Kenkneeshio/SeniorDesign-Team9/Pictures/Heatsink_2023-Sep-17_01-45-36PM-000_CustomizedView2093960837_png_alpha.png

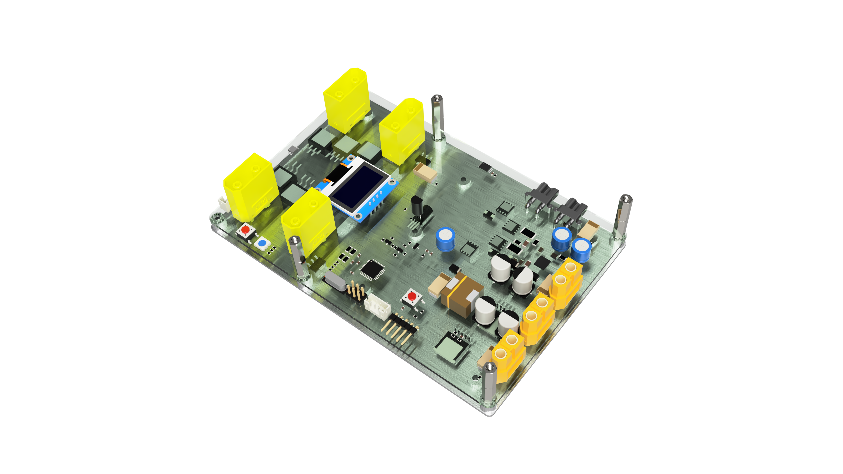
Pictures/Heatsink_2023-Sep-17_01-45-36PM-000_CustomizedView2093960837_png_alpha.png
