Kenkneeshio/SeniorDesign-Team9/README.md

# SeniorDesign-Team9

Currently the GitHub Repo ignores .zip and .raw to save space
