Kenkneeshio/SeniorDesign-Team9/Documentation/Prototype Activity Temperature scannings/FLIR0036.jpg

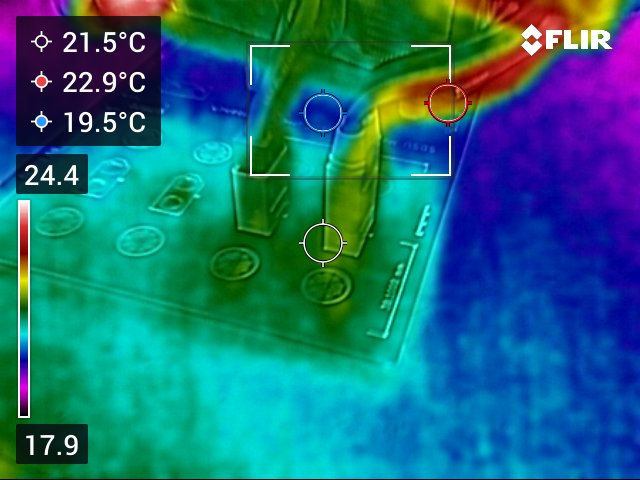
Documentation/Prototype Activity Temperature scannings/FLIR0036.jpg
