Kenkneeshio/SeniorDesign-Team9/Documentation/Prototype Activity Temperature scannings/FLIR0037.jpg

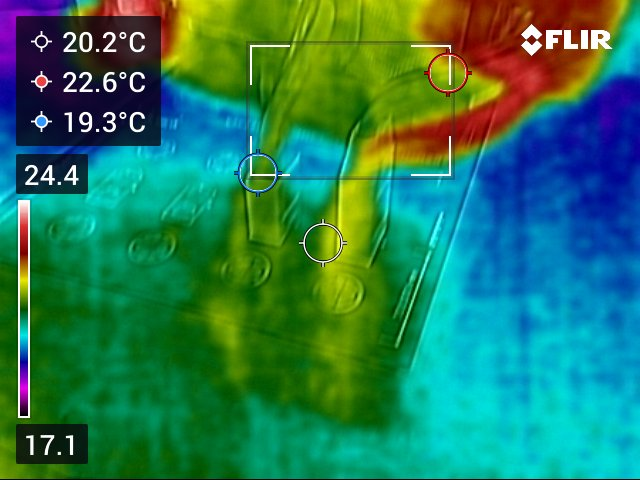
Documentation/Prototype Activity Temperature scannings/FLIR0037.jpg
