Kenkneeshio/SeniorDesign-Team9/Documentation/Prototype Activity Temperature scannings/FLIR0038.jpg

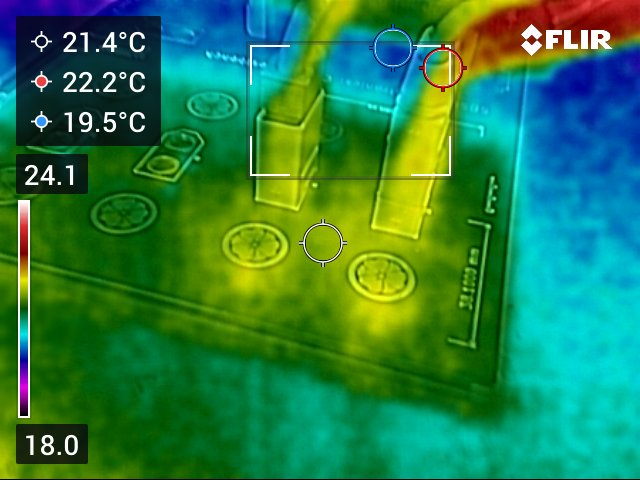
Documentation/Prototype Activity Temperature scannings/FLIR0038.jpg
