Kenkneeshio/SeniorDesign-Team9/Documentation/Prototype Activity Temperature scannings/FLIR0039.jpg

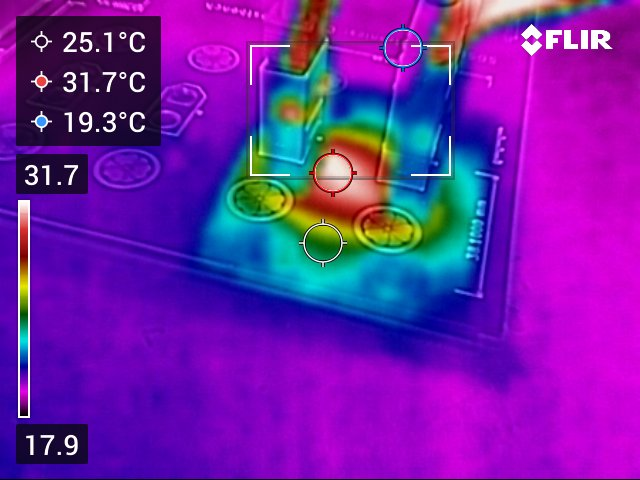
Documentation/Prototype Activity Temperature scannings/FLIR0039.jpg
