Kenkneeshio/SeniorDesign-Team9/Documents/Graphics/0PAL4100XP.png

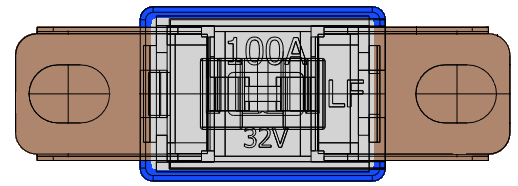
Documents/Graphics/0PAL4100XP.png
