Kenkneeshio/SeniorDesign-Team9/Documents/Graphics/bg.png

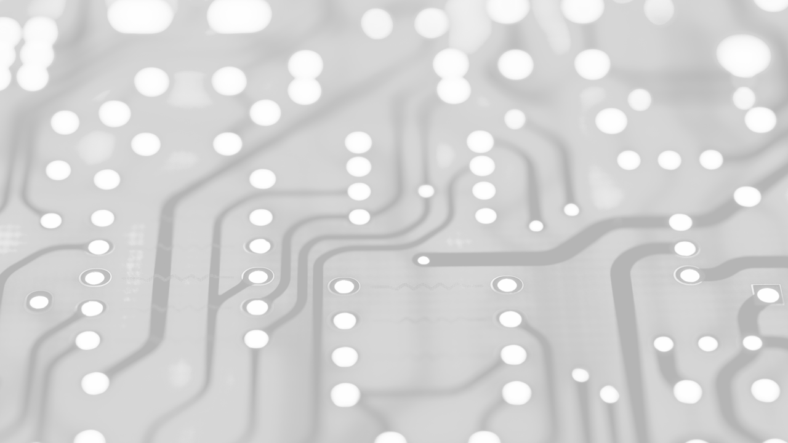
Documents/Graphics/bg.png
