Kenkneeshio/SeniorDesign-Team9/Documents/Graphics/current sharing.png

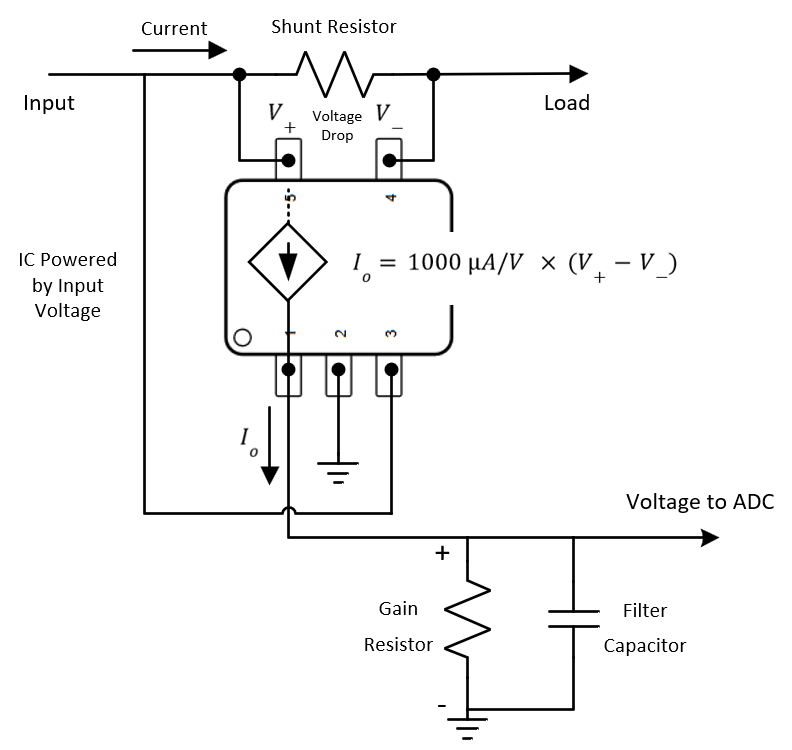
Documents/Graphics/current sharing.png
