Kenkneeshio/SeniorDesign-Team9/Documents/Graphics/load sharing.png

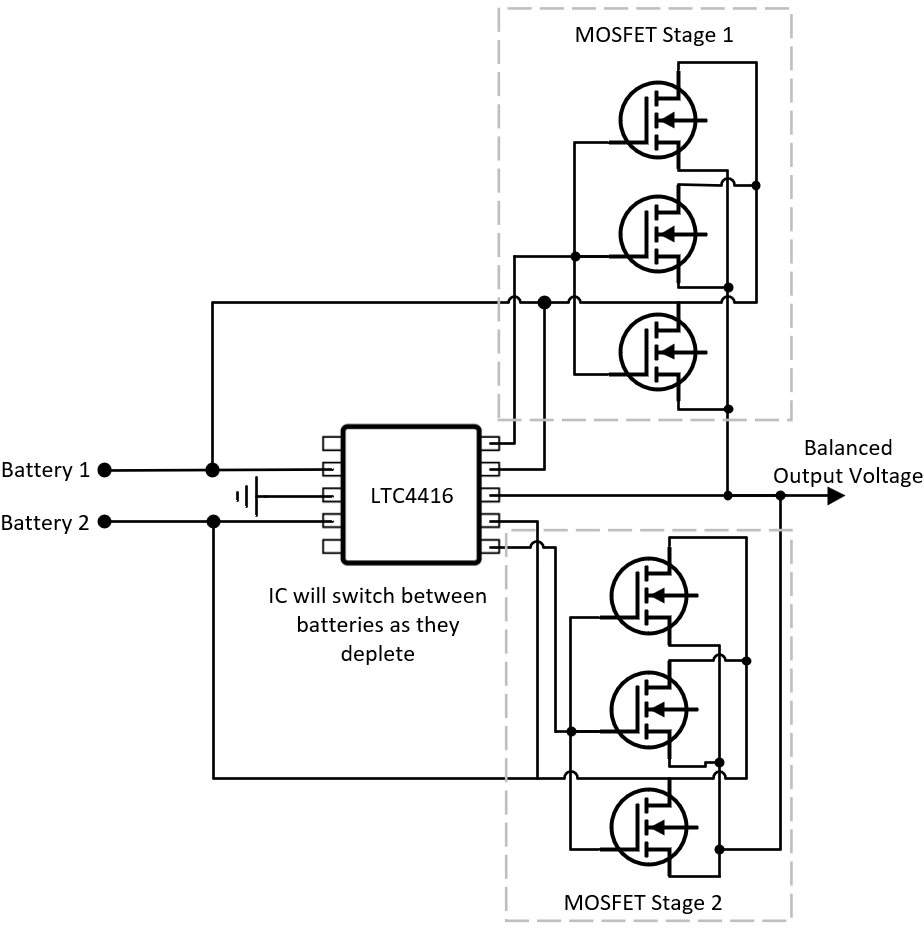
Documents/Graphics/load sharing.png
