Kenkneeshio/SeniorDesign-Team9/Documents/Graphics/microcontroller.png

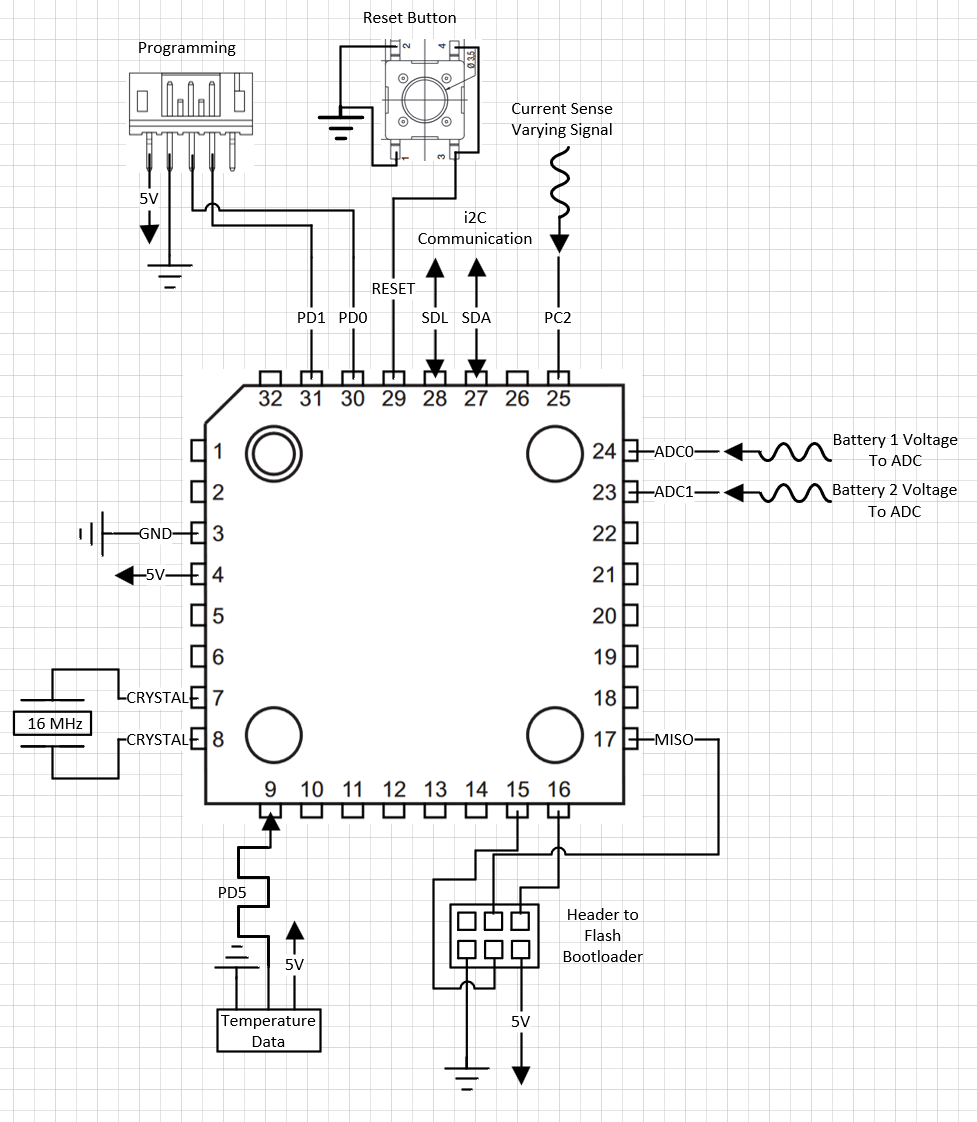
Documents/Graphics/microcontroller.png
