Kenkneeshio/SeniorDesign-Team9/Documents/Graphics/rps-01_board_only.png

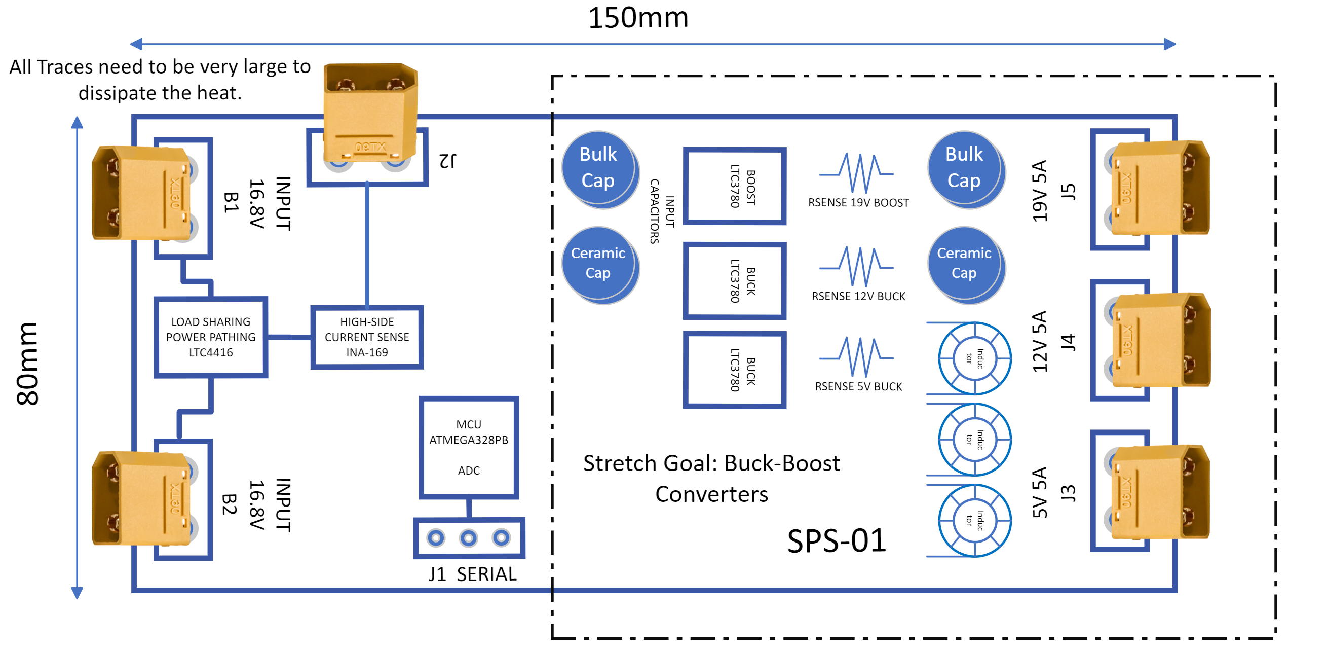
Documents/Graphics/rps-01_board_only.png
