Kenkneeshio/SeniorDesign-Team9/Documents/Graphics/rps-01_design_31023.png

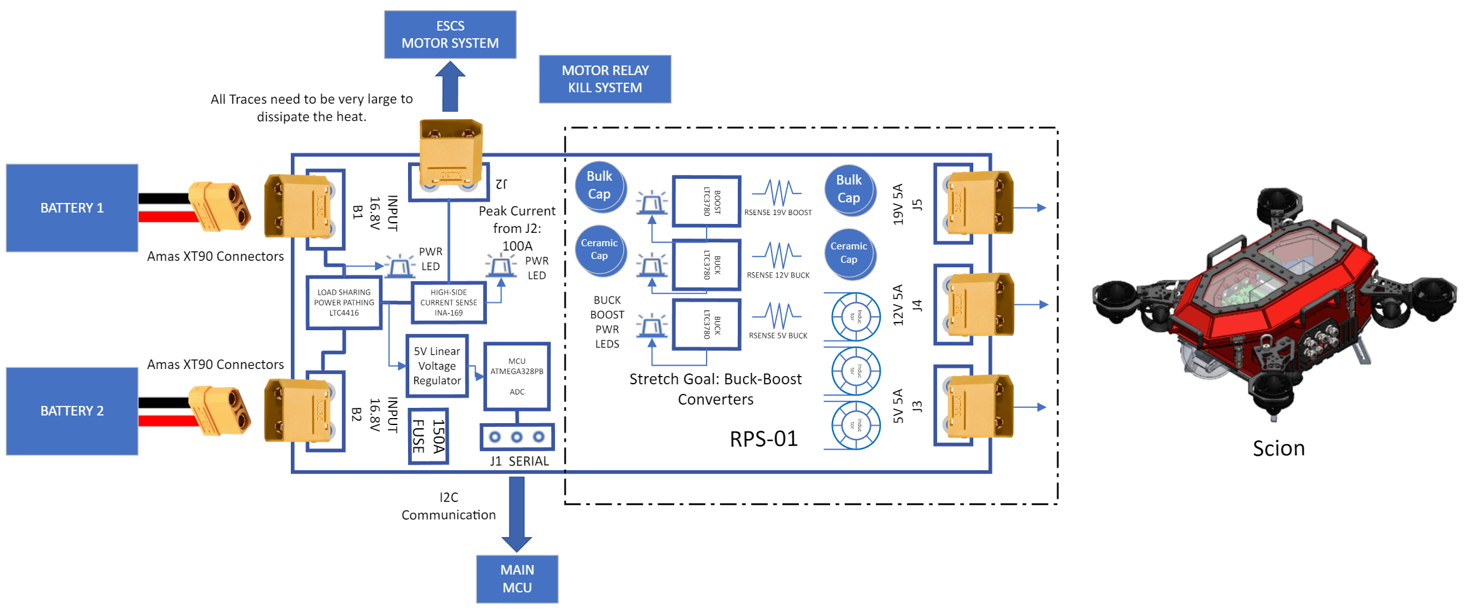
Documents/Graphics/rps-01_design_31023.png
