Kenkneeshio/SeniorDesign-Team9/Documents/Graphics/system design.png

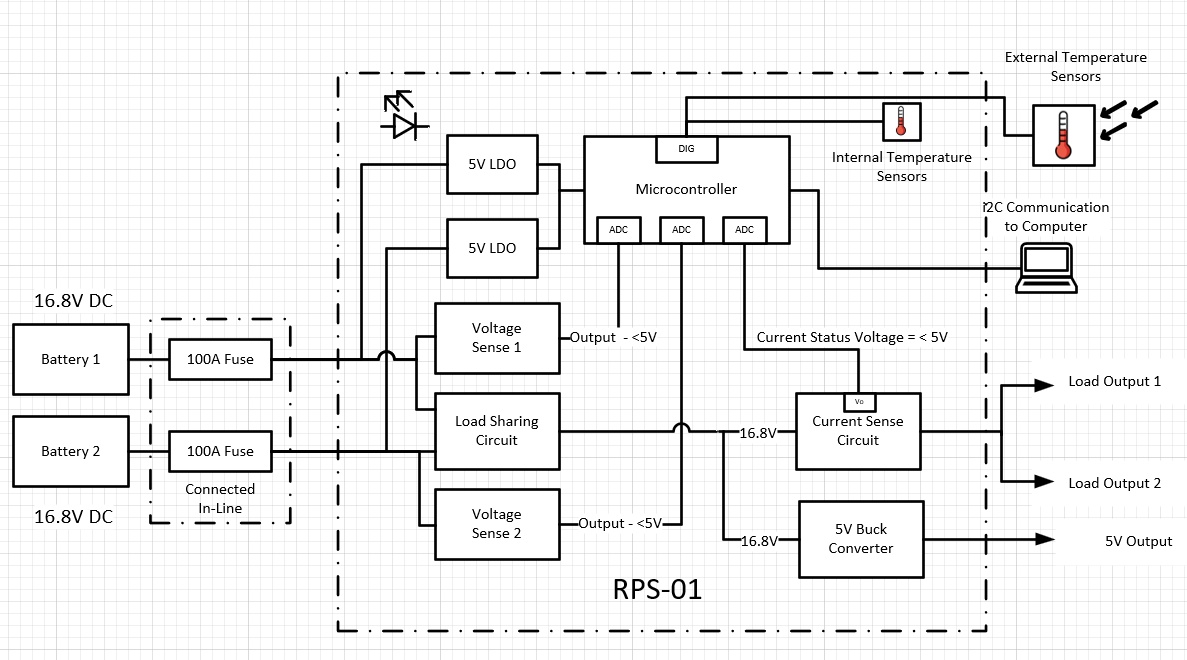
Documents/Graphics/system design.png
