Kenkneeshio/SeniorDesign-Team9/Documents/Graphics/xt90_male_warpfix.png

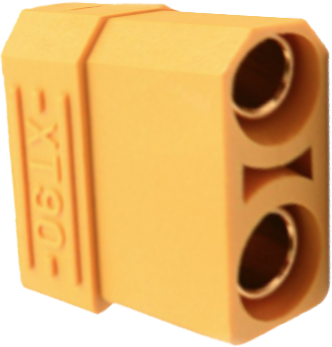
Documents/Graphics/xt90_male_warpfix.png
