Kenkneeshio/SeniorDesign-Team9/KiCad/RPS01-Revision 2/3d/render-bottom-heatsink.png

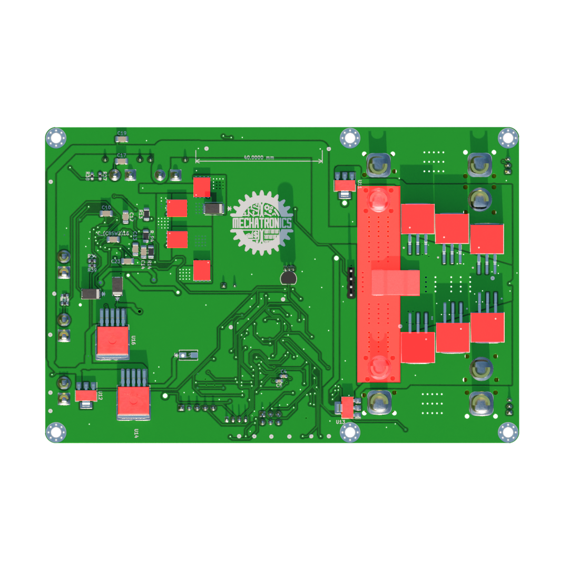
KiCad/RPS01-Revision 2/3d/render-bottom-heatsink.png
