Kenkneeshio/SeniorDesign-Team9/KiCad/Symbols Footprints and Models/0PAL4100XP/re-scale.png

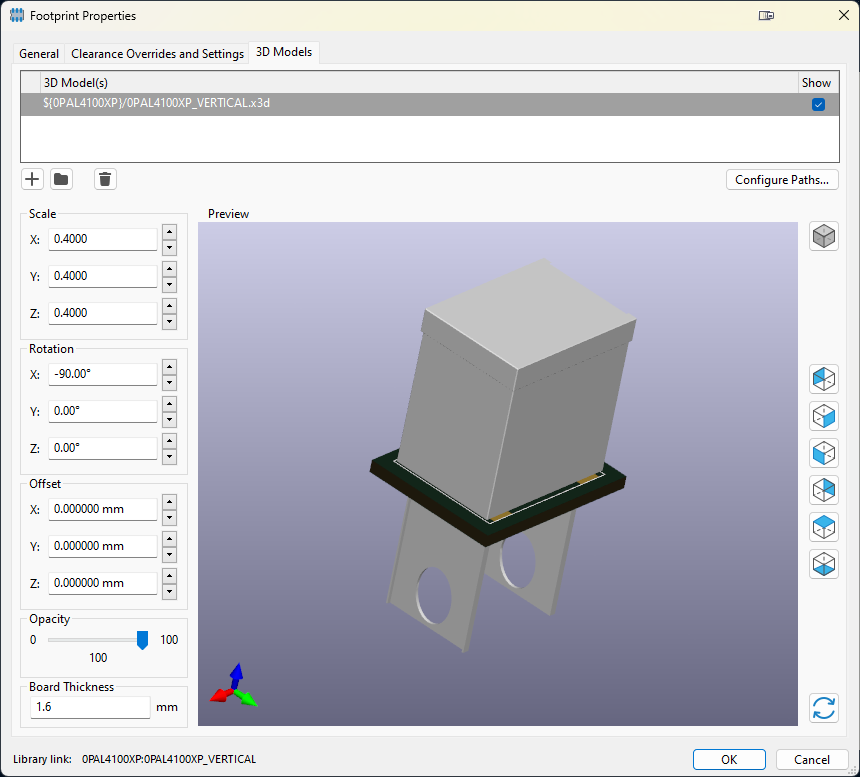
KiCad/Symbols Footprints and Models/0PAL4100XP/re-scale.png
