Kenkneeshio/SeniorDesign-Team9/Nice Mind vcminds/Mechatronics Disiciples.png

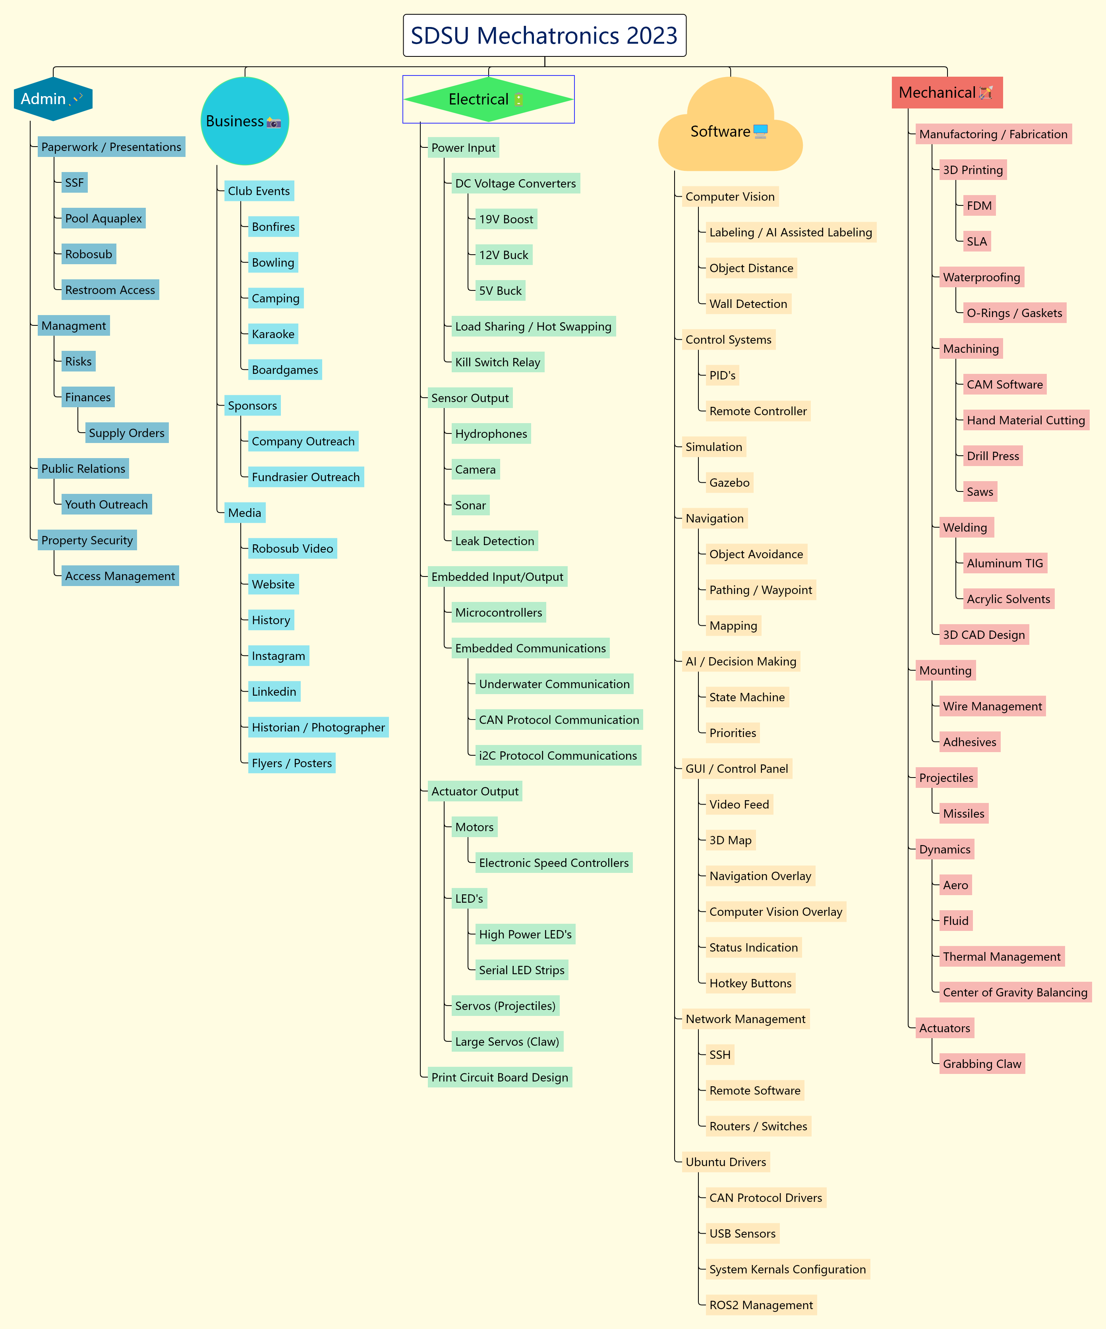
Nice Mind vcminds/Mechatronics Disiciples.png
