Kenkneeshio/SeniorDesign-Team9/Pictures/Heatsink_2023-Oct-08_06-53-45AM-000_CustomizedView12135911496_png.png

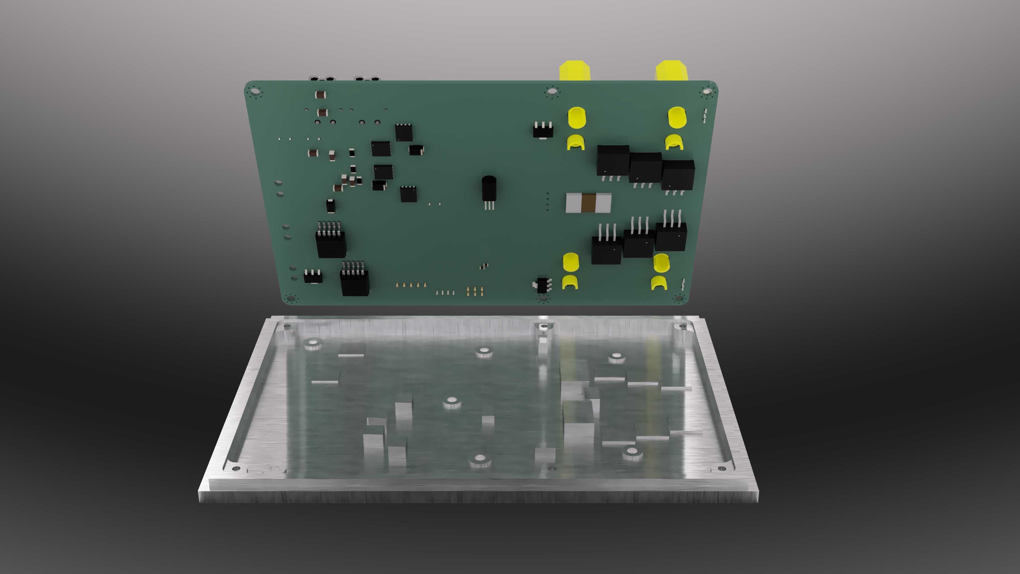
Pictures/Heatsink_2023-Oct-08_06-53-45AM-000_CustomizedView12135911496_png.png
