Kenkneeshio/SeniorDesign-Team9/Pictures/Heatsink_2023-Sep-17_01-18-48PM-000_CustomizedView3156353393_png_alpha.png

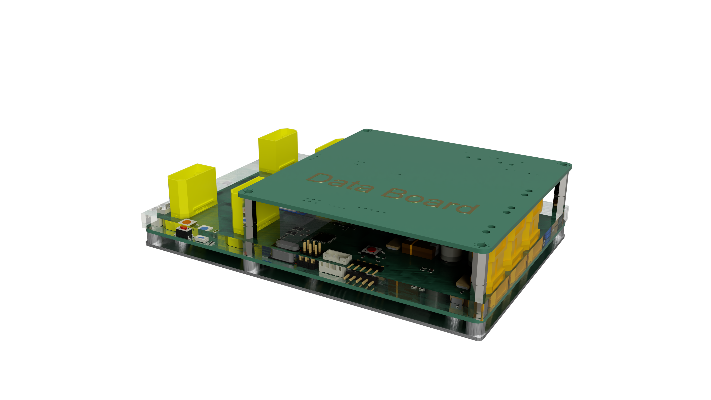
Pictures/Heatsink_2023-Sep-17_01-18-48PM-000_CustomizedView3156353393_png_alpha.png
