Kenkneeshio/SeniorDesign-Team9/Pictures/Heatsink_2023-Sep-17_01-31-28PM-000_CustomizedView29015575525_png.png

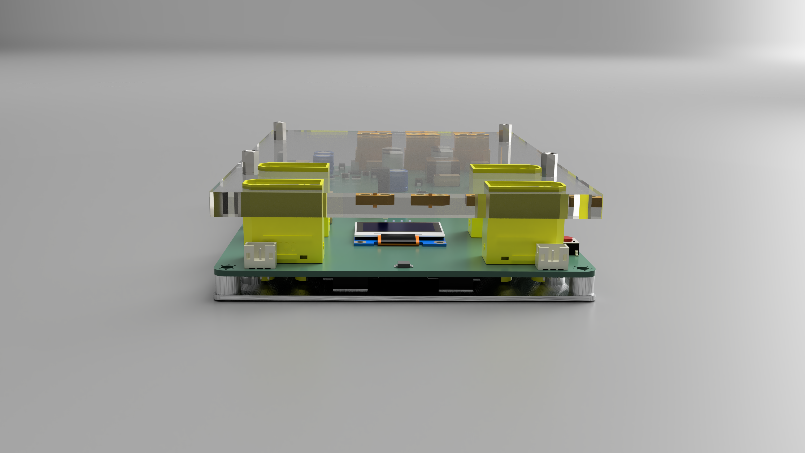
Pictures/Heatsink_2023-Sep-17_01-31-28PM-000_CustomizedView29015575525_png.png
