Kenkneeshio/SeniorDesign-Team9/Pictures/Heatsink_2023-Sep-21_07-10-01AM-000_CustomizedView16427578200_png_alpha.png

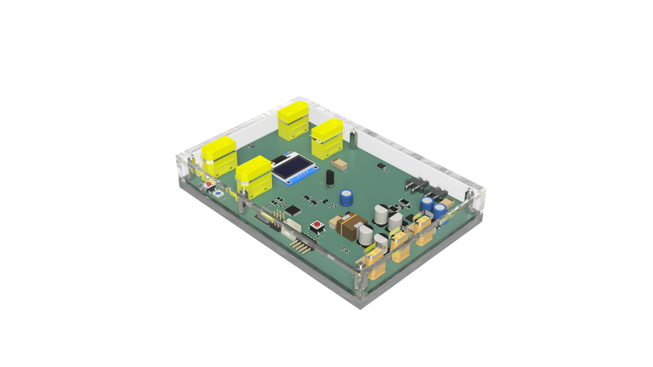
Pictures/Heatsink_2023-Sep-21_07-10-01AM-000_CustomizedView16427578200_png_alpha.png
