Kenkneeshio/SeniorDesign-Team9/Simulations/LTC3780 Reference Simulations and Resources/1155A reference PCB/1155acf.xls

Item | Qty | Reference | Part Description | Manufacturer / Part #
 |  | REQUIRED CIRCUIT COMPONENTS:
1 | 3 | C1,C2,C3 | CAP., X5R 10uF 35V 20% 1206 | TAIYO YUDEN GMK316BJ106ML-T
2 | 3 | C4,C10,C22 | CAP., X5R 0.22uF 16V 20% 0603 | TAIYO YUDEN EMK107BJ224MA-T
3 | 3 | C5,C6,C9 | CAP., X5R 22uF 16V 20% 1210 | TAIYO YUDEN EMK325BJ226MM-T
4 | 1 | C11 | CAP., NPO 68pF 50V 10% 0603 | AVX 06035A680KAT2A
5 | 1 | C12 | CAP., X7R 3.3nF 25V 10% 0603 | AVX 06033C3300KAT2A
6 | 1 | C23 | CAP., X7R 0.01uF 25V 10% 0603 | AVX 06033C103KAT2A
7 | 1 | C13 | CAP., NPO 47pF 50V 10% 0603 | AVX 06035A470KAT2A
8 | 1 | C14 | CAP., X7R 0.1uF 50V 10% 0603 | TAIYO YUDEN UMK107BJ104MA-T
9 | 1 | C15 | CAP., X5R 1uF 10V 20% 0603 | TAIYO YUDEN LMK107BJ105MA-T
10 | 1 | C18 | CAP., X5R 4.7uF 10V 20% 0603 | TAIYO YUDEN LMK107BJ475MA-T
11 | 2 | C21,C19 | CAP., NPO 1000pF 25V 10% 0603 | AVX 06033A102KAT2A
12 | 1 | C24 | CAP., NPO 1nF 50V 10% 0603 | AVX 06035A102KAT2A
13 | 1 | D1 | Zener Diode, 4.7V SOD-523 | On Semi. MM5Z4V7T1G
14 | 1 | D3 | Zener Diode, 36V SOT-23 | DIODES INC. BZX84C36-7-F
15 | 3 | D4,D6,D7 | Schottky Barrier Diode SOD-123 | DIODES INC. B0540W-7
16 | 1 | D5 | Schottky Barrier Diode SOD-123 | DIODES INC. 1N5819HW-7-F
17 | 1 | L1 | INDUCTOR, 10uH | VISHAY , IHLP-4040DZER10R0M11
18 | 2 | Q1,Q2 | DUAL N-CHANMOSFET., 40V SO8 | VISHAY SILICONIX SI4942DY-T1-E3
19 | 2 | R5,R8 | RES., CHIP 10 0.1W 5% 0603 | VISHAY, CRCW060310R0JNEA
20 | 1 | R7 | RES., CHIP 10K 0.1W 5% 0603 | VISHAY, CRCW060310K0JNEA
21 | 1 | R20 | RES., CHIP 12.4K 0.1W 1% 0603 | VISHAY, CRCW060312K4FKEA
22 | 2 | R9,R10 | RES., CHIP 100 0.1W 1% 0603 | VISHAY, CRCW0603100RFKEA
23 | 1 | R11 | RES., CHIP 30K 0.1W 5% 0603 | VISHAY, CRCW060330K0JNEA
24 | 1 | R12 | RES., CHIP 113K 0.1W 1% 0603 | VISHAY, CRCW0603113KFKEA
25 | 1 | R13 | RES., CHIP 8.06K 0.1W 1% 0603 | VISHAY, CRCW06038K06FKEA
26 | 1 | R15 | RES., CHIP 51K 0.1W 5% 0603 | VISHAY, CRCW060351K0JNEA
27 | 1 | R19 | RES., CHIP 0.025 1W 1% 0815 | SSM Thin Film Tech. RL3720WT-R025-G-C
28 | 1 | R23 | RES., CHIP 47.5K 0.1W 1% 0603 | VISHAY, CRCW060347K5FKEA
29 | 1 | R25 | RES., CHIP 1 0.1W 5% 0603 | VISHAY, CRCW06031R00JNEA
30 | 2 | R24,R26 | RES., CHIP 0 0.1W 0603 | VISHAY, CRCW06030000Z0EA
31 | 1 | U1 | LTC3780EUH#PBF,5X5mm QFN | LINEAR TECH., LTC3780EUH#PBF
 |  | ADDITIONAL DEMO BOARD CIRCUIT COMPONENTS:
1 | 0 | C16,C20(OPT) | CAP., 0603
2 | 0 | C7,C8(OPT) | CAP., POSCAP D4 SIZE
3 | 0 | R17,R21,R22 (OPT) | RES., 0603
 |  | HARDWARE-FOR DEMO BOARD ONLY:
1 | 1 | JP1 | Headers, 3 Pins 2mm Ctrs. | SAMTEC TMM-103-02-L-S
2 | 3 | JP2A,JP2B,JP2C | Headers, 2 Pins 2mm Ctrs. | SAMTEC TMM-102-02-L-S
3 | 2 | JP1,JP2B | Shunt | SAMTEC 2SN-BK-G
4 | 8 | TP1-TP6,TP8,TP10 | TESTPOINT | MILL-MAX, 2501-2-00-80-00-00-07-00
