Kenkneeshio/SeniorDesign-Team9/CAD Models/0154Series_LTF/0154Series_LTF.step

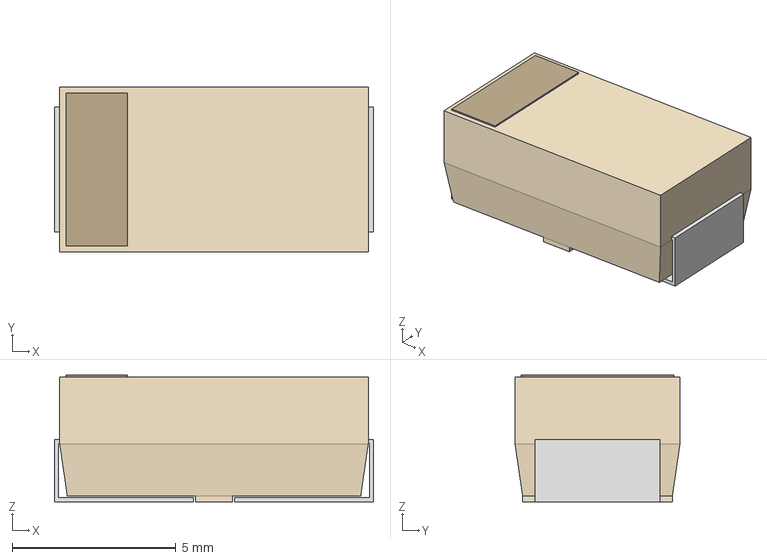
[picture p28: CAD file, 2023-09-11]
CAD Models/0154Series_LTF/0154Series_LTF.step
9.73 x 5.03 x 3.86 mm
