Kenkneeshio/SeniorDesign-Team9/CAD Models/CAP_A750KS_KEM/CAP_A750KS_KEM.step

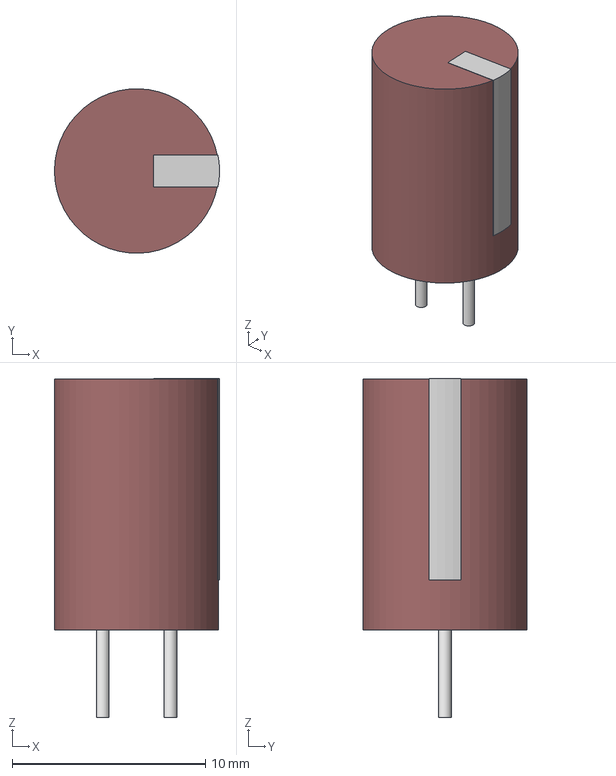
[picture p29: CAD file, 2023-09-13]
CAD Models/CAP_A750KS_KEM/CAP_A750KS_KEM.step
8.54 x 8.50 x 17.5 mm
