Kenkneeshio/SeniorDesign-Team9/CAD Models/IND_CDRH127LDNP-470MC_SUM/IND_CDRH127LDNP-470MC_SUM.step

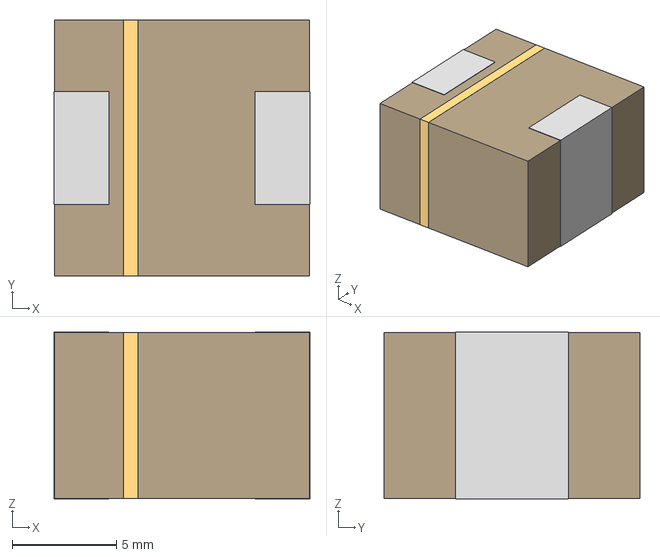
[picture p30: CAD file, 2023-09-12]
CAD Models/IND_CDRH127LDNP-470MC_SUM/IND_CDRH127LDNP-470MC_SUM.step
12.3 x 12.3 x 8.00 mm
