Kenkneeshio/SeniorDesign-Team9/CAD Models/MSOP-10_MS_LIT/MSOP-10_MS_LIT.step

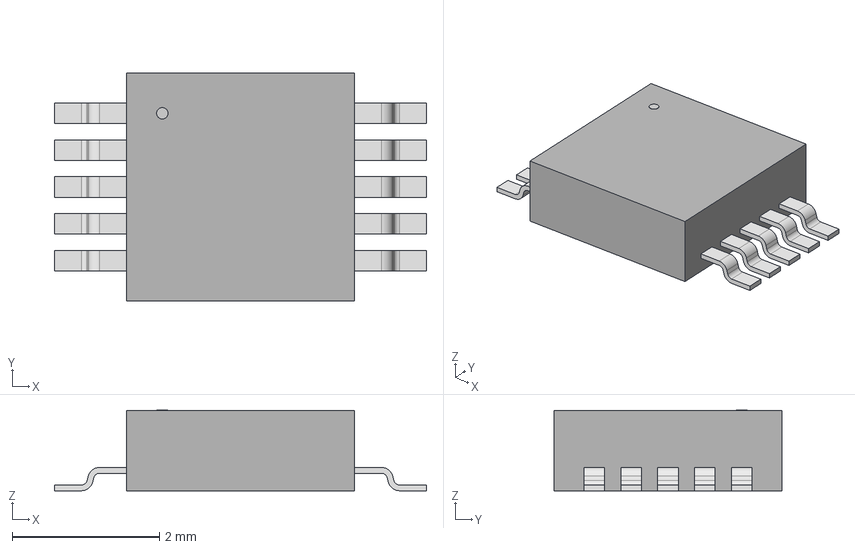
[picture p31: CAD file, 2023-09-11]
CAD Models/MSOP-10_MS_LIT/MSOP-10_MS_LIT.step
5.05 x 3.10 x 1.09 mm
