Kenkneeshio/SeniorDesign-Team9/CAD Models/PG-TDSON-8-U08_INF/PG-TDSON-8-U08_INF.step

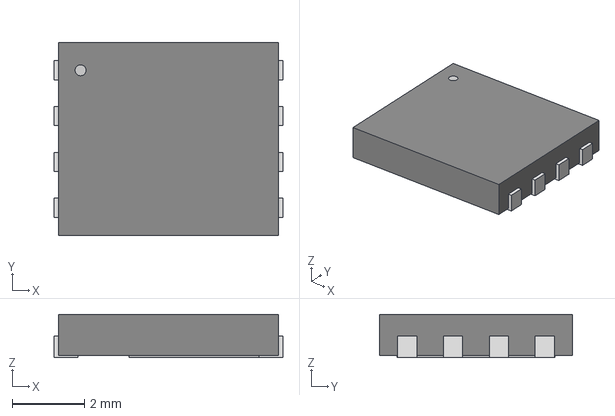
[picture p32: CAD file, 2023-09-12]
CAD Models/PG-TDSON-8-U08_INF/PG-TDSON-8-U08_INF.step
6.35 x 5.36 x 1.20 mm
