Kenkneeshio/SeniorDesign-Team9/CAD Models/PRSS0004AL-A_REN/PRSS0004AL-A_REN.step

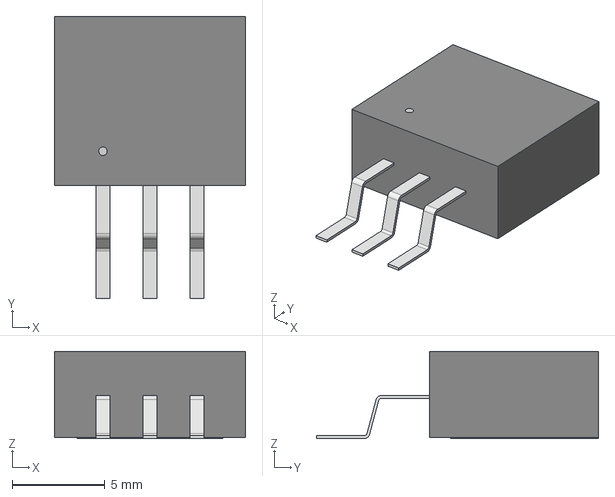
[picture p33: CAD file, 2023-09-11]
CAD Models/PRSS0004AL-A_REN/PRSS0004AL-A_REN.step
10.3 x 15.2 x 4.70 mm
