Kenkneeshio/SeniorDesign-Team9/CAD Models/PW8_TEX/PW8_TEX.step

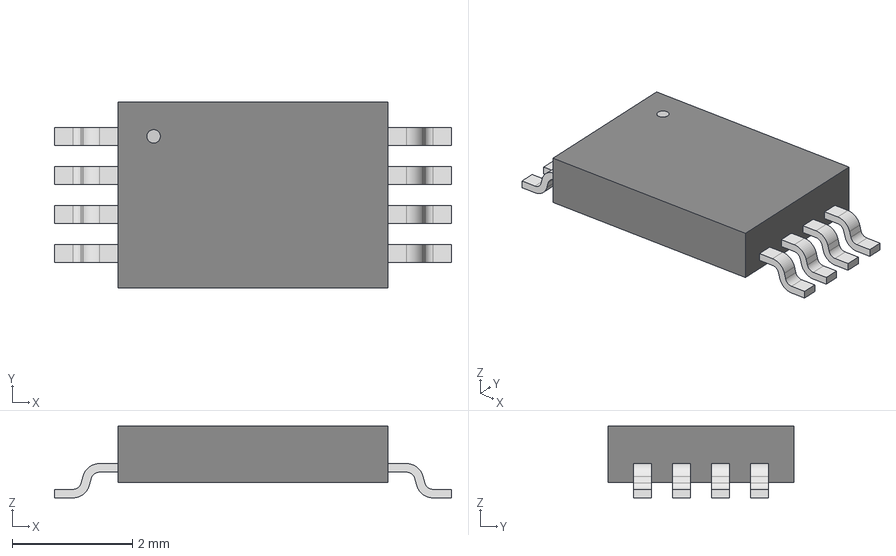
[picture p34: CAD file, 2023-09-11]
CAD Models/PW8_TEX/PW8_TEX.step
6.60 x 3.10 x 1.20 mm
