Kenkneeshio/SeniorDesign-Team9/CAD Models/QFN-32_UH_LIT/QFN-32_UH_LIT.step

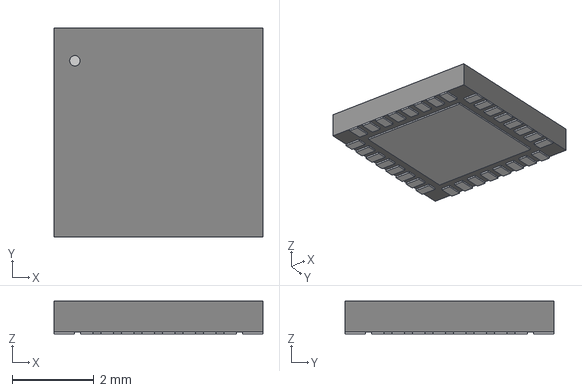
[picture p35: CAD file, 2023-09-13]
CAD Models/QFN-32_UH_LIT/QFN-32_UH_LIT.step
5.10 x 5.10 x 0.803 mm
