Kenkneeshio/SeniorDesign-Team9/CAD Models/RES_5930R_L500x_BRN/RES_5930R_L500x_BRN.step

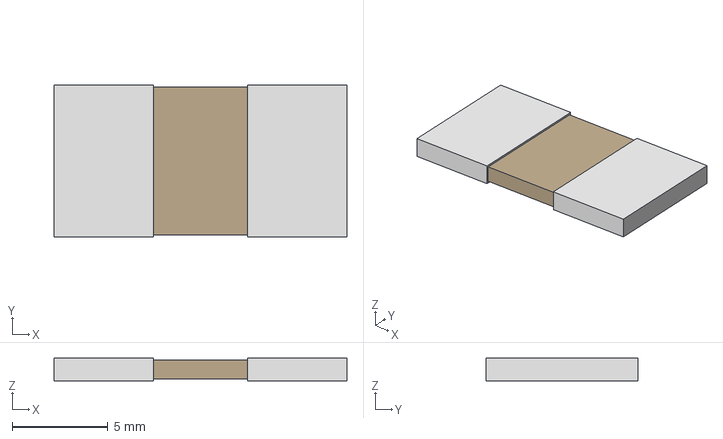
[picture p36: CAD file, 2023-09-11]
CAD Models/RES_5930R_L500x_BRN/RES_5930R_L500x_BRN.step
15.3 x 7.92 x 1.19 mm
