Kenkneeshio/SeniorDesign-Team9/CAD Models/TS2940CW50_RPG.step

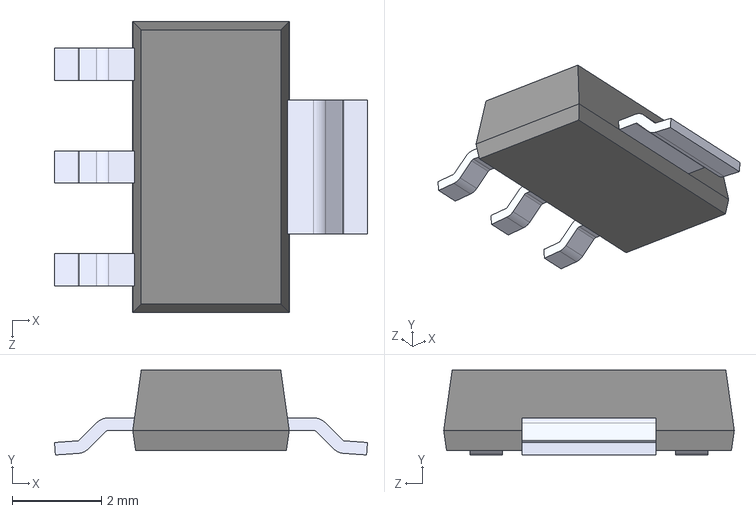
[picture p37: CAD file, 2023-11-14]
CAD Models/TS2940CW50_RPG.step
7.00 x 1.90 x 6.50 mm
