Kenkneeshio/SeniorDesign-Team9/CAD Models/User Library-128x64I2COLEDDisplayAdafruit/User Library-128x64I2COLEDDisplayAdafruit.STEP

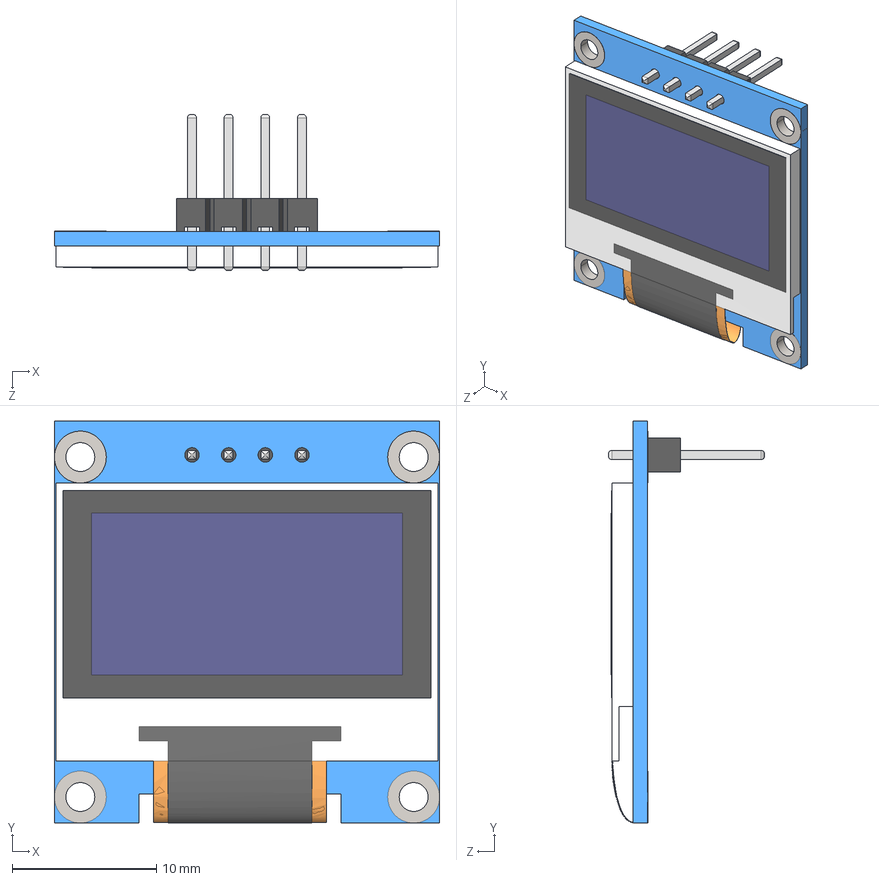
[picture p38: CAD file, 2023-09-08]
CAD Models/User Library-128x64I2COLEDDisplayAdafruit/User Library-128x64I2COLEDDisplayAdafruit.STEP
26.7 x 27.9 x 10.8 mm
