Kenkneeshio/SeniorDesign-Team9/CAD Models/User Library-XT90PB-F/User Library-XT90PB-F.STEP

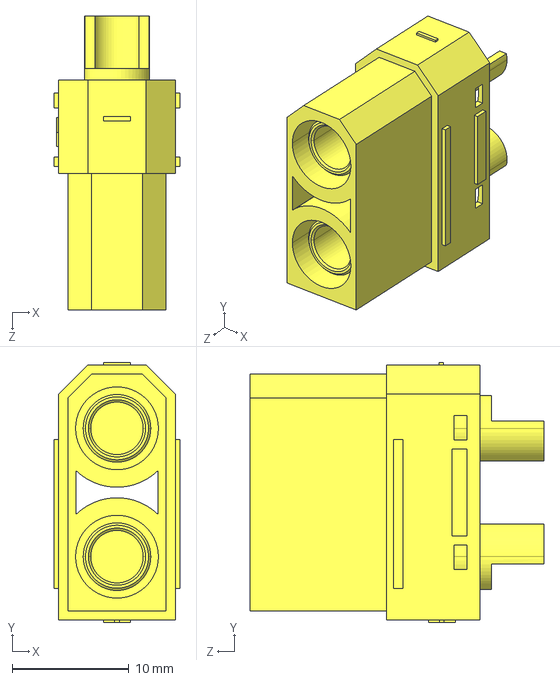
[picture p39: CAD file, 2023-09-08]
CAD Models/User Library-XT90PB-F/User Library-XT90PB-F.STEP
10.8 x 22.3 x 25.2 mm
