Kenkneeshio/SeniorDesign-Team9/CAD Models/User Library-XT90PB-M/User Library-XT90PB-M.STEP

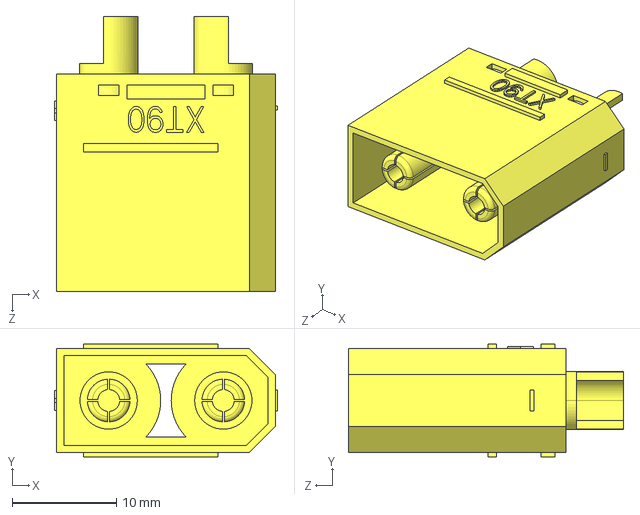
[picture p40: CAD file, 2023-09-08]
CAD Models/User Library-XT90PB-M/User Library-XT90PB-M.STEP
21.4 x 10.8 x 26.4 mm
