Kenkneeshio/SeniorDesign-Team9/CAD Models/xt30-f/User Library-xt30-f.STEP

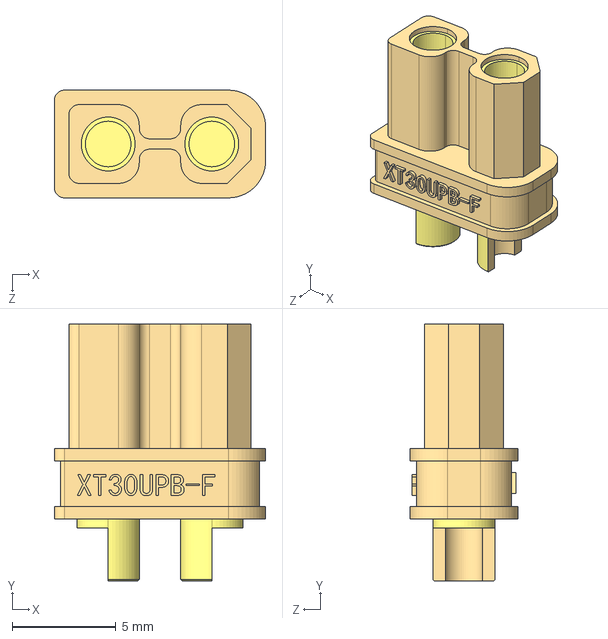
[picture p41: CAD file, 2023-09-17]
CAD Models/xt30-f/User Library-xt30-f.STEP
10.2 x 12.4 x 5.20 mm
