Kenkneeshio/SeniorDesign-Team9/CAD Models/XT30PW-F--3DModel-STEP-510211/XT30PW-F--3DModel-STEP-510211.STEP

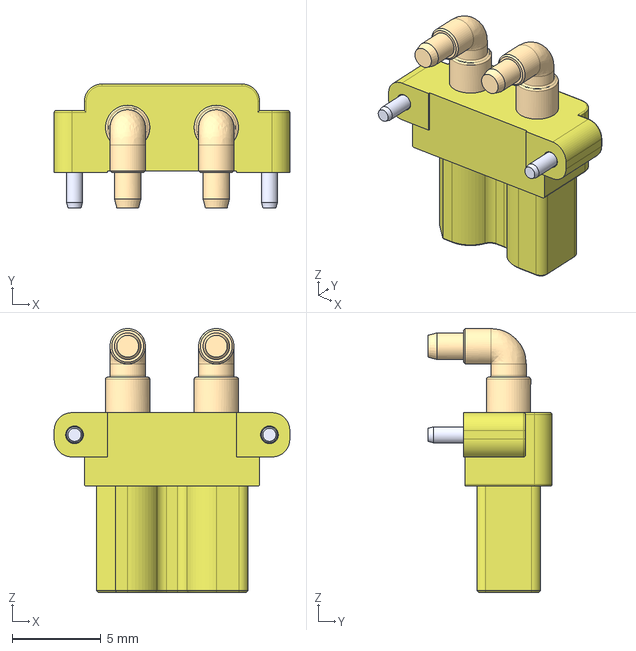
[picture p42: CAD file, 2023-09-13]
CAD Models/XT30PW-F--3DModel-STEP-510211/XT30PW-F--3DModel-STEP-510211.STEP
13.3 x 7.00 x 14.9 mm
