Kenkneeshio/SeniorDesign-Team9/CAD Models/xt30upb-m/User Library-xt30upb-m.STEP

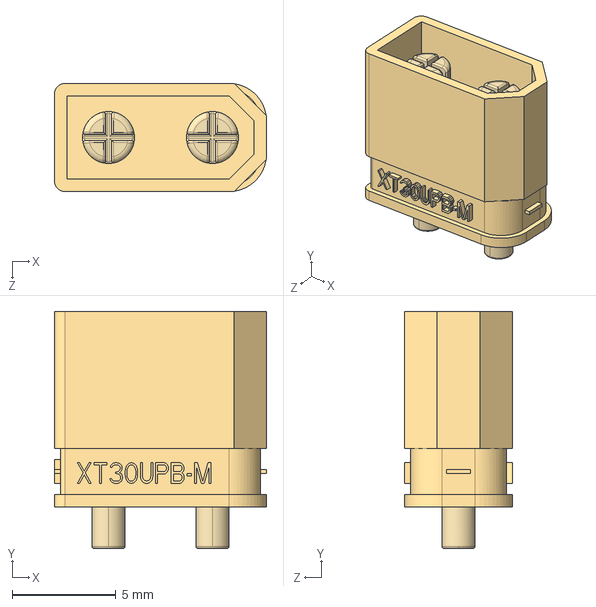
[picture p43: CAD file, 2023-09-17]
CAD Models/xt30upb-m/User Library-xt30upb-m.STEP
10.2 x 11.4 x 5.20 mm
XT30UPB-M
XT30UPB-M-PIN x 2
