Kenkneeshio/SeniorDesign-Team9/KiCad/Symbols Footprints and Models/ADR02AUJZ-REEL7/ADR02AUJZ-REEL7.step

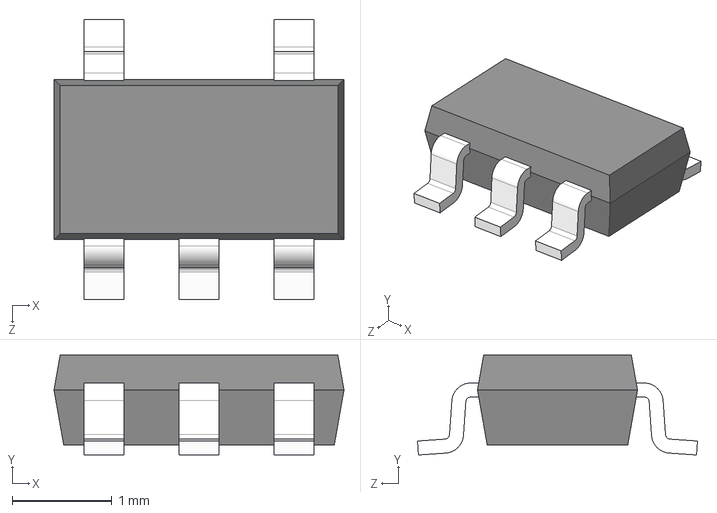
[picture p44: CAD file, 2023-09-15]
KiCad/Symbols Footprints and Models/ADR02AUJZ-REEL7/ADR02AUJZ-REEL7.step
2.90 x 1.00 x 2.80 mm
