Kenkneeshio/SeniorDesign-Team9/KiCad/Symbols Footprints and Models/LM2596SX-ADJ/LM2596SX-ADJ.step

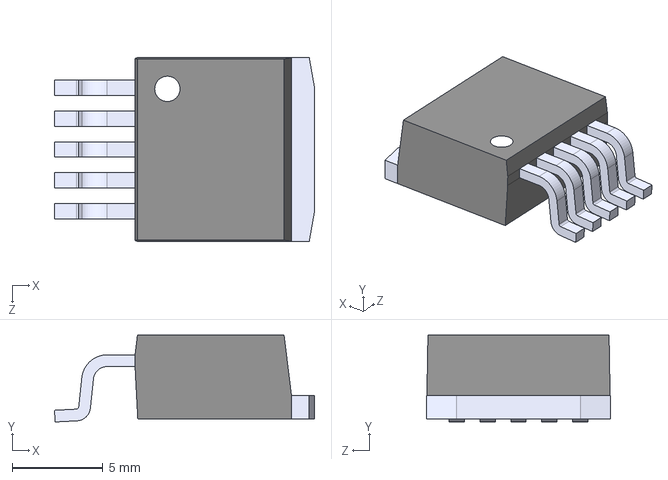
[picture p45: CAD file, 2023-09-07]
KiCad/Symbols Footprints and Models/LM2596SX-ADJ/LM2596SX-ADJ.step
14.4 x 4.80 x 10.2 mm
