Kenkneeshio/SeniorDesign-Team9/KiCad/Symbols Footprints and Models/RC1206FR-13100KL/RC1206FR-13100KL.step

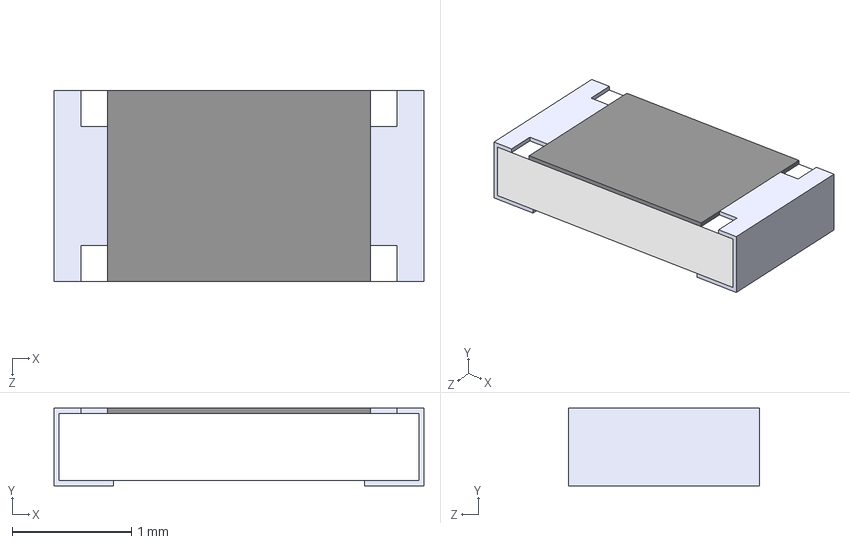
[picture p46: CAD file, 2023-06-26]
KiCad/Symbols Footprints and Models/RC1206FR-13100KL/RC1206FR-13100KL.step
3.10 x 0.65 x 1.60 mm
