Kenkneeshio/SeniorDesign-Team9/KiCad/Symbols Footprints and Models/Res_Bourns_CSS2H-3920R-L300F/eec.models/Bourns_-_CSS2H-3920R-L300F.step

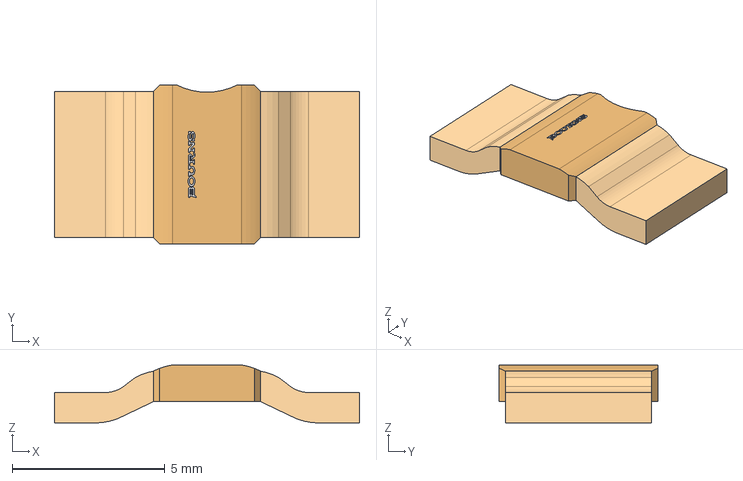
[picture p47: CAD file, 2023-06-23]
KiCad/Symbols Footprints and Models/Res_Bourns_CSS2H-3920R-L300F/eec.models/Bourns_-_CSS2H-3920R-L300F.step
10.0 x 5.20 x 1.90 mm
