Kenkneeshio/SeniorDesign-Team9/CAD Models/Acrylic Top.stl

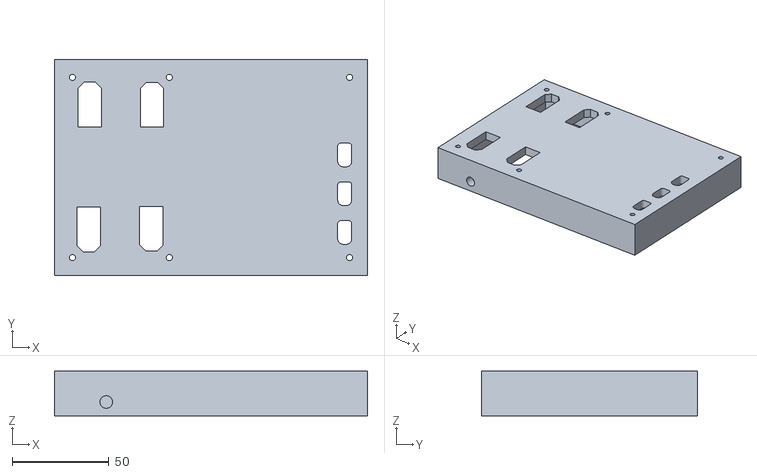
[picture p48: CAD file, 2023-09-22]
CAD Models/Acrylic Top.stl
161.5 x 111.5 x 23.0
