Kenkneeshio/SeniorDesign-Team9/CAD Models/Acyrlic Top One Piece.3mf

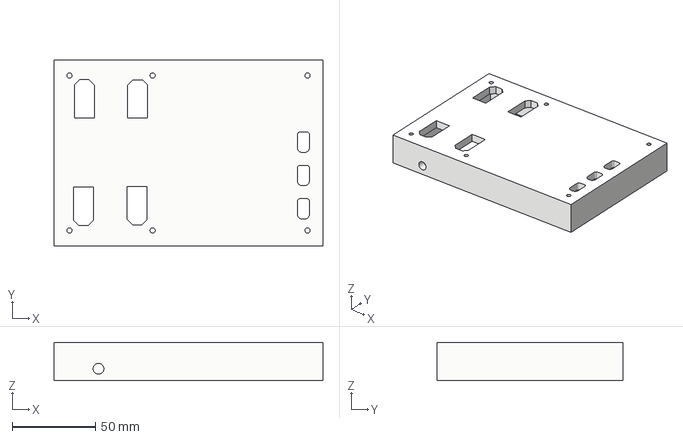
[picture p50: CAD file, 2023-09-22]
CAD Models/Acyrlic Top One Piece.3mf
161.5 x 111.5 x 23.0 mm
