Kenkneeshio/SeniorDesign-Team9/CAD Models/Aluminum Heatsink.3mf

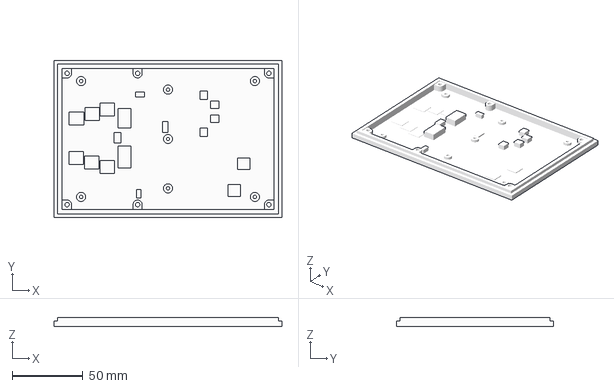
[picture p51: CAD file, 2023-09-22]
CAD Models/Aluminum Heatsink.3mf
161.5 x 111.5 x 6.50 mm
