Kenkneeshio/SeniorDesign-Team9/(list of files, cad)

Other CAD files:
CAD Models/74436410680/74436410680.blend
CAD Models/Aluminum Heatsink.stl
CAD Models/Fuse/fuse.blend
Documents/Graphics/rps01.blend
KiCad/RPS01-Revision 0/rps01/rps01.step
KiCad/Symbols Footprints and Models/0PAL4100XP/0PAL4100XP.blend
