Kenkneeshio/SeniorDesign-Team9/Mechanical Drawings/RPS Mechanical Drawings.pdf

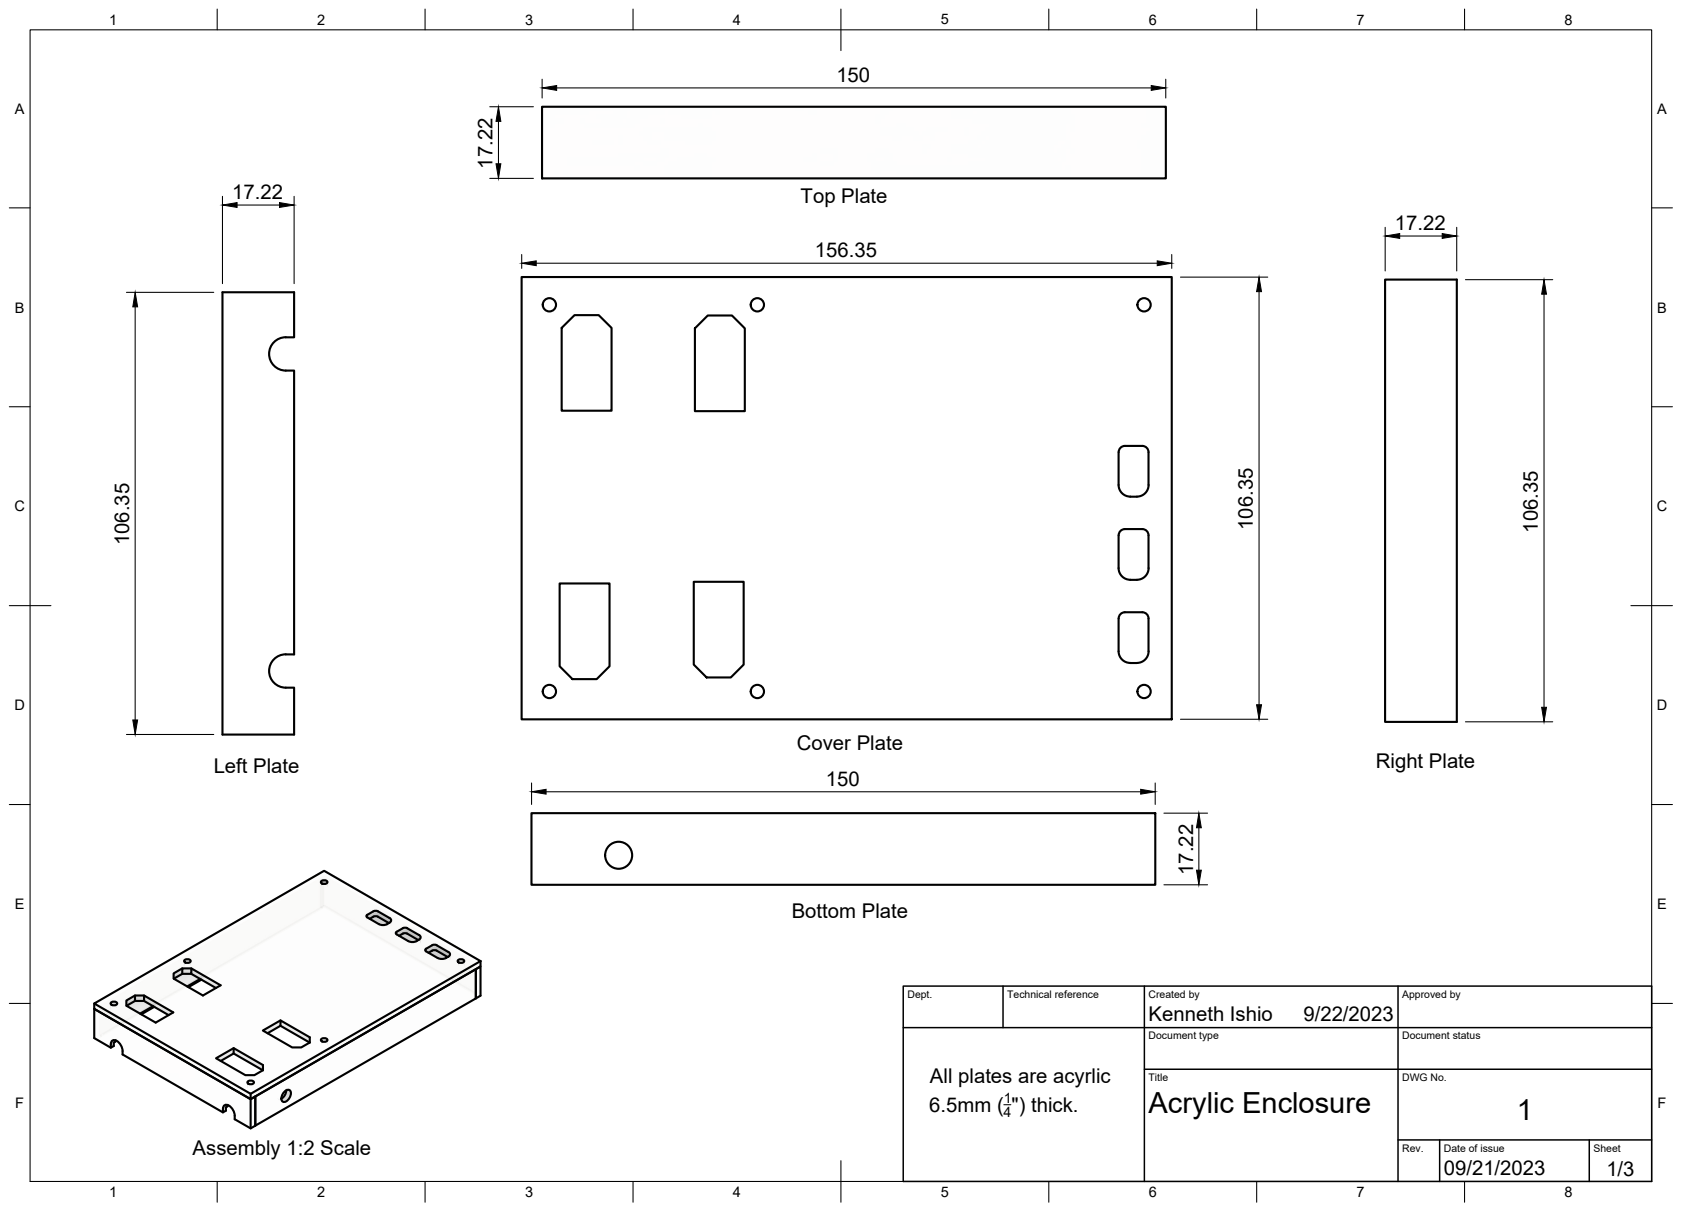
[picture p52: page 1]
Title; DWG No.; Rev.; Date of issue; Sheet; Acrylic Enclosure; Cover Plate; Left Plate; Right Plate; Bottom Plate; Top Plate; Assembly 1:2 Scale 106.35; ") thick.

Dept. | Technical reference | Created by Kenneth Ishio 9/22/2023 | Approved by

Document type | Document status

All plates are acyrlic

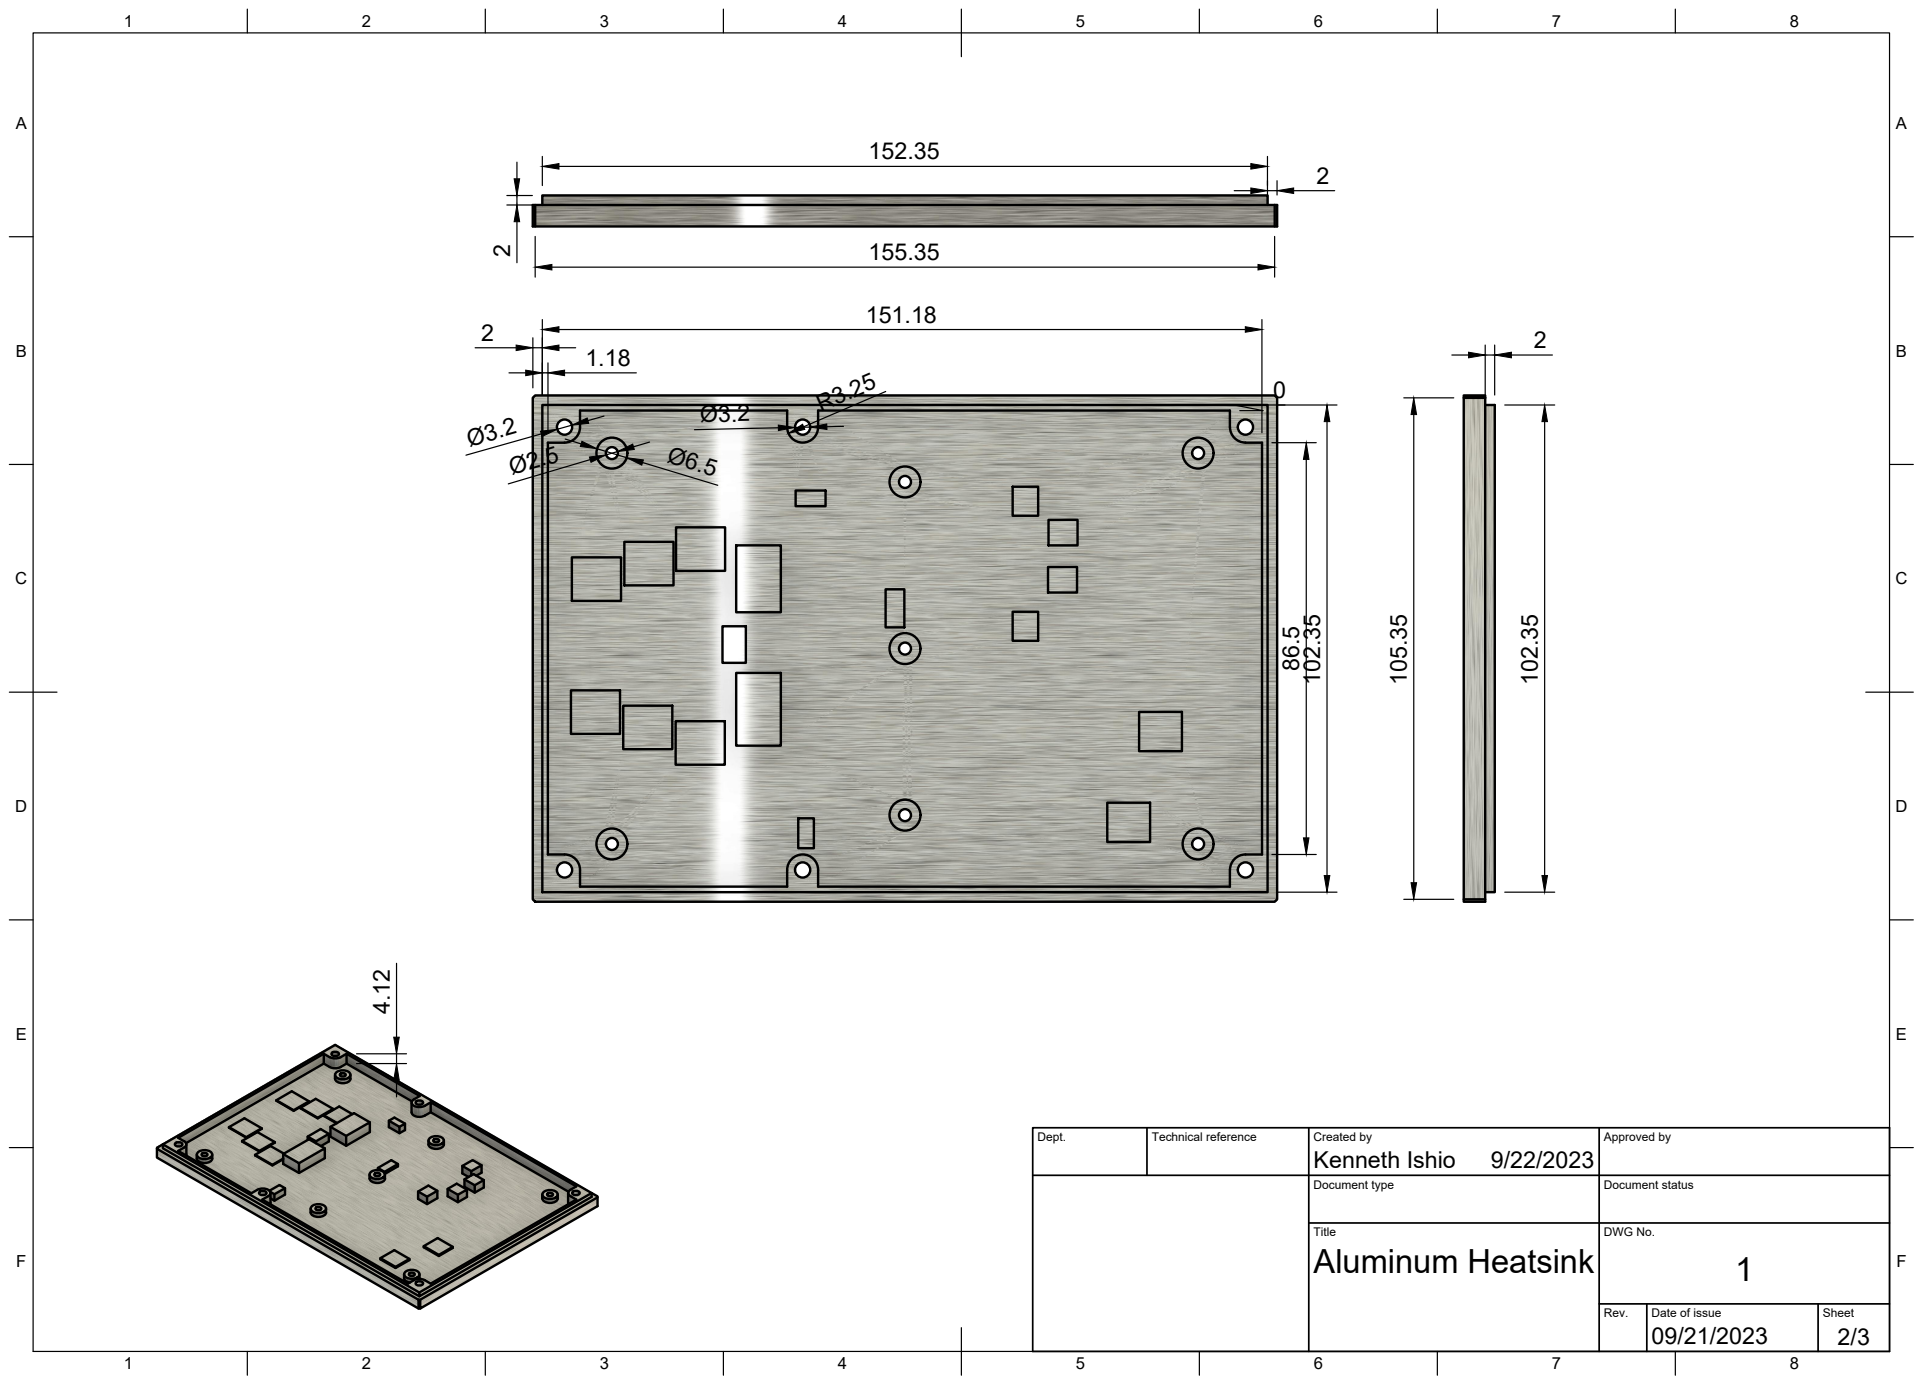
[picture p53: page 2]
Title; DWG No.; Aluminum Heatsink

Dept. | Technical reference | Created by Kenneth Ishio 9/22/2023 | Approved by

Document type | Document status

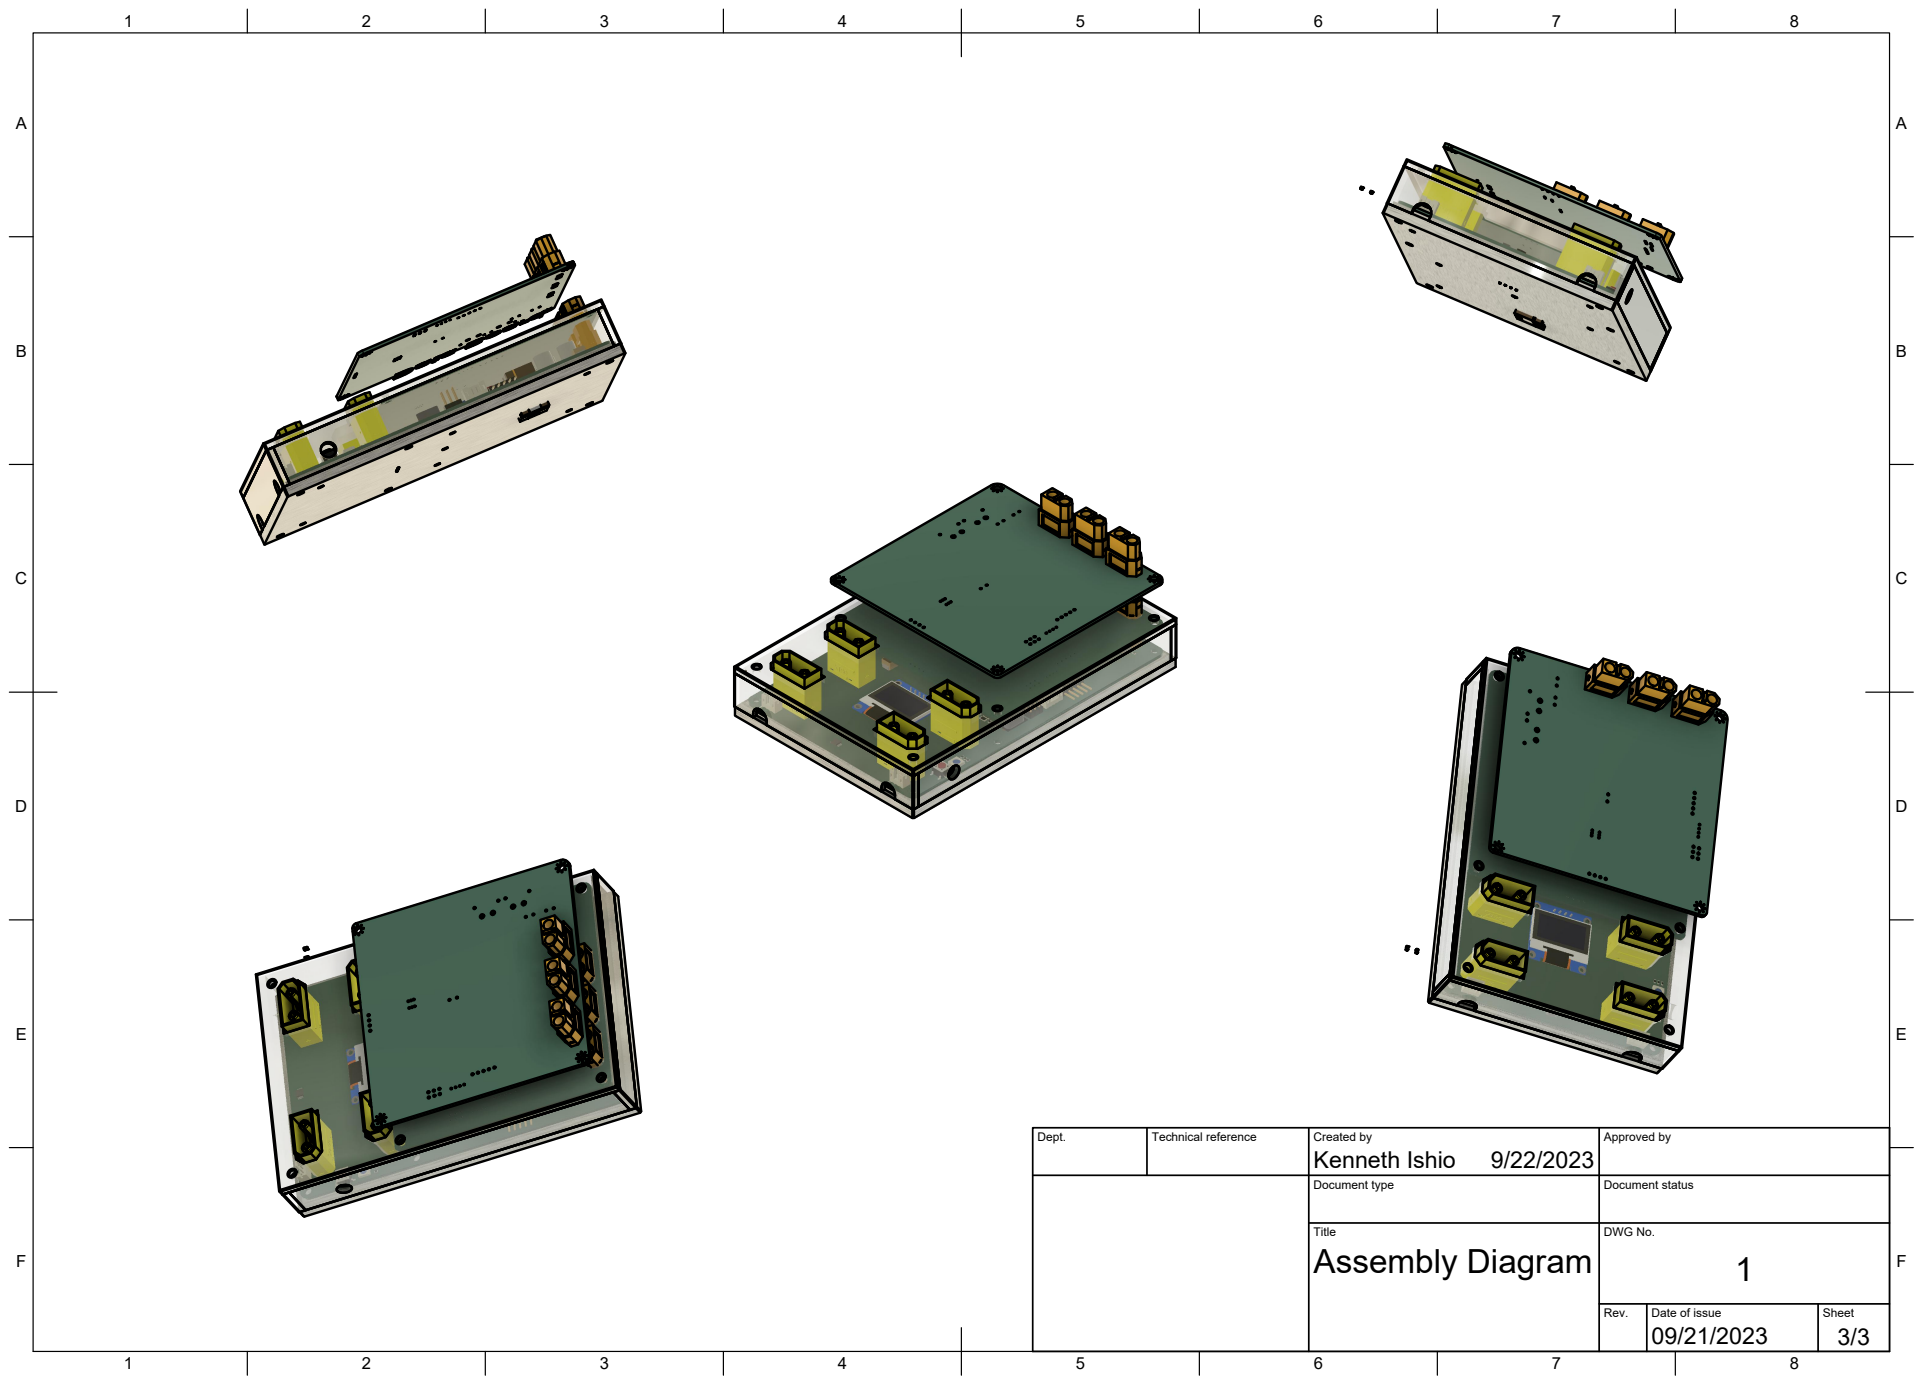
[picture p54: page 3]
Title; DWG No.; Assembly Diagram

Dept. | Technical reference | Created by Kenneth Ishio 9/22/2023 | Approved by

Document type | Document status
