Kenkneeshio/SeniorDesign-Team9/Pictures/Heatsink Drawing v5.pdf

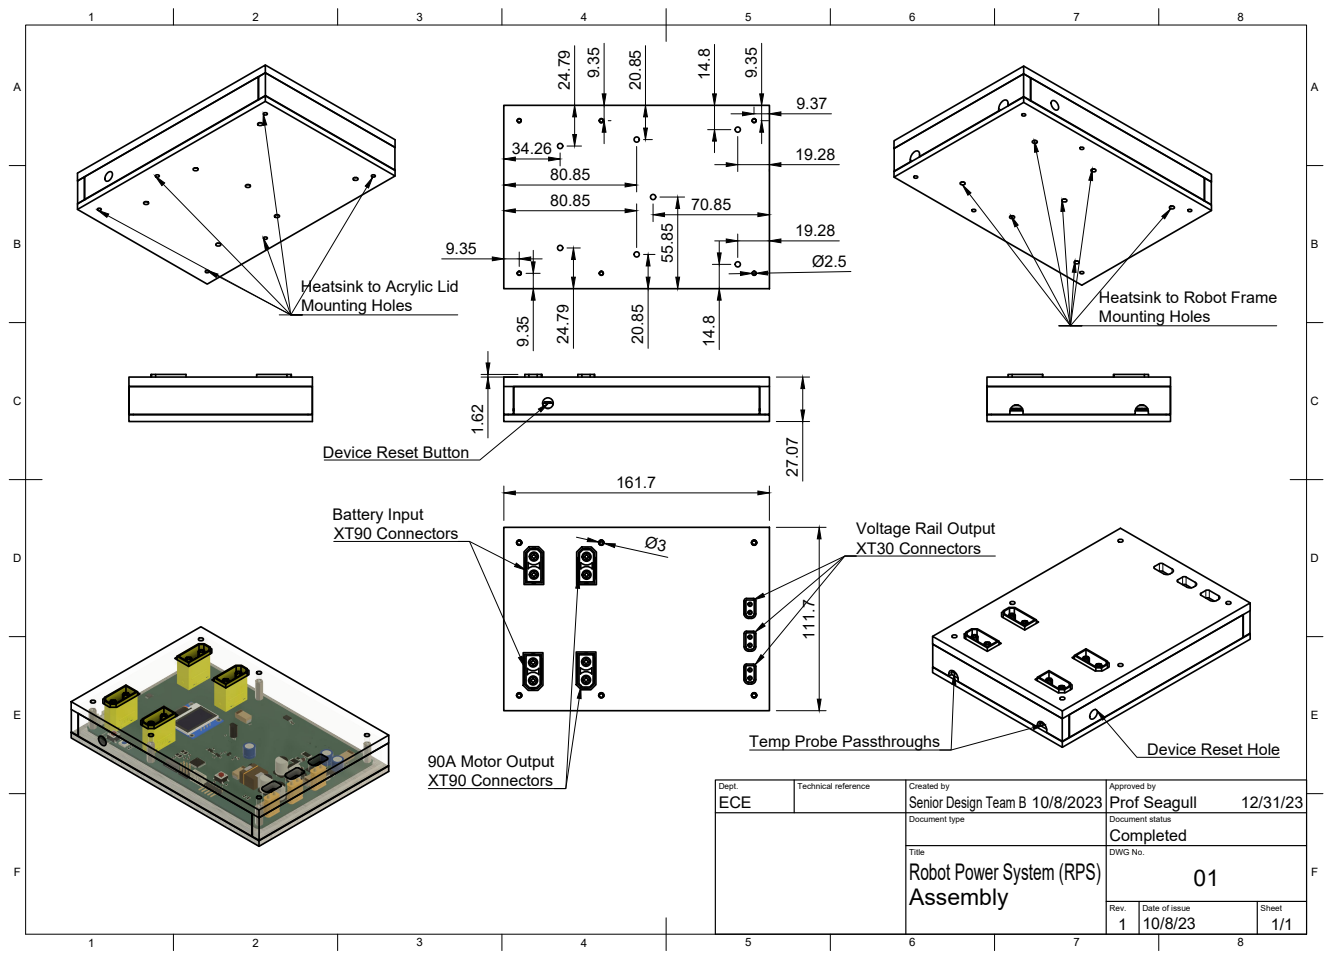
[picture p55: page 1]
Title; DWG No.; Rev.; Date of issue; Sheet; Robot Power System (RPS); Battery Input; XT90 Connectors; Voltage Rail Output; XT30 Connectors; 90A Motor Output XT90 Connectors; Temp Probe Passthroughs; Device Reset Hole

Heatsink to Acrylic Lid
Mounting Holes

Heatsink to Robot Frame

Device Reset Button

Dept. ECE | Technical reference | Created by Senior Design Team B 10/8/2023 | Approved by Prof Seagull 12/31/23

Document type | Document status Completed
