Kenkneeshio/SeniorDesign-Team9/Documentation/prototype activity notes 2.pdf

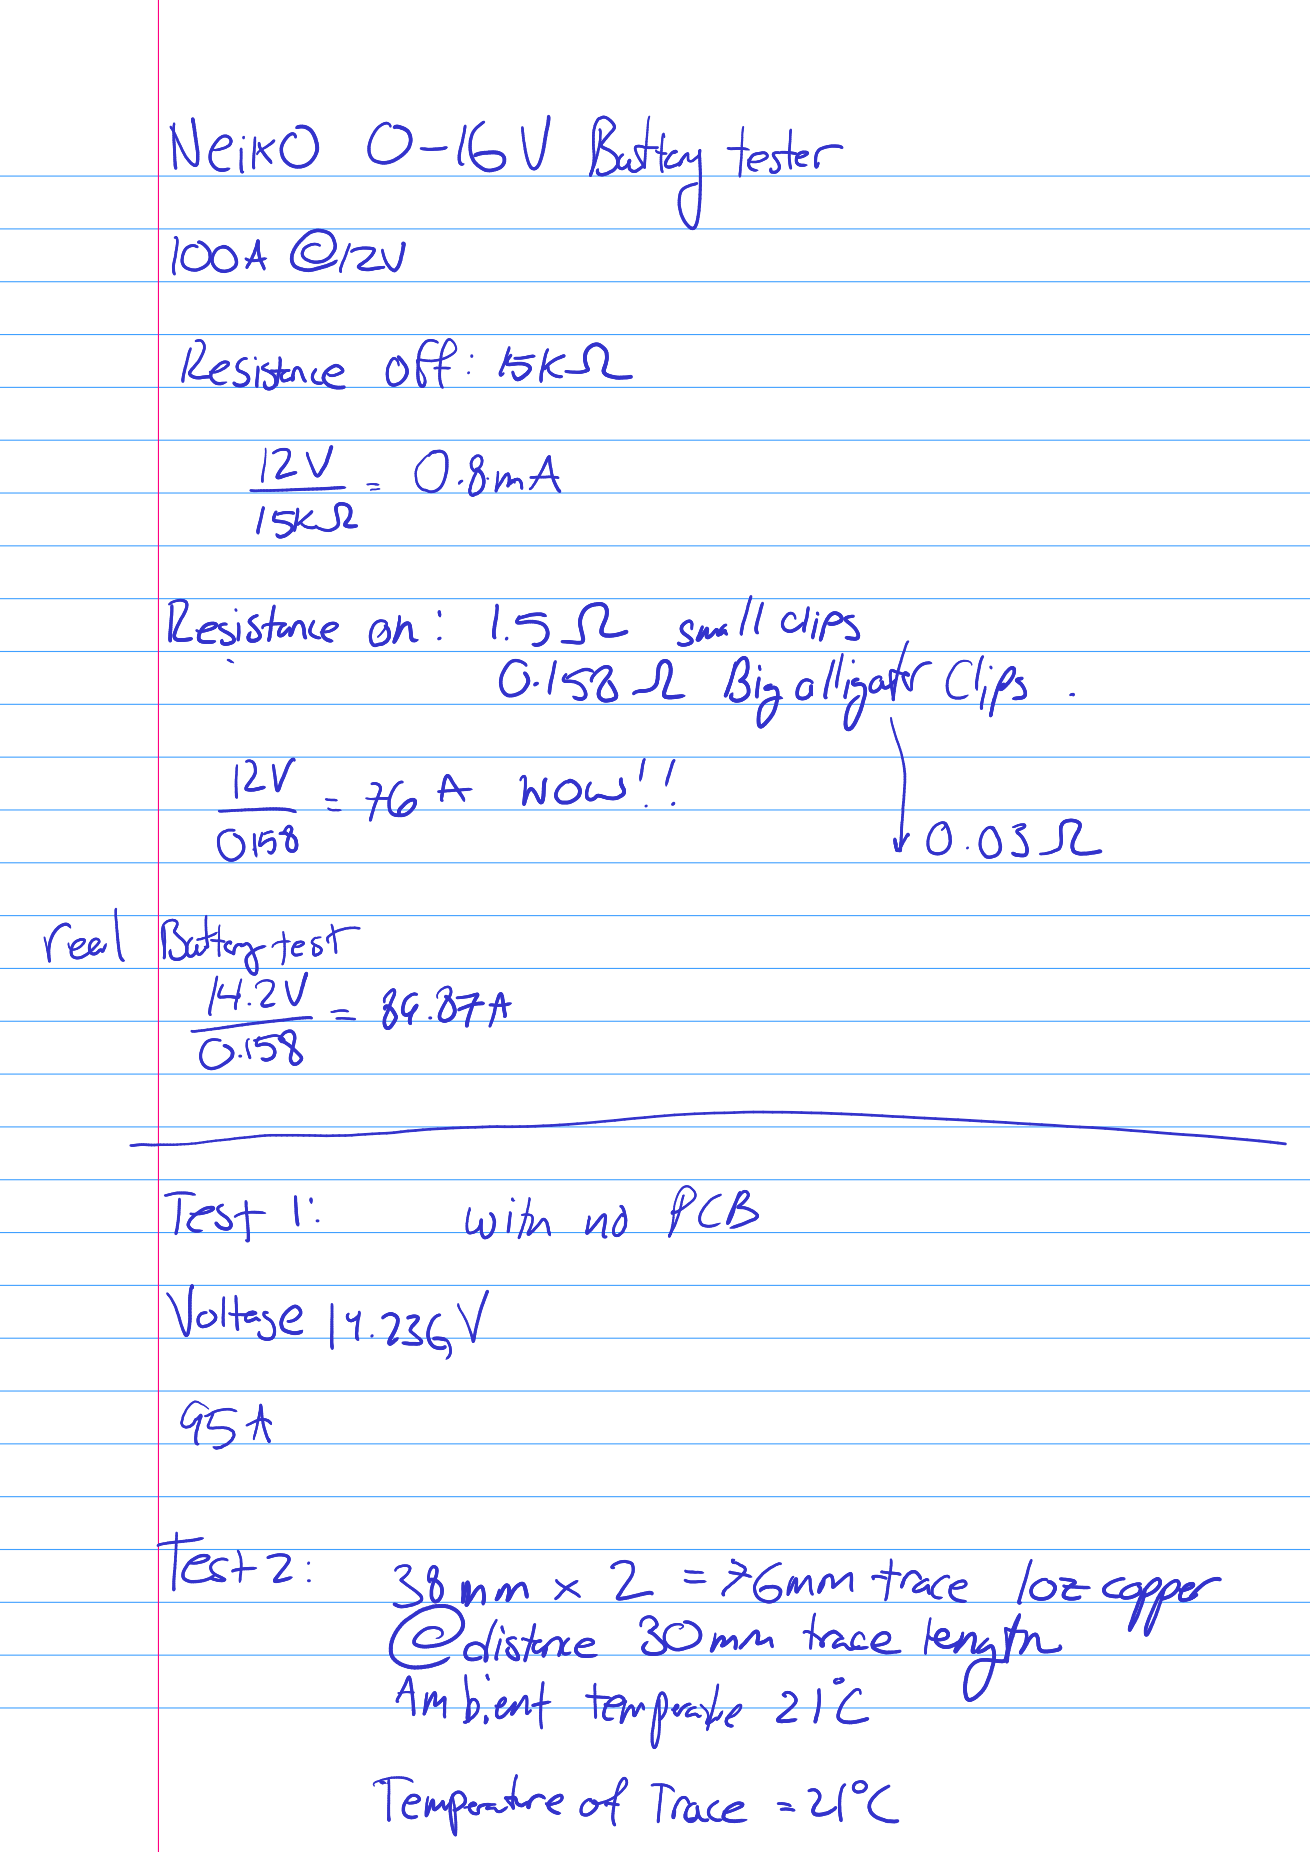
[picture p56: page 1]

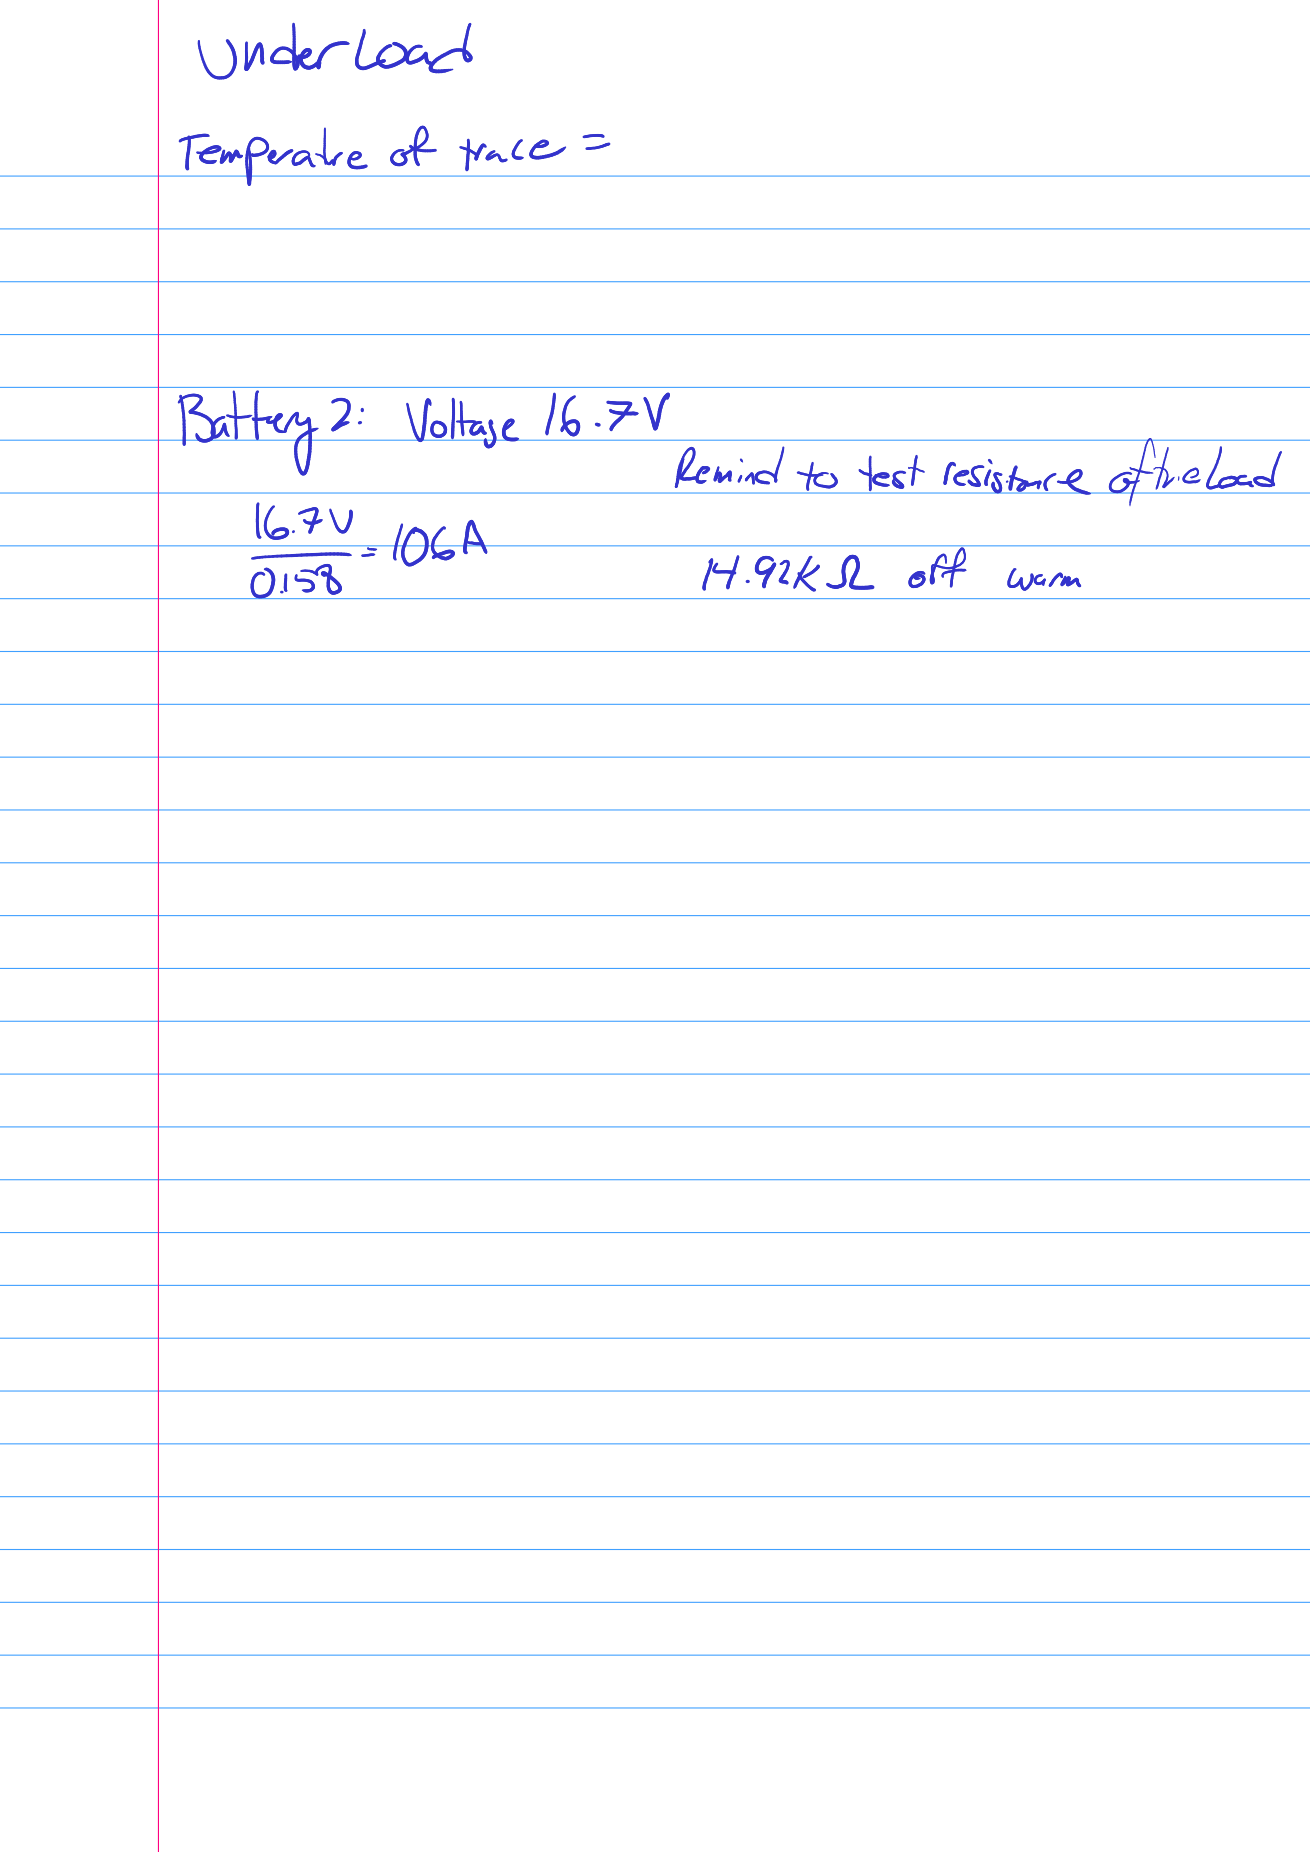
[picture p57: page 2]
