Kenkneeshio/SeniorDesign-Team9/Simulations/INA169 - LTSpice/symbol/INA139 Test Circuit-PSpiceFiles/SCHEMATIC1/DC-TRAN/DC-TRAN.cir

** Profile: "SCHEMATIC1-DC-TRAN"  [ C:\Macromodels\PSpice Library\^INA139\INA139_PSpice\ina139 test circuit-pspicefiles\schematic1\dc-tran.sim ] 

** Creating circuit file "DC-TRAN.cir" 
** WARNING: THIS AUTOMATICALLY GENERATED FILE MAY BE OVERWRITTEN BY SUBSEQUENT SIMULATIONS

*Libraries: 
* Profile Libraries :
* Local Libraries :
.LIB "../../../ina139.lib" 
* From [PSPICE NETLIST] section of C:\Users\a0282827\AppData\Roaming\SPB_Data\cdssetup\OrCAD_PSpice/16.6.0/PSpice.ini file:
.lib "nom.lib" 

*Analysis directives: 
.DC LIN I_I1 0 25 1 
.OPTIONS ADVCONV
.PROBE64 V(alias(*)) I(alias(*)) W(alias(*)) D(alias(*)) NOISE(alias(*)) 
.INC "..\SCHEMATIC1.net" 


.END
