Kenkneeshio/SeniorDesign-Team9/Simulations/Dual LDO with Diodes.asc

D1: schottky
D2: schottky
R1: res
U1: LT1083-5
U2: LT1083-5
V1: voltage
V2: voltage
Named nets: 0
.tran 0 100 0
