Kenkneeshio/SeniorDesign-Team9/Simulations/Overvoltage.asc

D1: zener; BZX84B10VL
R1: res; 1
R2: res; 1Meg
V1: voltage; PWL(0 5 0.0002 5 0.00025 25 0.0003 5)
Named nets: 0, VOUT
.tran 0 0.005 0
