Kenkneeshio/SeniorDesign-Team9/Simulations/LTC4416 - LTSpice Enabled - Disabled/LTC4416_Custom_Ken.asc

Q1: pmos; IRF7210
Q2: pmos; IRF7210
Q3: pmos; IRF7210
Q4: pmos; IRF7210
Q5: pmos; IRF7210
Q6: pmos; IRF7210
R1: res; 4.7k
R2: res; 1Meg
R3: res; 4.7k
R4: res; 1Meg
Rload: res; 1.12; pwr=100
U1: LTC4416
V1: voltage; 12.8
V2: voltage; 14.8
V3: voltage; 5
V4: voltage; 5
Named nets: 0, IN
.tran 3.2 startup
