Kenkneeshio/SeniorDesign-Team9/Simulations/INA169 - LTSpice/BUFFER.asc

I1: load; PWL(0 0 1 1 2 2 3 3 4 4 5 5 6 6 7 7 8 8 9 9 10 10 11 11 12 12 13 13 14 14 15 15)
I2: load; PWL(0 0 1 0 2 1 3 2 4 3 5 4 6 5 7 6 8 7 9 8 10 9)
RL: res; 100k; tol=1
RS: res; .3m
U1: INA139
U3: OP296
V1: voltage; 16.8V
V2: voltage; 5
Named nets: 0, ADC
.tran 0 2 0
