Kenkneeshio/SeniorDesign-Team9/Simulations/INA169 - LTSpice/demo board.asc

I1: load; 15
I2: load; PWL(0 0 1 10 2 20 3 30 4 40 5 50 6 60 7 70 8 80 9 90 10 100 11 110 12 120 13 130 14 140 15 150 16 160 17 170 18 180 19 190 20 200)
RL: res; 10.018k; tol=1
RS: res; 0.00333729873
U1: INA139
V1: voltage; 16.8V
V2: voltage; 5
Named nets: 0
.tran 0 30 0
