Kenkneeshio/SeniorDesign-Team9/Simulations/LTC4416 - LTSpice/LTC4416_Figure_5.asc

Q1: pmos; IRF7210
Q2: pmos; IRF7210
Q3: pmos; IRF7210
Q4: pmos; IRF7210
Q5: pmos; IRF7210
Q6: pmos; IRF7210
Rload: res; .1655; pwr=100
U1: LTC4416
V1: voltage; 16.8
V2: voltage; 0
V3: voltage; 0
V4: voltage; 5
Named nets: 0, IN
.tran 3.2 startup
