Kenkneeshio/SeniorDesign-Team9/Simulations/LTC4416 - LTSpice/VoltageSpikes.asc

Q1: pmos; IRF7210
Q4: pmos; IRF7210
Rload: res; 1.12; pwr=100
U1: LTC4416
V1: voltage; PWL(0 0 1 12 2 0 3 12)
V2: voltage; 10
V3: voltage; 0
V4: voltage; 5
Named nets: 0, IN
.tran 3.2 startup
