Kenkneeshio/SeniorDesign-Team9/Simulations/LTC4416 - LTSpice/LTC4416_Custom_Ken.asc

M1: pmos; Si7137DP
M2: pmos; Si7137DP
M3: pmos; Si7137DP
M4: pmos; Si7137DP
M5: pmos; Si7137DP
M6: pmos; Si7137DP
Rload: res; .1865; pwr=100
U1: LTC4416
V1: voltage; 16.8
V2: voltage; 16.8
Named nets: 0, IN
.tran 3.2 startup
