Kenkneeshio/SeniorDesign-Team9/Simulations/LTC3780 - LTSpice - 19V 10A - Ken/LTC3780.asc

C1: polcap; 270; Rser=16m
Casw1: cap; .22µ
Cbsw2: cap; .22µ
Cinc: cap; 10µ; Rser=4m
ClowESR: cap; 4.7µ
Coutb: polcap; 330µ; Rser=0.05
Coutc: cap; 47µ; Rser=0.01
Coutfilter: cap; 1000µ
Cs: cap; 100p
Css: cap; .001µ
Cstbymd: cap; .001µ
Cth: cap; 10000p
Cthp: cap; 47p
D1: schottky; MBRS340
D2: schottky; MBRS340
D3: zener; 1N750
D4: schottky; MBRS340
D5: schottky; MBRS340
L1: ind; 6.8µ; Rser=0.088 Rpar=2K
Q1: nmos; SUD40N04-10A
Q2: nmos; SUD40N04-10A
Q3: nmos; SUD40N04-10A
Q4: nmos; SUD40N04-10A
R4: res; 100
R5: res; 100
Rb: res; 4.3k
Rinrun: res; 51K
Rload: res; 1.9
Rpgood: res; 100K
Rs: res; .006
Rsen: res; .006
Rt: res; 100k
Rth: res; 124k
U1: LTC3780
Vin: voltage; 16.8
Named nets: 0, Vout, IN, Vsense
.tran 10m startup
Note:
  If the simulation model is not found please update with the "Sync Release" command from the "Tools" menu.
  It remains the customer's responsibility to verify proper and reliable operation in the actual application.
  Component substitution and printed circuit board layout may significantly affect circuit performance or reliability.
  Contact your local sales representative for assistance. This circuit is distributed to customers only for use with LTC parts.
  Copyright © 2006 Linear Technology Inc. All rights reserved.
LTC3780 Design - High Efficiency Buck-Boost DC/DC Converter
Input: 14V to 16.8V    Output: 19V @ 10A
