Kenkneeshio/SeniorDesign-Team9/Simulations/LTC3780 - LTSpice - 12V 5A/LTC3780.asc

C1: polcap; 390µ; Rser=0.05
C2: cap; 27µ; Rser=0.1
C3: cap; 4.7µ
C4: cap; .001µ
C5: cap; .01µ
C6: cap; .22µ
C7: cap; .22µ
C8: cap; .001µ
C9: cap; 22µ; Rser=0.01
C10: cap; 3.3µ; Rser=0.01
C11: cap; 100p
C12: cap; 100p
C13: cap; 300µ
D1: schottky; MBRS340
D2: schottky; MBRS340
D3: zener; 1N750
D4: schottky; 1N5819
D5: schottky; 1N5819
L1: ind; 4.7µ; Rser=0.005 Rpar=2K
Q1: nmos; SUD40N04-10A
Q2: nmos; SUD40N04-10A
Q3: nmos; SUD40N04-10A
Q4: nmos; SUD40N04-10A
R1: res; .018
R2: res; .018
R3: res; 100K
R4: res; 100
R5: res; 100
R6: res; 51K
R7: res; 113K
R8: res; 8.06K
R9: res; 100K
Rload: res; 2.5
U1: LTC3780
V1: voltage; 6
Named nets: 0, OUT, IN
.tran 5m startup
Note:
  If the simulation model is not found please update with the "Sync Release" command from the "Tools" menu.
  It remains the customer's responsibility to verify proper and reliable operation in the actual application.
  Component substitution and printed circuit board layout may significantly affect circuit performance or reliability.
  Contact your local sales representative for assistance. This circuit is distributed to customers only for use with LTC parts.
  Copyright © 2006 Linear Technology Inc. All rights reserved.
LTC3780 Design - High Efficiency Buck-Boost DC/DC Converter
Input: 6 to 30V    Output: 12V @ 5A
