Kenkneeshio/SeniorDesign-Team9/Simulations/LTC3780 Reference Simulations and Resources/LTC3780_LTC4444.asc

C1: cap; 4.7µ
C2: cap; 22µ; Rser=0.003
C3: cap; .1µ
C4: cap; .1µ
C7: cap; .01µ
C8: cap; 0.22µ
C9: cap; 1µ
C10: cap; 100p
C11: cap; 68p
C12: cap; 100p
C13: polcap; 330µ; Rser=0.005
C14: cap; 2.2µ
C15: polcap; 100µ
C16: cap; 100p
C17: cap; .0047µ
D1: schottky; BAT54
D2: schottky; MBRS1100
D3: schottky; MBRS340
D4: diode; MMSD4148
L1: ind; 6.8µ; Rser=0.005
Q1: nmos; Si4486EY
Q2: nmos; Si4408DY
Q3: nmos; Si4408DY
Q4: nmos; Si4486EY
R1: res; 8.06K
R2: res; 113K
R3: res; 15m
R5: res; 10K
R6: res; 100
R7: res; 100
R8: res; 51K
R9: res; 10K
R10: res; 4
R11: res; 220K
U1: LTC3780
U2: LTC4444
V1: voltage; 24
V2: voltage; 8
Named nets: 0, IN, OUT
.tran 750u startup
Note:
  If the simulation model is not found please update with the "Sync Release" command from the "Tools" menu.
  It remains the customer's responsibility to verify proper and reliable operation in the actual application.
  Component substitution and printed circuit board layout may significantly affect circuit performance or reliability
  Contact your local sales representative for assistance. This circuit is distributed to customers only for use with LTC parts
  Copyright © 2008 Linear Technology Inc. All rights reserved.
LTC3780/LTC4444 - High Efficiency Synchronous Buck-Boost DC/DC Converter
Input: 8V-48V    Output: 12V @ 3A
