Kenkneeshio/SeniorDesign-Team9/(list of files, drawings)

Other design files:
Simulations/INA169 - LTSpice/symbol/ina139 test circuit.dsn
Simulations/INA169 - LTSpice/symbol/ina139 test circuit.opj
Simulations/LTC3780 Reference Simulations and Resources/1155A reference PCB/DC1155a.dsn
Simulations/LTC3780 Reference Simulations and Resources/1155A reference PCB/DC1155a.pcb
Simulations/OPA340/OPAx340.OLB
Simulations/OPA340/OPAx340_Test_Circuit.DSN
Simulations/OPA340/OPAx340_Test_Circuit.OPJ
