Kenkneeshio/SeniorDesign-Team9/KiCad/RPS01-Revision 2/rps01.kicad_pcb

## KiCad design KiCad/RPS01-Revision 2/rps01.kicad_pcb (2023-12-12)

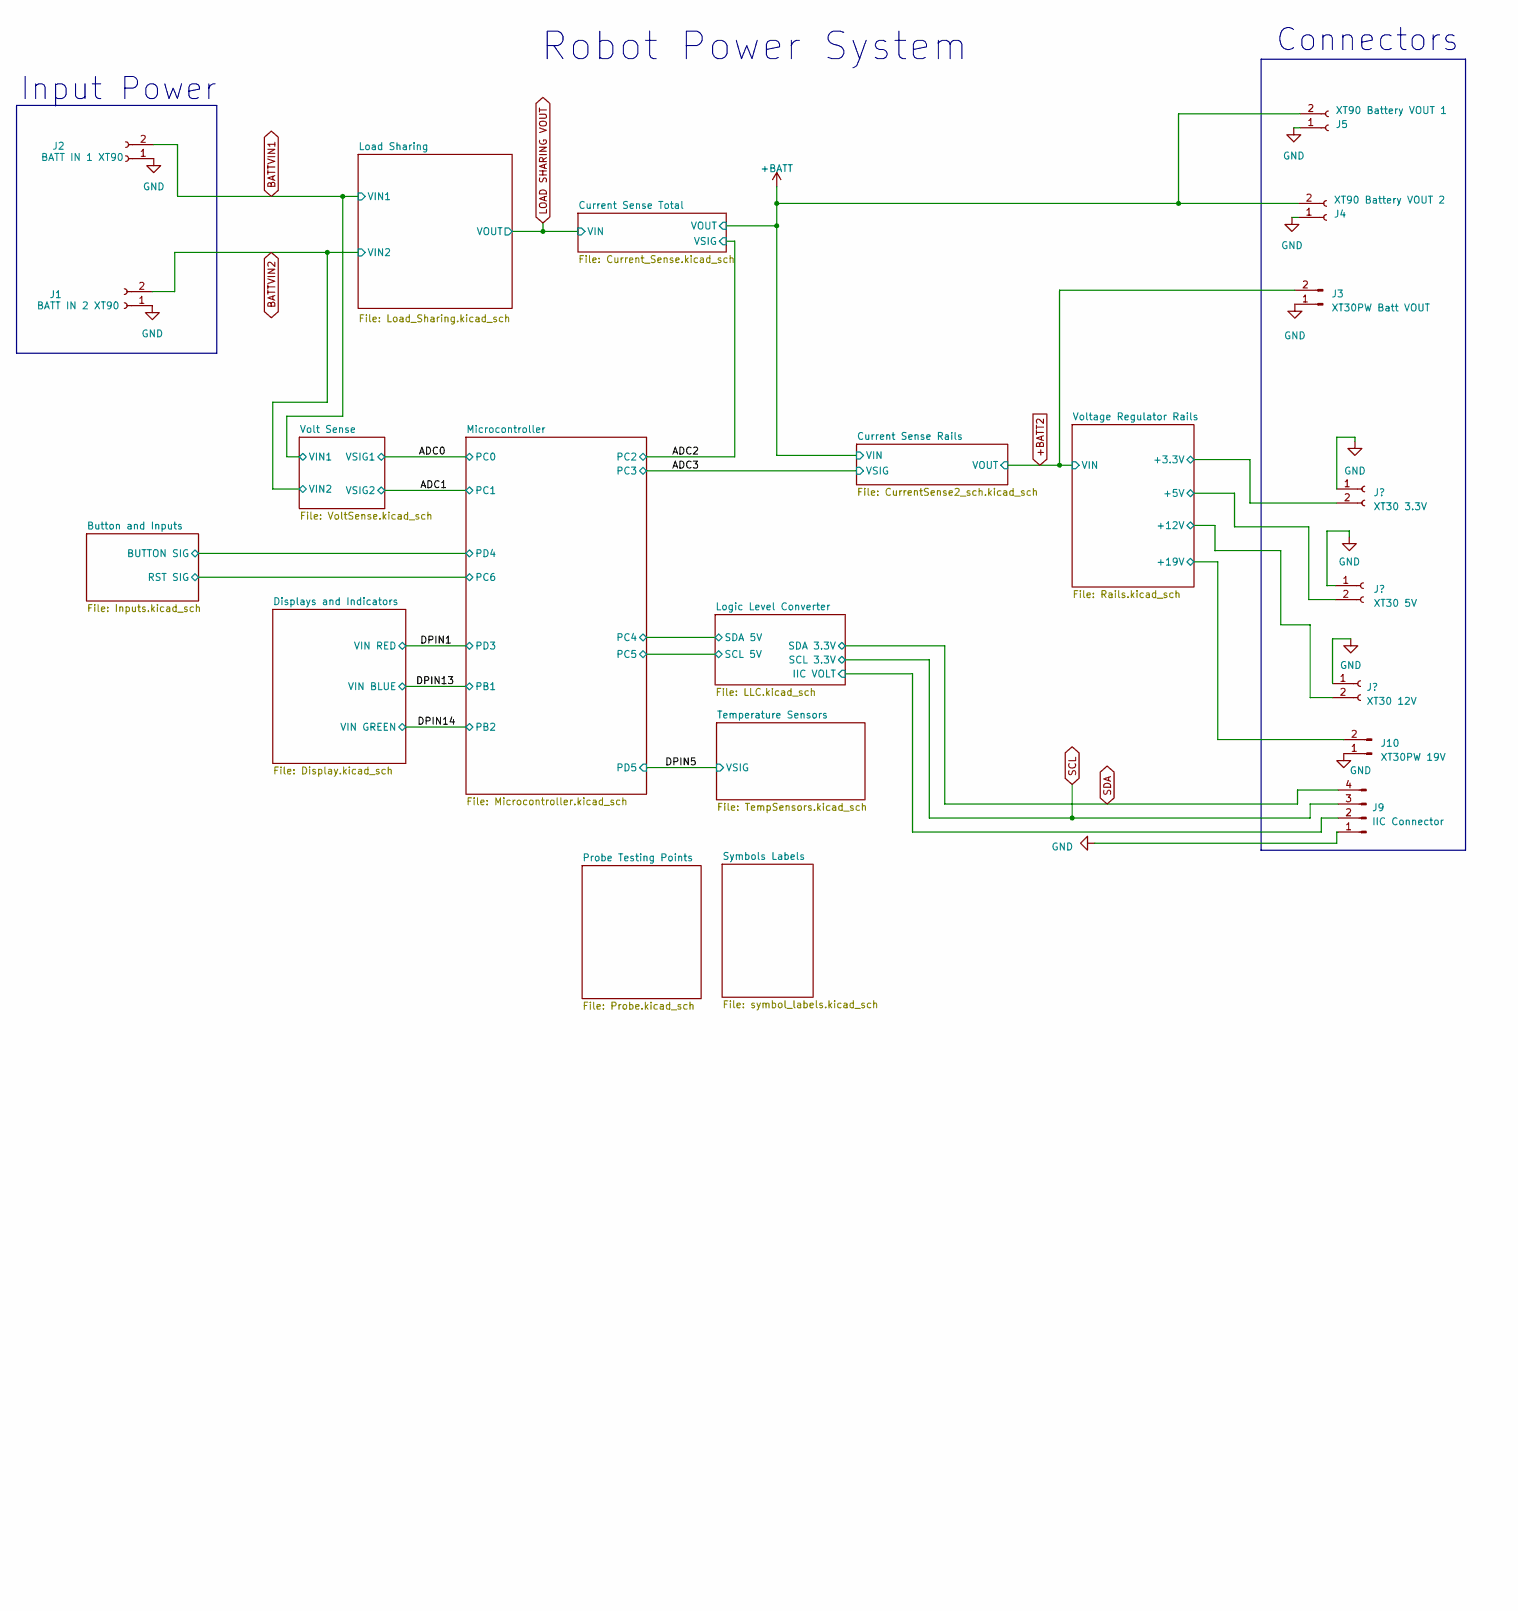
[picture p61: schematic rps01.kicad_sch, Spring Team 9 Senior Design, part in row 1, column 1]

Parts:
J1: BATT IN 2 XT90; AMASS_XT90-M_1x02_P11.00mm_Vertical
J2: BATT IN 1 XT90; AMASS_XT90-M_1x02_P11.00mm_Vertical
J3: XT30PW Batt VOUT; AMASS_XT30PW-F_1x02_P2.50mm_Horizontal
J4: XT90 Battery VOUT 2; AMASS_XT90-F_1x02_P11.00mm_Vertical
J5: XT90 Battery VOUT 1; AMASS_XT90-F_1x02_P11.00mm_Vertical
J6: XT30 12V; AMASS_XT30U-F_1x02_P5.0mm_Vertical
J7: XT30 5V; AMASS_XT30U-F_1x02_P5.0mm_Vertical
J8: XT30 3.3V; AMASS_XT30U-F_1x02_P5.0mm_Vertical
J9: IIC Connector; JST_PH_B4B-PH-K_1x04_P2.00mm_Vertical
J10: XT30PW 19V; AMASS_XT30PW-F_1x02_P2.50mm_Horizontal

Connections:
+3.3V: J8.2; also elsewhere on the board
+5V: J7.2; also elsewhere on the board
+12V: J6.2; also elsewhere on the board
+19V: J10.2; also elsewhere on the board
+BATT: J4.2, J5.2; also elsewhere on the board
+BATT2: J3.2; also elsewhere on the board
/Logic Level Converter/IIC VOLT: J9.2; also elsewhere on the board
SCL: J9.3; also elsewhere on the board
SDA: J9.4; also elsewhere on the board

Notes on the sheet:
Connectors
Robot Power System
Input Power

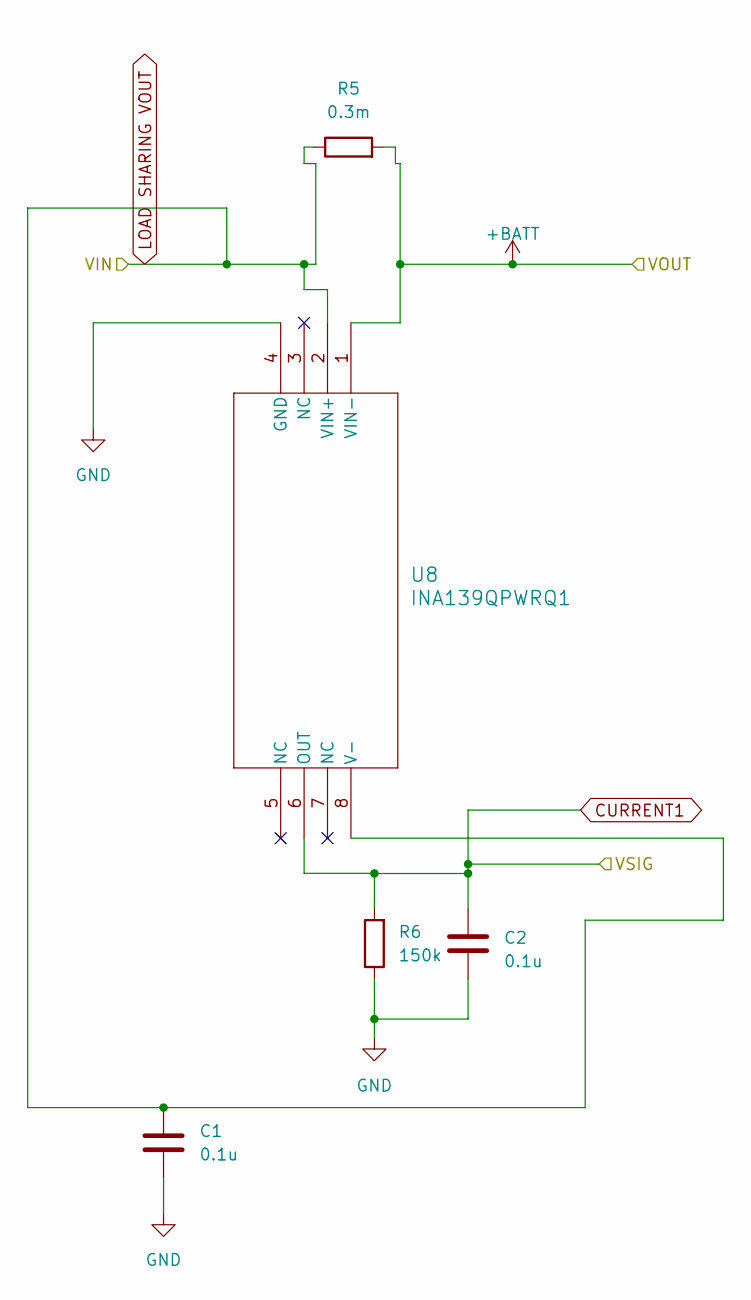
[picture p62: schematic Current_Sense.kicad_sch]

Parts:
C1, C2: 0.1u; C_0603_1608Metric
R5: 0.3m; CSS2H-5930R
R6: 150k; R_0603_1608Metric
U8: INA139QPWRQ1; INA139_PW8

Connections:
+BATT: R5.2, U8.1 (VIN-); also elsewhere on the board
CURRENT1: C2.1, R6.2, U8.6 (OUT); also elsewhere on the board
LOAD SHARING VOUT: C1.1, R5.1, U8.2 (VIN+), U8.8 (V-); also elsewhere on the board

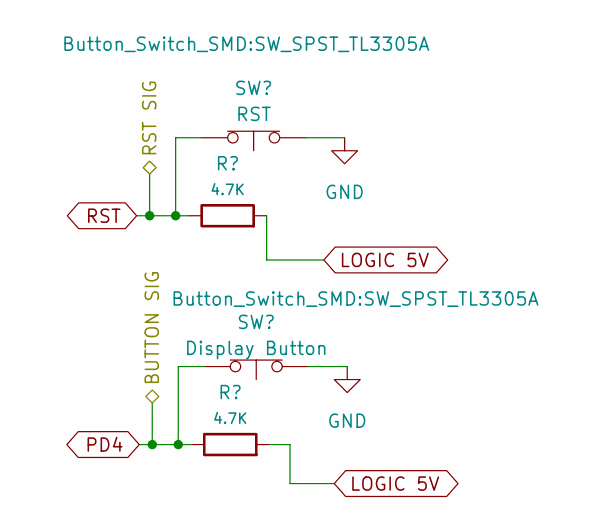
[picture p63: schematic Inputs.kicad_sch]

Parts:
R54, R55: 4.7K; R_0603_1608Metric
SW1: RST; SW_SPST_TL3305A
SW2: Display Button; SW_SPST_TL3305A

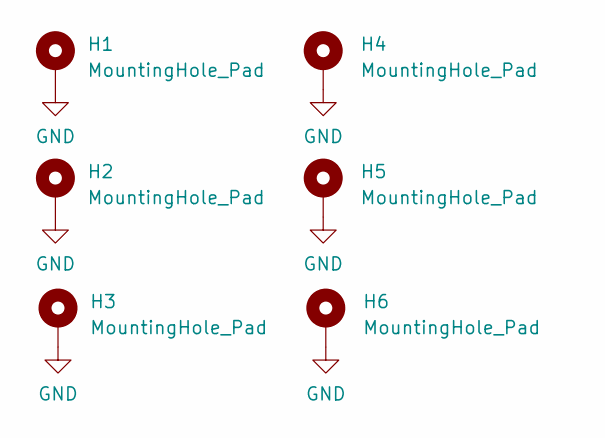
[picture p64: schematic Probe.kicad_sch]

Parts:
H1, H2, H3, H4, H5, H6: MountingHole_Pad; MountingHole_3.2mm_M3_Pad_Via

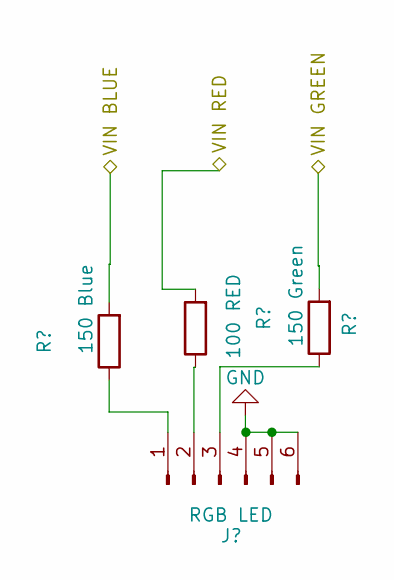
[picture p65: schematic Display.kicad_sch]

Parts:
J18: RGB LED; LED_RGB_5050-6
RBLUE1: 150 Blue; R_0603_1608Metric
RGREEN1: 150 Green; R_0603_1608Metric
RRED1: 100 RED; R_0603_1608Metric

Connections:
/DPIN1: RRED1.2; also elsewhere on the board
/DPIN14: RGREEN1.2; also elsewhere on the board
unnamed: J18.1, RBLUE1.1
unnamed: J18.2, RRED1.1
unnamed: J18.3, RGREEN1.1

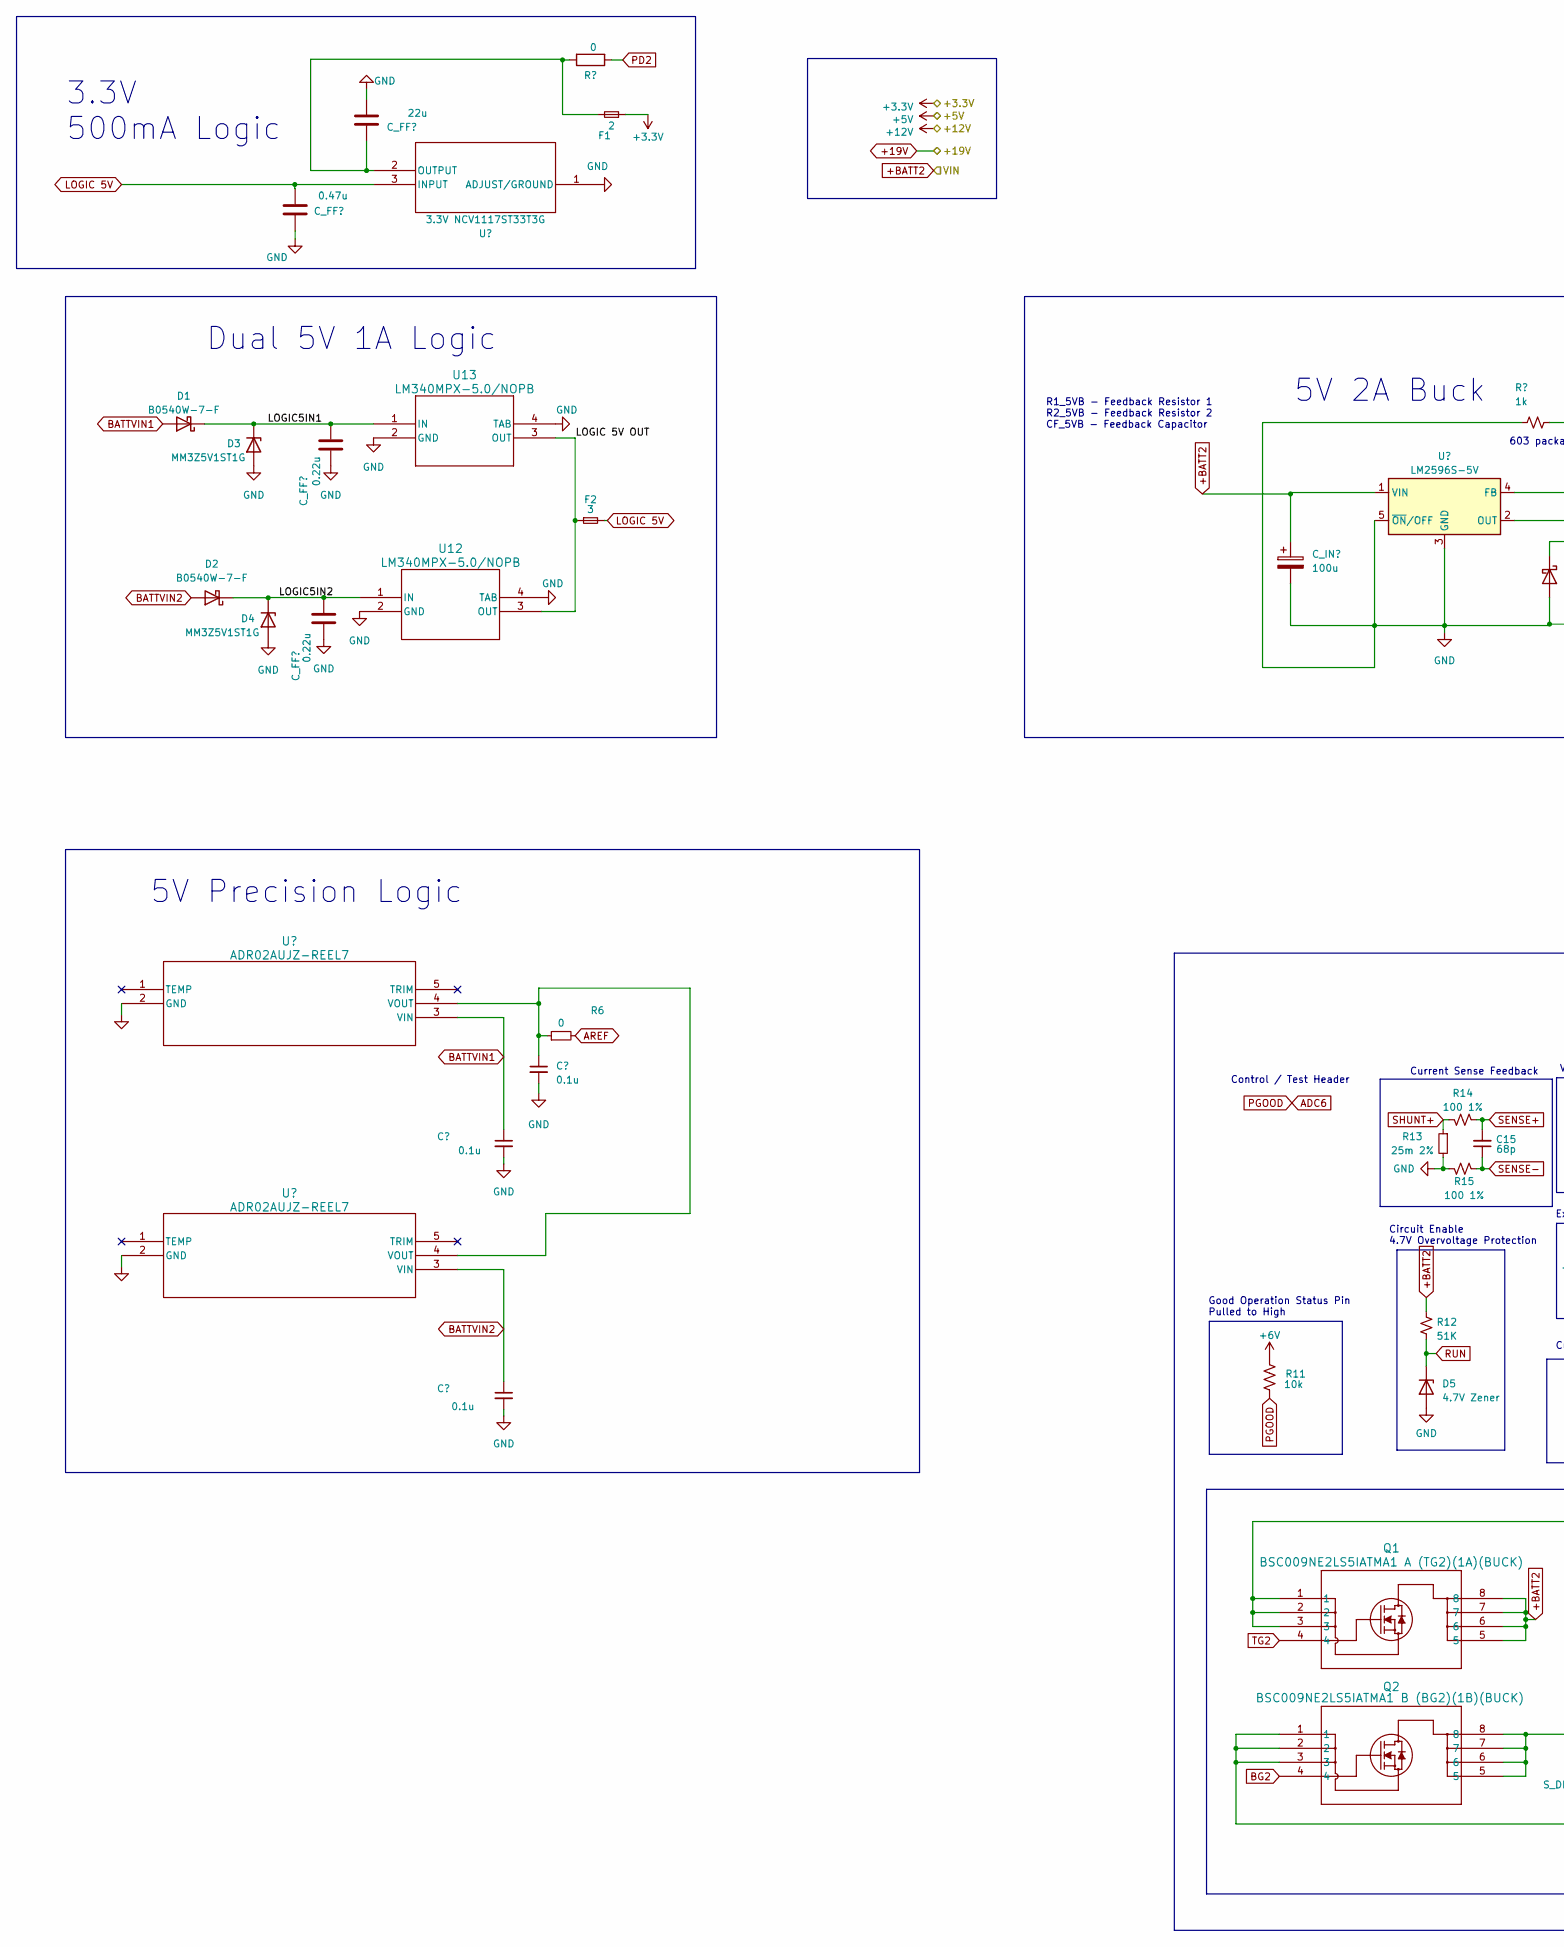
[picture p66: schematic Rails.kicad_sch, part in row 1, column 1]

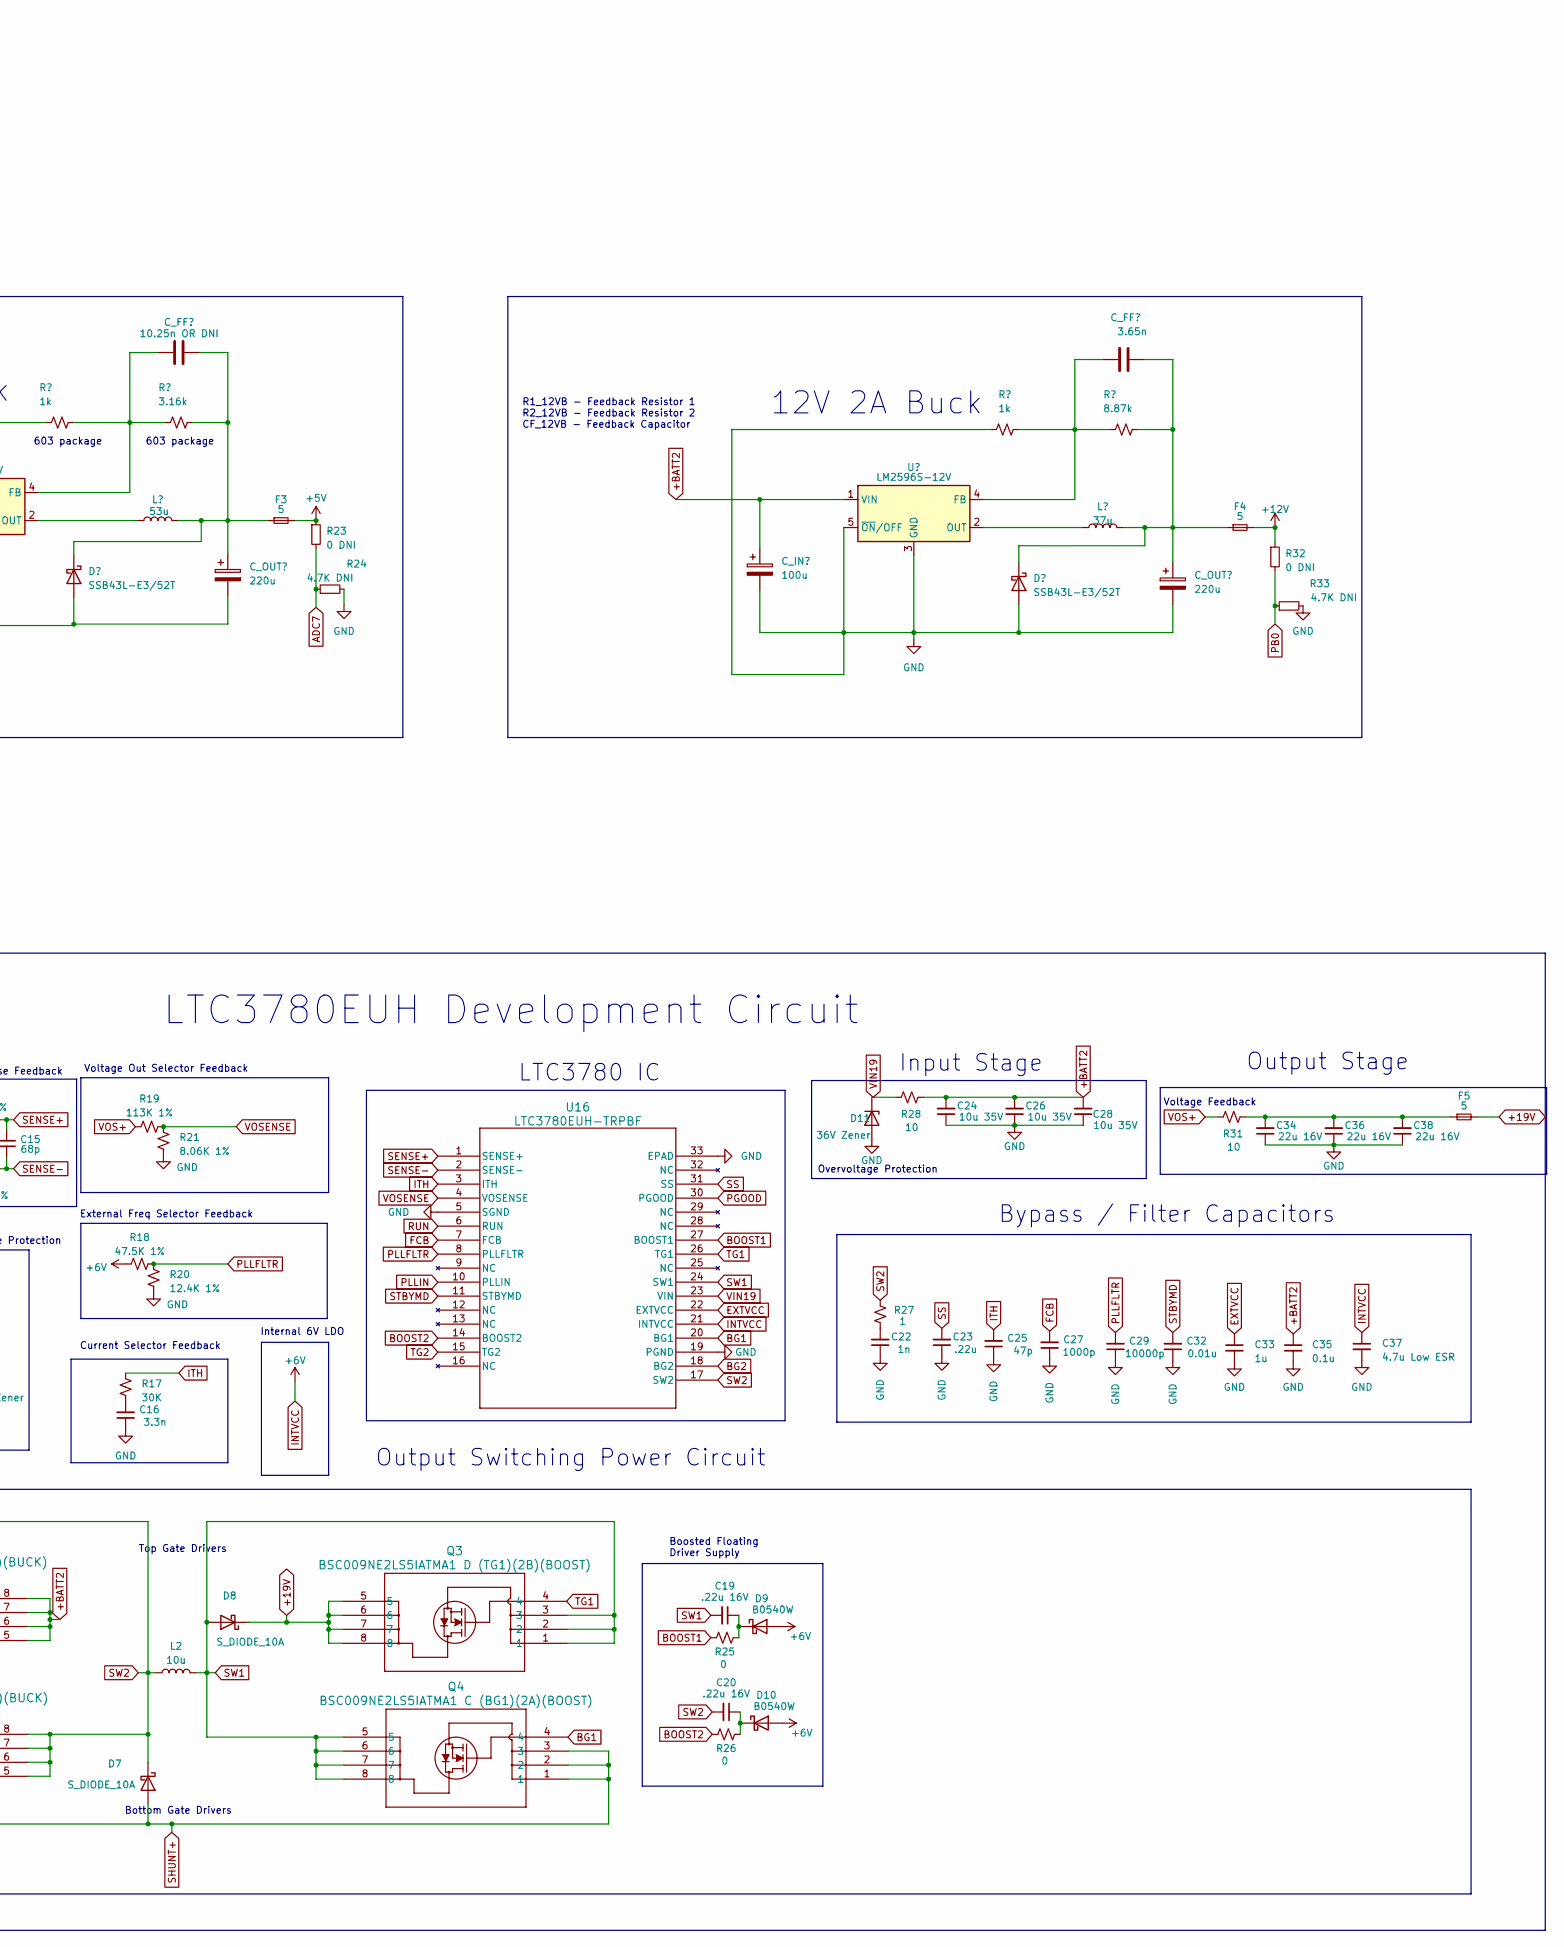
[picture p67: schematic Rails.kicad_sch, part in row 1, column 2]

Parts:
C6, C7: 0.1u; C_0603_1608Metric
C8, C9: 0.22u; C_0603_1608Metric
C10: 22u; C_0603_1608Metric
C14, C21: 100u; CP_Elec_8x10
C15: 68p; C_1206_3216Metric_Pad1.33x1.80mm_HandSolder
C16: 3.3n; C_1206_3216Metric_Pad1.33x1.80mm_HandSolder
C17: 10.25n OR DNI; C_0603_1608Metric
C18, C31: 220u; CP_Elec_8x10
C19, C20: .22u 16V; C_1206_3216Metric_Pad1.33x1.80mm_HandSolder
C22: 1n; C_1206_3216Metric_Pad1.33x1.80mm_HandSolder
C23: .22u; C_1206_3216Metric_Pad1.33x1.80mm_HandSolder
C24, C26, C28: 10u 35V; C_1206_3216Metric_Pad1.33x1.80mm_HandSolder
C25: 47p; C_1206_3216Metric_Pad1.33x1.80mm_HandSolder
C27: 1000p; C_1206_3216Metric_Pad1.33x1.80mm_HandSolder
C29: 10000p; C_1206_3216Metric_Pad1.33x1.80mm_HandSolder
C30: 3.65n; C_0603_1608Metric
C32: 0.01u; C_1206_3216Metric_Pad1.33x1.80mm_HandSolder
C33: 1u; C_1206_3216Metric_Pad1.33x1.80mm_HandSolder
C34, C36, C38: 22u 16V; C_1206_3216Metric_Pad1.33x1.80mm_HandSolder
C35: 0.1u; C_1206_3216Metric_Pad1.33x1.80mm_HandSolder
C37: 4.7u Low ESR; LOWESRCAPMP7.6X4.3_3.1N_KEM
D1, D2: B0540W-7-F; D_SOD-123
D3, D4: MM3Z5V1ST1G; D_SOD-323
D5: 4.7V Zener; D_SOD-123
D6, D12: SSB43L-E3/52T; SSB43L-E352T_DIODE_DO214AA_MBRS
D7, D8: S_DIODE_10A; D_PowerDI-5
D9, D10: B0540W; CR_SMA_320-340AE_DIO
D11: 36V Zener; D_SOD-123
F1: 2; 0154Series_LTF
F2: 3; 0154Series_LTF
F3, F4, F5: 5; 0154Series_LTF
L1: 53u; PE-54039SNL_IND_HCI-68_PUL
L2: 10u; IND_410680_WRE
L3: 37u; PE-53932SNLT_IND_HCI-44_PUL
Q1: BSC009NE2LS5IATMA1 A (TG2)(1A)(BUCK); PG-TDSON-8_INF
Q2: BSC009NE2LS5IATMA1 B (BG2)(1B)(BUCK); PG-TDSON-8_INF
Q3: BSC009NE2LS5IATMA1 D (TG1)(2B)(BOOST); PG-TDSON-8_INF
Q4: BSC009NE2LS5IATMA1 C (BG1)(2A)(BOOST); PG-TDSON-8_INF
R6: 0; R_0603_1608Metric
R11: 10k; R_1206_3216Metric_Pad1.30x1.75mm_HandSolder
R12: 51K; R_1206_3216Metric_Pad1.30x1.75mm_HandSolder
R13: 25m 2%; R_2512_6332Metric_Pad1.40x3.35mm_HandSolder
R14, R15: 100 1%; R_1206_3216Metric_Pad1.30x1.75mm_HandSolder
R16, R29: 1k; R_0603_1608Metric
R17: 30K; R_1206_3216Metric_Pad1.30x1.75mm_HandSolder
R18: 47.5K 1%; R_1206_3216Metric_Pad1.30x1.75mm_HandSolder
R19: 113K 1%; R_1206_3216Metric_Pad1.30x1.75mm_HandSolder
R20: 12.4K 1%; R_1206_3216Metric_Pad1.30x1.75mm_HandSolder
R21: 8.06K 1%; R_1206_3216Metric_Pad1.30x1.75mm_HandSolder
R22: 3.16k; R_0603_1608Metric
R23, R32: 0 DNI; R_0603_1608Metric
R24, R33: 4.7K DNI; R_0603_1608Metric
R25, R26: 0; R_1206_3216Metric_Pad1.30x1.75mm_HandSolder
R27: 1; R_1206_3216Metric_Pad1.30x1.75mm_HandSolder
R28, R31: 10; R_1206_3216Metric_Pad1.30x1.75mm_HandSolder
R30: 8.87k; R_0603_1608Metric
RBLUE1: 0; R_0603_1608Metric
U9: ADR02AUJZ-REEL7; ADR02AUJZ_REEL7_UJ_5_ADI
U12, U13: LM340MPX-5.0/NOPB; SOT-223-3_TabPin2
U14: 3.3V NCV1117ST33T3G; SOT-223-3_TabPin2
U15: LM2596S-5V; TO-263-5_TabPin3
U16: LTC3780EUH-TRPBF; QFN-32_UH_LIT
U17: LM2596S-12V; TO-263-5_TabPin3

Connections:
+3.3V: F1.1; also elsewhere on the board
+5V: F3.2, R23.1; also elsewhere on the board
+12V: F4.2, R32.1; also elsewhere on the board
+19V: D8.1 (K), F5.2, Q3.5, Q3.6, Q3.7, Q3.8; also elsewhere on the board
+BATT2: C14.1, C21.1, C24.2, C26.2, C28.2, C35.1, Q1.5, Q1.6, Q1.7, Q1.8, R12.1, R28.1, U15.1 (VIN), U17.1 (VIN); also elsewhere on the board
/DPIN1: U9.1 (PD3); also elsewhere on the board
/Voltage Regulator Rails/LOGIC5IN1: C9.2, D1.1 (K), D3.1 (K), U13.1 (IN)
/Voltage Regulator Rails/LOGIC5IN2: C8.2, D2.1 (K), D4.1 (K), U12.1 (IN)
/Voltage Regulator Rails/LOGIC 5V OUT: F2.1, U12.3 (OUT), U13.3 (OUT)
ADC6: R11.2, U16.30 (PGOOD); also elsewhere on the board
ADC7: R23.2, R24.1; also elsewhere on the board
BG1: Q4.4, U16.20 (BG1)
BG2: Q2.4, U16.18 (BG2)
BOOST1: R25.1, U16.27 (BOOST1)
BOOST2: R26.1, U16.14 (BOOST2)
CURRENT1: R6.2; also elsewhere on the board
EXTVCC: C33.1, U16.22 (EXTVCC)
FCB: C27.2, U16.7 (FCB)
INTVCC: C37.1, D9.2 (A), D10.2 (A), R11.1, R18.1, U16.21 (INTVCC)
ITH: C25.2, R17.1, U16.3 (ITH)
unnamed: C16.2, R17.2
unnamed: C22.2, R27.1
unnamed: C34.2, C36.2, C38.2, F5.1, R31.1
unnamed: C17.2, C18.1, D6.1 (K), F3.1, L1.2, R22.2
unnamed: C19.1, D9.1 (K), R25.2
unnamed: C20.1, D10.1 (K), R26.2
unnamed: C30.2, C31.1, D12.1 (K), F4.1, L3.2, R30.2
unnamed 47: RBLUE1.1; also elsewhere on the board
unnamed: C17.1, R16.2, R22.1, U15.4 (FB)
unnamed: L1.1, U15.2 (OUT)
unnamed: C30.1, R29.2, R30.1, U17.4 (FB)
unnamed: L3.1, U17.2 (OUT)
PB0: R32.2, R33.1; also elsewhere on the board
PLLFLTR: C29.2, R18.2, R20.1, U16.8 (PLLFLTR)
PLLIN: U16.10 (PLLIN)
RUN: D5.1 (K), R12.2, U16.6 (RUN)
SENSE+: C15.2, R14.1, U16.1 (SENSE+)
SENSE-: C15.1, R15.1, U16.2 (SENSE-)
SHUNT+: D7.2 (A), Q2.1, Q2.2, Q2.3, Q4.1, Q4.2, Q4.3, R13.1, R14.2
SS: C23.2, U16.31 (SS)
STBYMD: C32.2, U16.11 (STBYMD)
SW1: C19.2, D8.2 (A), L2.2, Q3.1, Q3.2, Q3.3, Q4.5, Q4.6, Q4.7, Q4.8, U16.24 (SW1)
SW2: C20.2, D7.1 (K), L2.1, Q1.1, Q1.2, Q1.3, Q2.5, Q2.6, Q2.7, Q2.8, R27.2, U16.17 (SW2)
TG1: Q3.4, U16.26 (TG1)
TG2: Q1.4, U16.15 (TG2)
VIN19: D11.1 (K), R28.2, U16.23 (VIN)
VOS+: R19.1, R31.2
VOSENSE: R19.2, R21.1, U16.4 (VOSENSE)

Notes on the sheet:
Voltage Feedback
Overvoltage Protection
Top Gate Drivers
Voltage Out Selector Feedback
603 package
Good Operation Status Pin Pulled to High
R1_12VB - Feedback Resistor 1 R2_12VB - Feedback Resistor 2 CF_12VB - Feedback Capacitor
5V 2A Buck
5V Precision Logic
Current Selector Feedback
LTC3780EUH Development Circuit
External Freq Selector Feedback
Control / Test Header
LTC3780 IC
Input Stage
Dual 5V 1A Logic
Bottom Gate Drivers
Boosted Floating Driver Supply
Output Switching Power Circuit
Circuit Enable 4.7V Overvoltage Protection
R1_5VB - Feedback Resistor 1 R2_5VB - Feedback Resistor 2 CF_5VB - Feedback Capacitor
Current Sense Feedback
Output Stage
Bypass / Filter Capacitors
3.3V 500mA Logic
12V 2A Buck
Internal 6V LDO

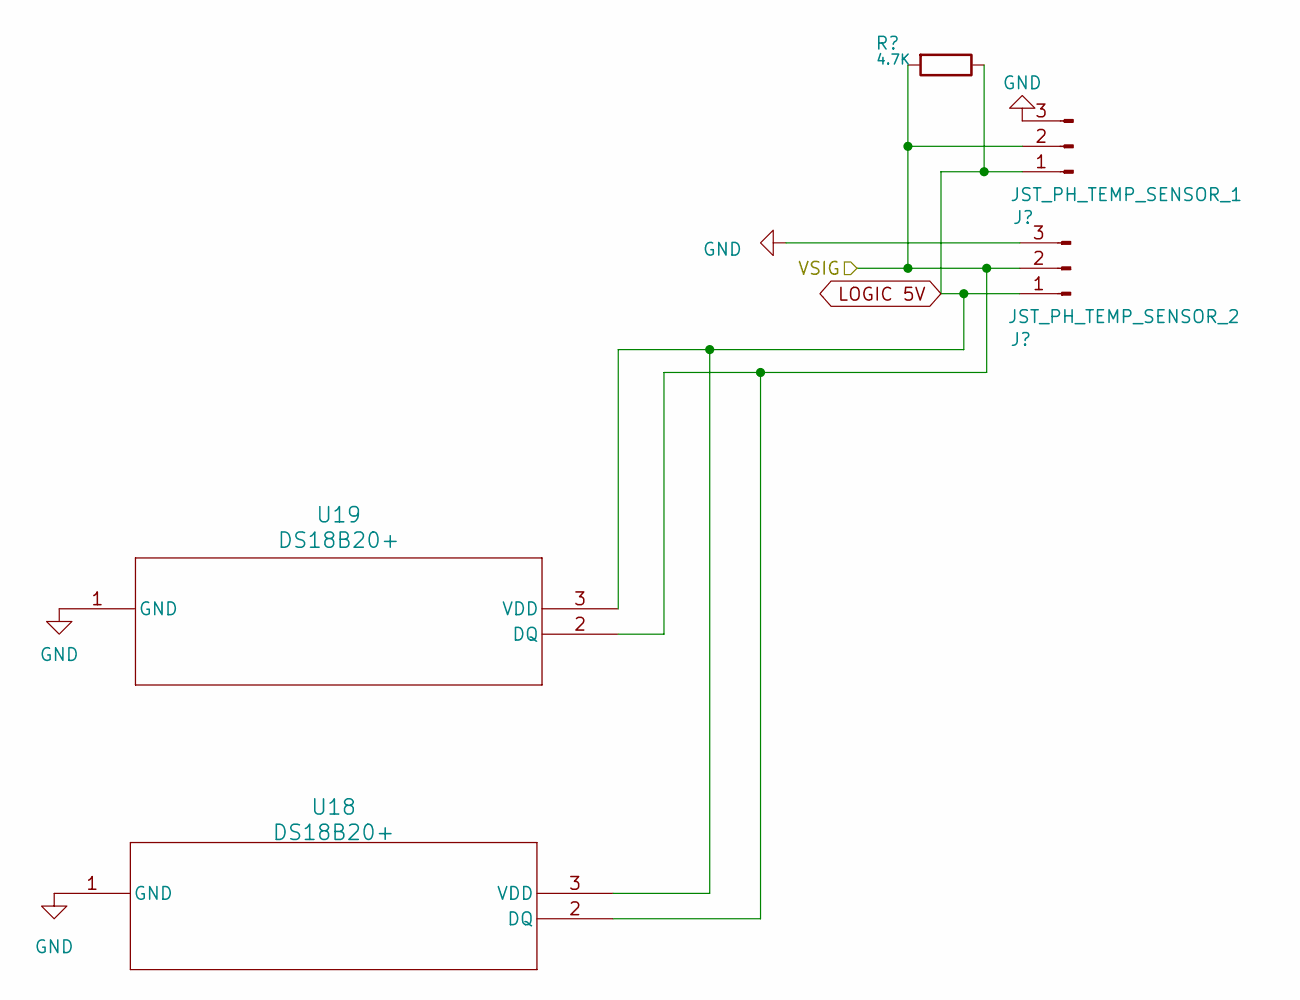
[picture p68: schematic TempSensors.kicad_sch]

Parts:
J16: JST_PH_TEMP_SENSOR_2; JST_PH_B3B-PH-K_1x03_P2.00mm_Vertical
J17: JST_PH_TEMP_SENSOR_1; JST_PH_B3B-PH-K_1x03_P2.00mm_Vertical
R44: 4.7K; R_0603_1608Metric
U18, U19: DS18B20+; TO-92L_Inline

Connections:
/DPIN5: J16.2, J17.2, R44.2, U18.2 (DQ), U19.2 (DQ); also elsewhere on the board

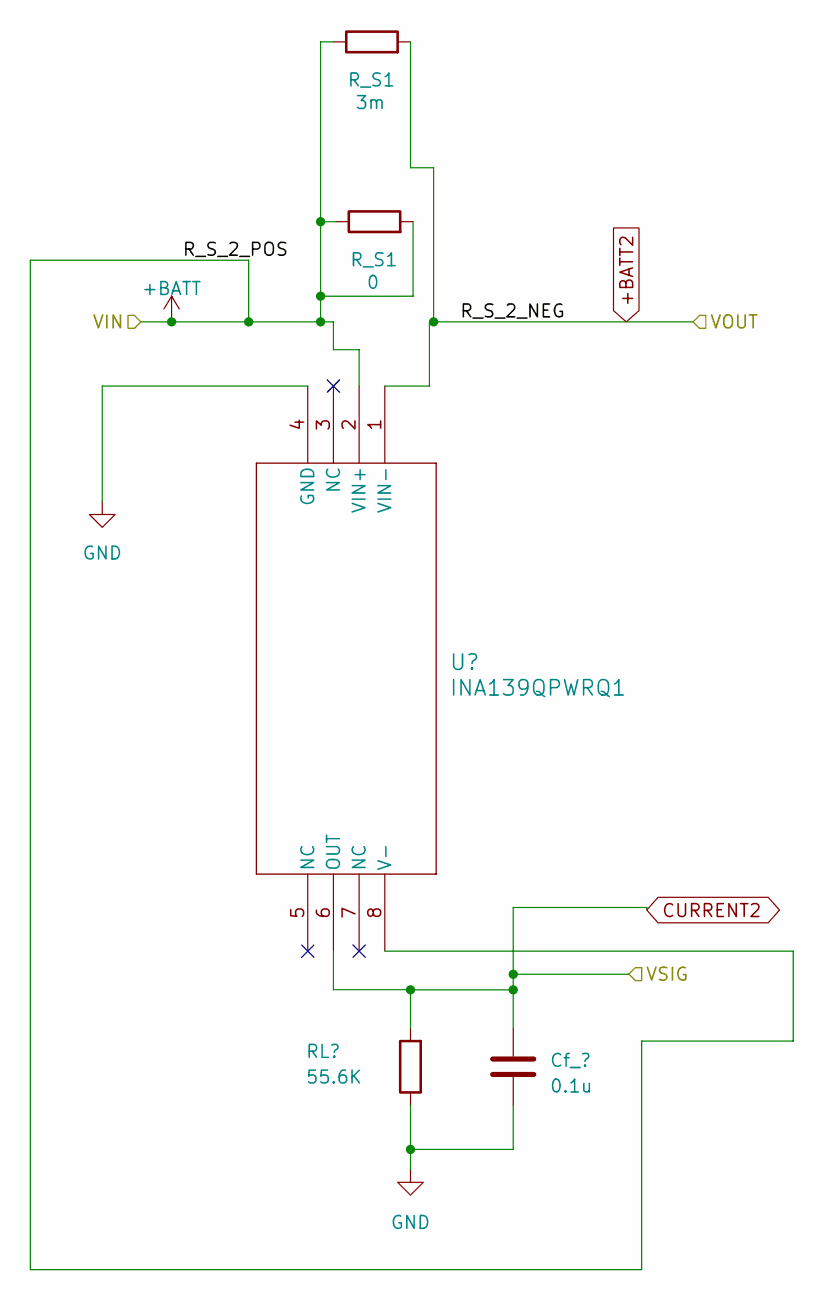
[picture p69: schematic CurrentSense2_sch.kicad_sch]

Parts:
C41: 0.1u; C_0603_1608Metric
R53: 55.6K; R_0603_1608Metric
R_S1: 0; CSS2H-5930R
U22: INA139QPWRQ1; INA139_PW8

Connections:
+BATT: U22.2 (VIN+), U22.8 (V-); also elsewhere on the board
+BATT2: U22.1 (VIN-); also elsewhere on the board
CURRENT2: C41.1, R53.2, U22.6 (OUT); also elsewhere on the board

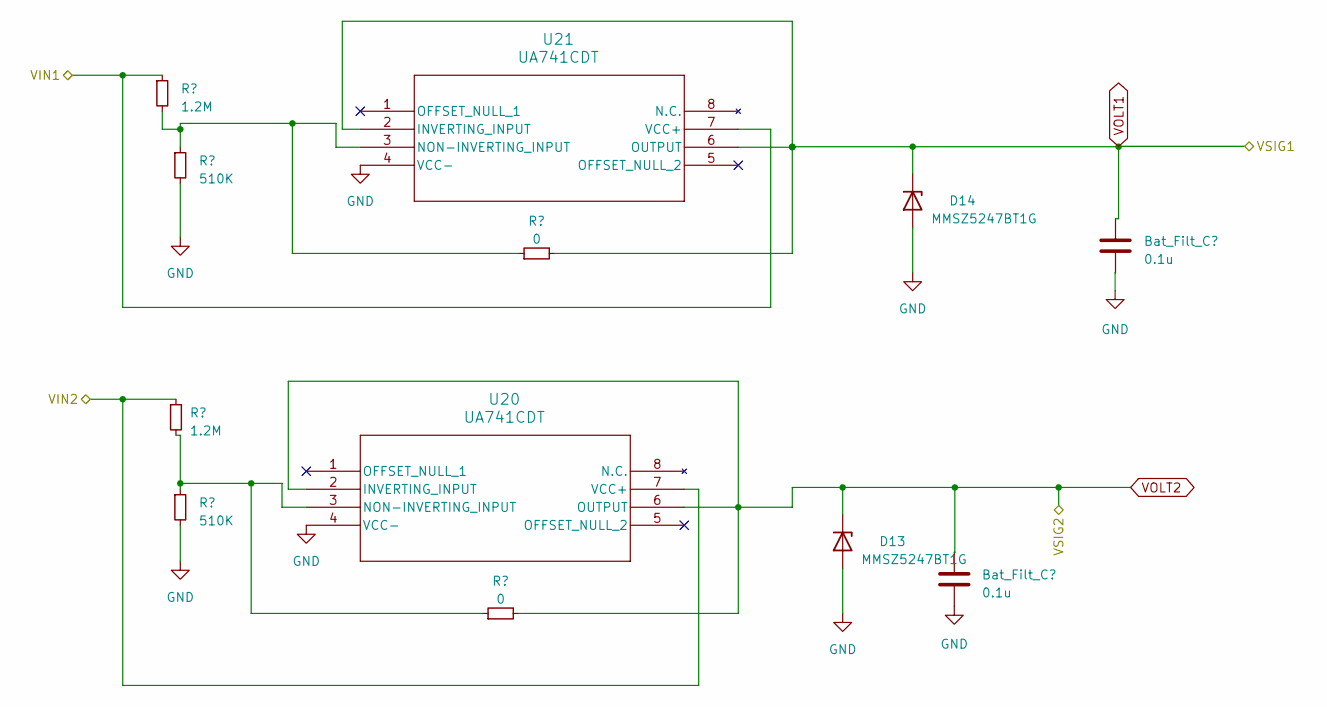
[picture p70: schematic VoltSense.kicad_sch]

Parts:
C39, C40: 0.1u; C_0603_1608Metric
D13, D14: MMSZ5247BT1G; D_SOD-123
R45, R46: 1.2M; R_1206_3216Metric
R47, R48: 510K; R_1206_3216Metric
R49, R50: 0; R_0603_1608Metric_Pad0.98x0.95mm_HandSolder
U20, U21: UA741CDT; UA741CDT_D8_TEX_STM

Connections:
unnamed: R46.2, R48.1, R49.1, U20.3 (NON-INVERTING_INPUT)
unnamed: R45.2, R47.1, R50.1, U21.3 (NON-INVERTING_INPUT)
VOLT1: C40.1, D14.1 (K), R50.2, U21.2 (INVERTING_INPUT), U21.6 (OUTPUT); also elsewhere on the board
VOLT2: C39.1, D13.1 (K), R49.2, U20.2 (INVERTING_INPUT), U20.6 (OUTPUT); also elsewhere on the board

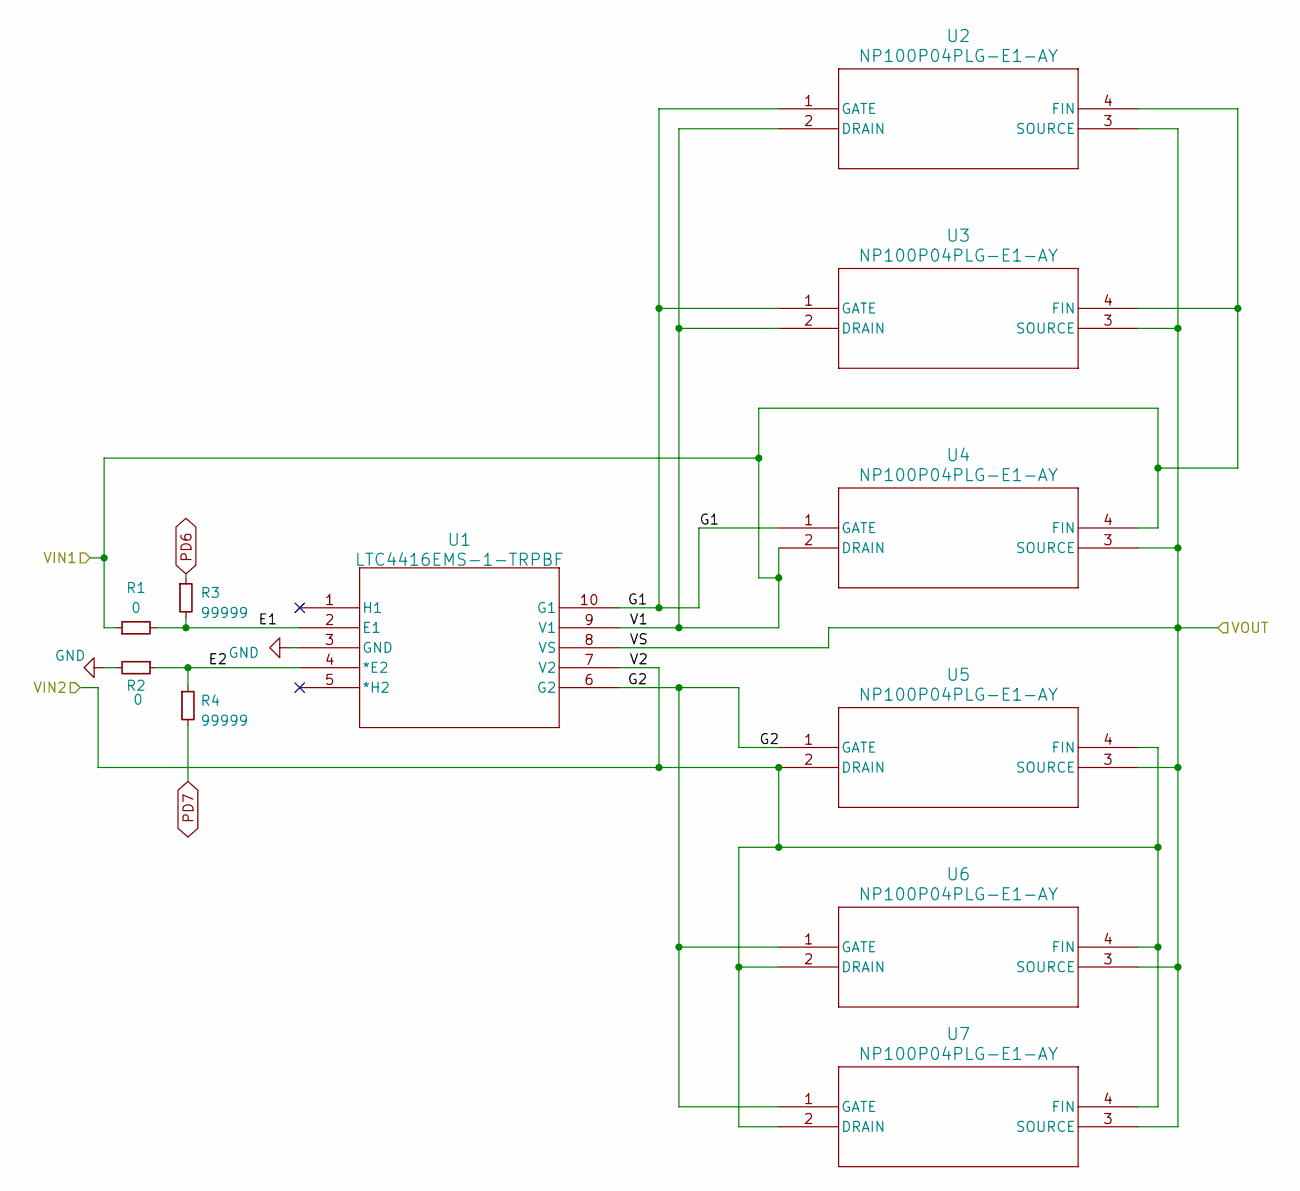
[picture p71: schematic Load_Sharing.kicad_sch]

Parts:
R1, R2: 0; R_0603_1608Metric
R3, R4: 99999; R_0603_1608Metric
U1: LTC4416EMS-1-TRPBF; LTC4416_MSOP-10_MS_LIT
U2, U3, U4, U5, U6, U7: NP100P04PLG-E1-AY; LTC3780_PRSS0004AL-A_REN

Connections:
/Load Sharing/E1: R1.2, R3.2, U1.2 (E1)
/Load Sharing/E2: R2.1, R4.1, U1.4 (*E2)
/Load Sharing/G1: U1.10 (G1), U2.1 (GATE), U3.1 (GATE), U4.1 (GATE)
/Load Sharing/G2: U1.6 (G2), U5.1 (GATE), U6.1 (GATE), U7.1 (GATE)
LOAD SHARING VOUT: U1.8 (VS), U2.3 (SOURCE), U3.3 (SOURCE), U4.3 (SOURCE), U5.3 (SOURCE), U6.3 (SOURCE), U7.3 (SOURCE); also elsewhere on the board
PD6: R3.1; also elsewhere on the board
PD7: R4.2; also elsewhere on the board

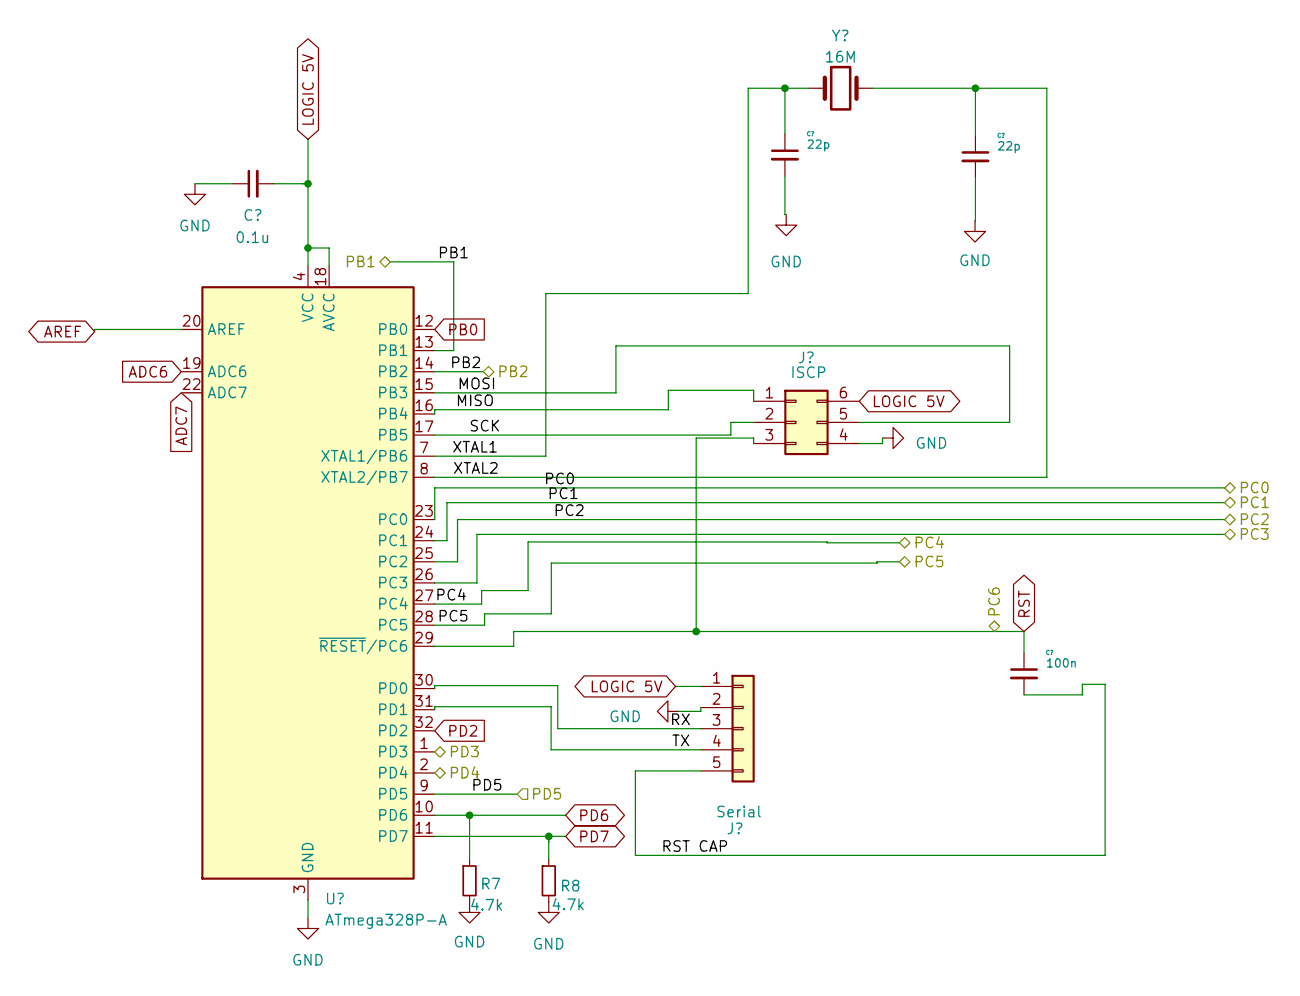
[picture p72: schematic Microcontroller.kicad_sch]

Parts:
C3: 0.1u; C_0603_1608Metric
C4, C5: 22p; C_0603_1608Metric
C6: 100n; C_0603_1608Metric
J11: Serial; PinHeader_1x05_P2.54mm_Horizontal
J12: ISCP; PinHeader_2x03_P2.54mm_Vertical
R7, R8: 4.7k; R_0603_1608Metric
U9: ATmega328P-A; TQFP-32_7x7mm_P0.8mm
Y1: 16M; Crystal_SMD_HC49-SD

Connections:
/DPIN1: U9.1 (PD3); also elsewhere on the board
/DPIN5: U9.9 (PD5); also elsewhere on the board
/DPIN14: U9.14 (PB2); also elsewhere on the board
/Microcontroller/MISO: J12.1, U9.16 (PB4)
/Microcontroller/MOSI: J12.5, U9.15 (PB3)
/Microcontroller/PC4: U9.27 (PC4); also elsewhere on the board
/Microcontroller/PC5: U9.28 (PC5); also elsewhere on the board
/Microcontroller/RX: J11.3, U9.30 (PD0)
/Microcontroller/SCK: J12.2, U9.17 (PB5)
/Microcontroller/TX: J11.4, U9.31 (PD1)
/Microcontroller/XTAL1: C4.1, U9.7 (XTAL1/PB6), Y1.1
/Microcontroller/XTAL2: C5.1, U9.8 (XTAL2/PB7), Y1.2
ADC6: U9.19 (ADC6); also elsewhere on the board
ADC7: U9.22 (ADC7); also elsewhere on the board
AREF: U9.20 (AREF); also elsewhere on the board
CURRENT1: U9.25 (PC2); also elsewhere on the board
CURRENT2: U9.26 (PC3); also elsewhere on the board
PB0: U9.12 (PB0); also elsewhere on the board
PD2: U9.32 (PD2); also elsewhere on the board
PD6: R7.1, U9.10 (PD6); also elsewhere on the board
PD7: R8.1, U9.11 (PD7); also elsewhere on the board
VOLT1: U9.23 (PC0); also elsewhere on the board
VOLT2: U9.24 (PC1); also elsewhere on the board
