Kenkneeshio/SeniorDesign-Team9/KiCad/RPS01-Revision 2/rps01.kicad_pcb

## KiCad design KiCad/RPS01-Revision 2/rps01.kicad_pcb (continued)

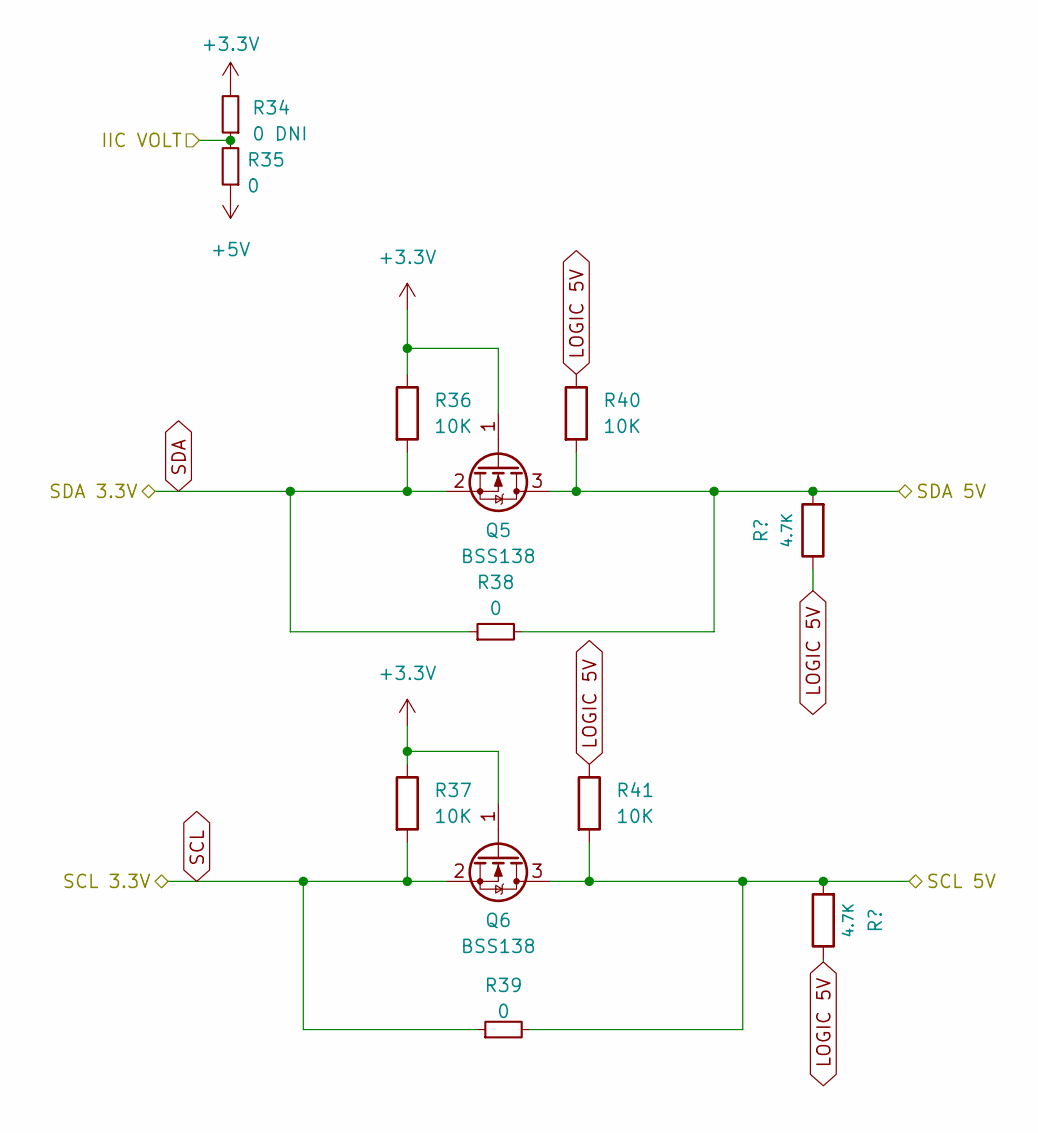
[picture p73: schematic LLC.kicad_sch]

Parts:
Q5, Q6: BSS138; SOT-23
R34: 0 DNI; R_0603_1608Metric
R35, R38, R39: 0; R_0603_1608Metric
R36, R37, R40, R41: 10K; R_0603_1608Metric
R42, R43: 4.7K; R_0603_1608Metric

Connections:
+3.3V: Q5.1 (G), Q6.1 (G), R34.2, R36.1, R37.1; also elsewhere on the board
+5V: R35.1; also elsewhere on the board
/Logic Level Converter/IIC VOLT: R34.1, R35.2; also elsewhere on the board
/Microcontroller/PC4: Q5.3 (D), R38.2, R40.2, R42.2; also elsewhere on the board
/Microcontroller/PC5: Q6.3 (D), R39.2, R41.2, R43.2; also elsewhere on the board
SCL: Q6.2 (S), R37.2, R39.1; also elsewhere on the board
SDA: Q5.2 (S), R36.2, R38.1; also elsewhere on the board

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
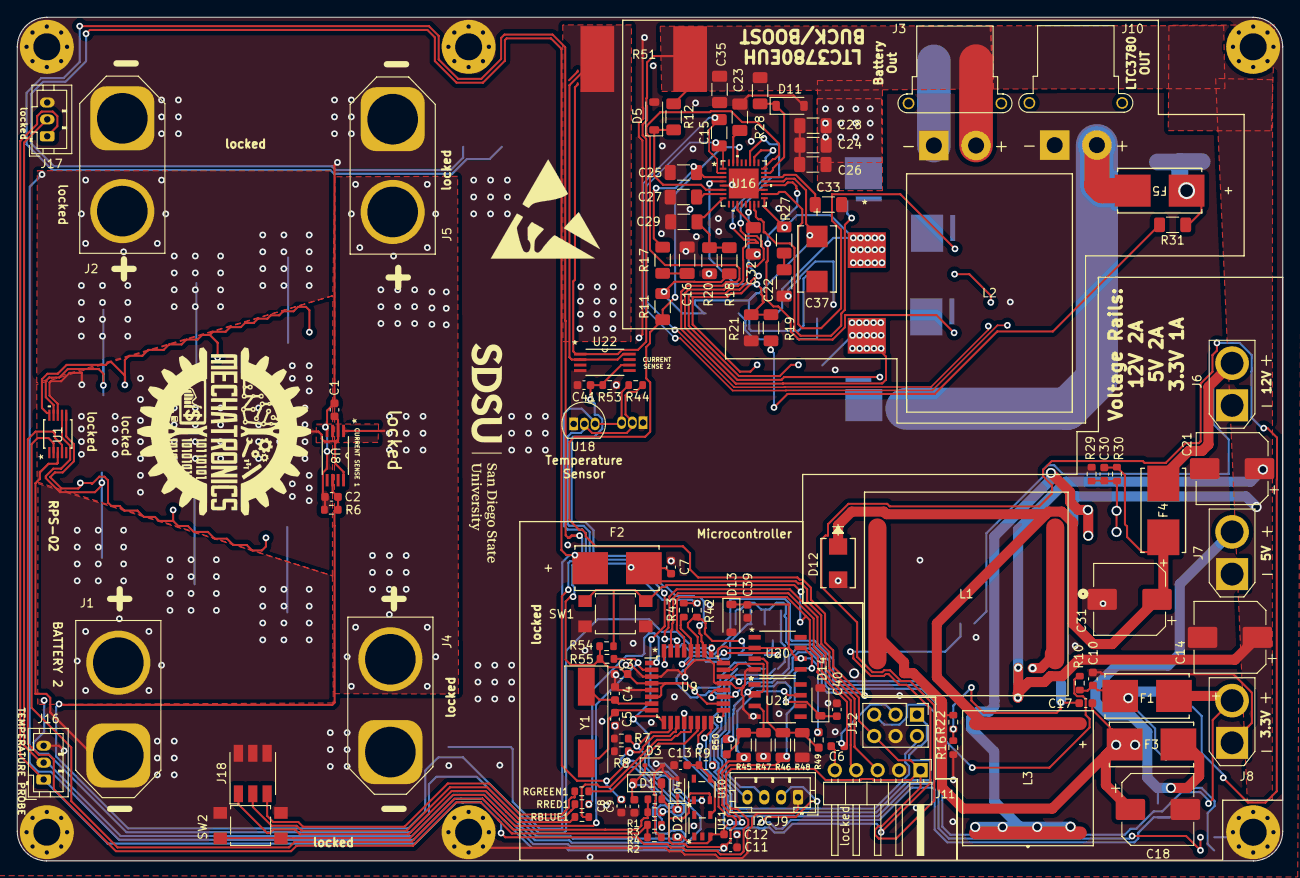
[picture p74: board KiCad/RPS01-Revision 2/rps01.kicad_pcb from above]

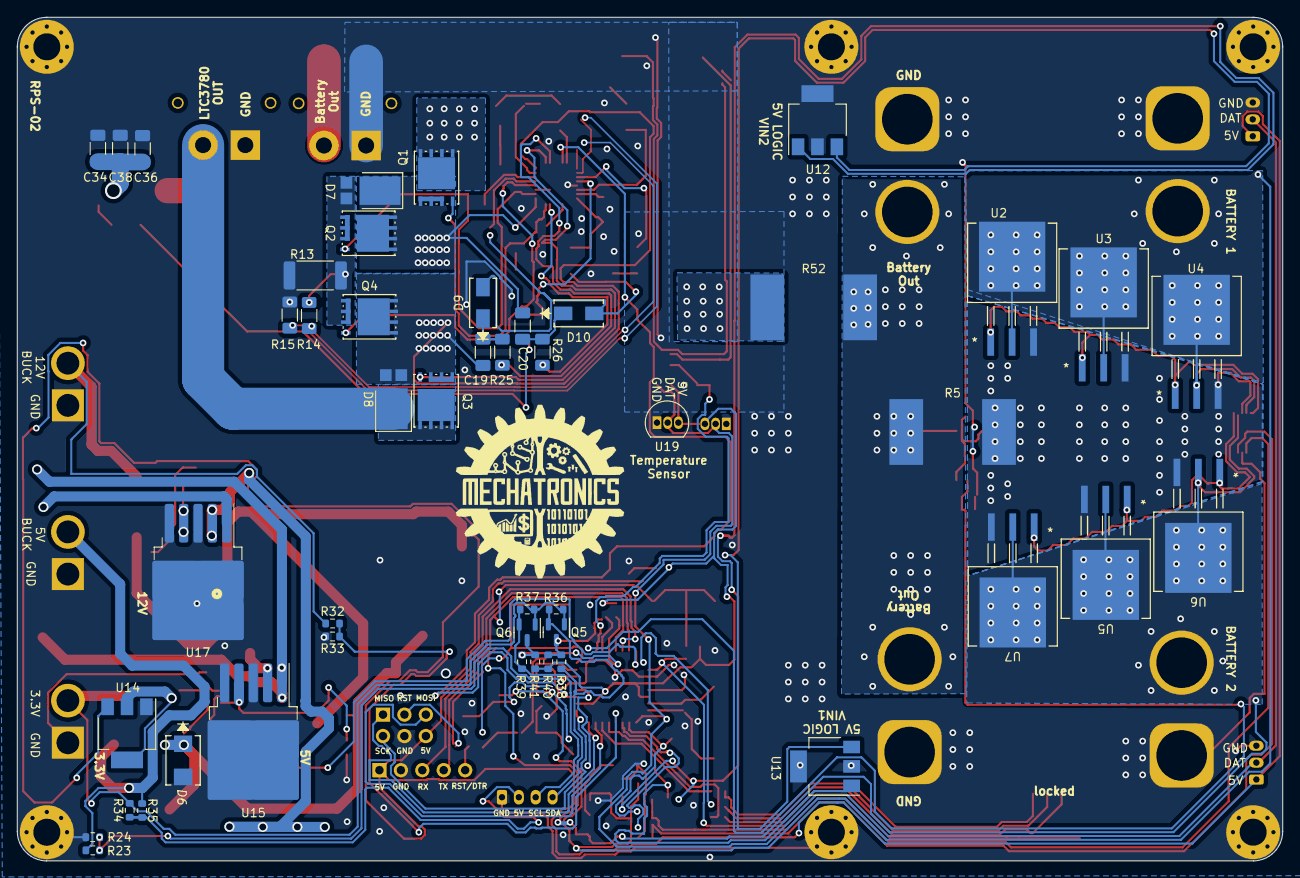
[picture p75: board KiCad/RPS01-Revision 2/rps01.kicad_pcb from below]

Board: 2 copper layers, 150.0 x 100.0 mm, 173 parts (47 on the bottom side), 88 nets.

Other parts of the board:
C11, C12, C13: 0.1u; C_0603_1608Metric
R9, R10: 0; R_0603_1608Metric
R51: 3m; CSS2H-5930R
R52: 0; CSS2H-5930R
U10, U11: ADR02AUJZ-REEL7; ADR02AUJZ_REEL7_UJ_5_ADI

Their connections:
+BATT: R51.1, R52.1, R52.2; also elsewhere on the board
+BATT2: R51.2; also elsewhere on the board
AREF: R9.2; also elsewhere on the board
unnamed: C13.1, R9.1, U10.4 (VOUT), U11.4 (VOUT)
PD2: R10.1; also elsewhere on the board
