Kenkneeshio/SeniorDesign-Team9/KiCad/KENESP32LTC370TEST/KENESP32LTC370TEST.kicad_pcb

## KiCad design KiCad/KENESP32LTC370TEST/KENESP32LTC370TEST.kicad_pcb (2023-11-01)

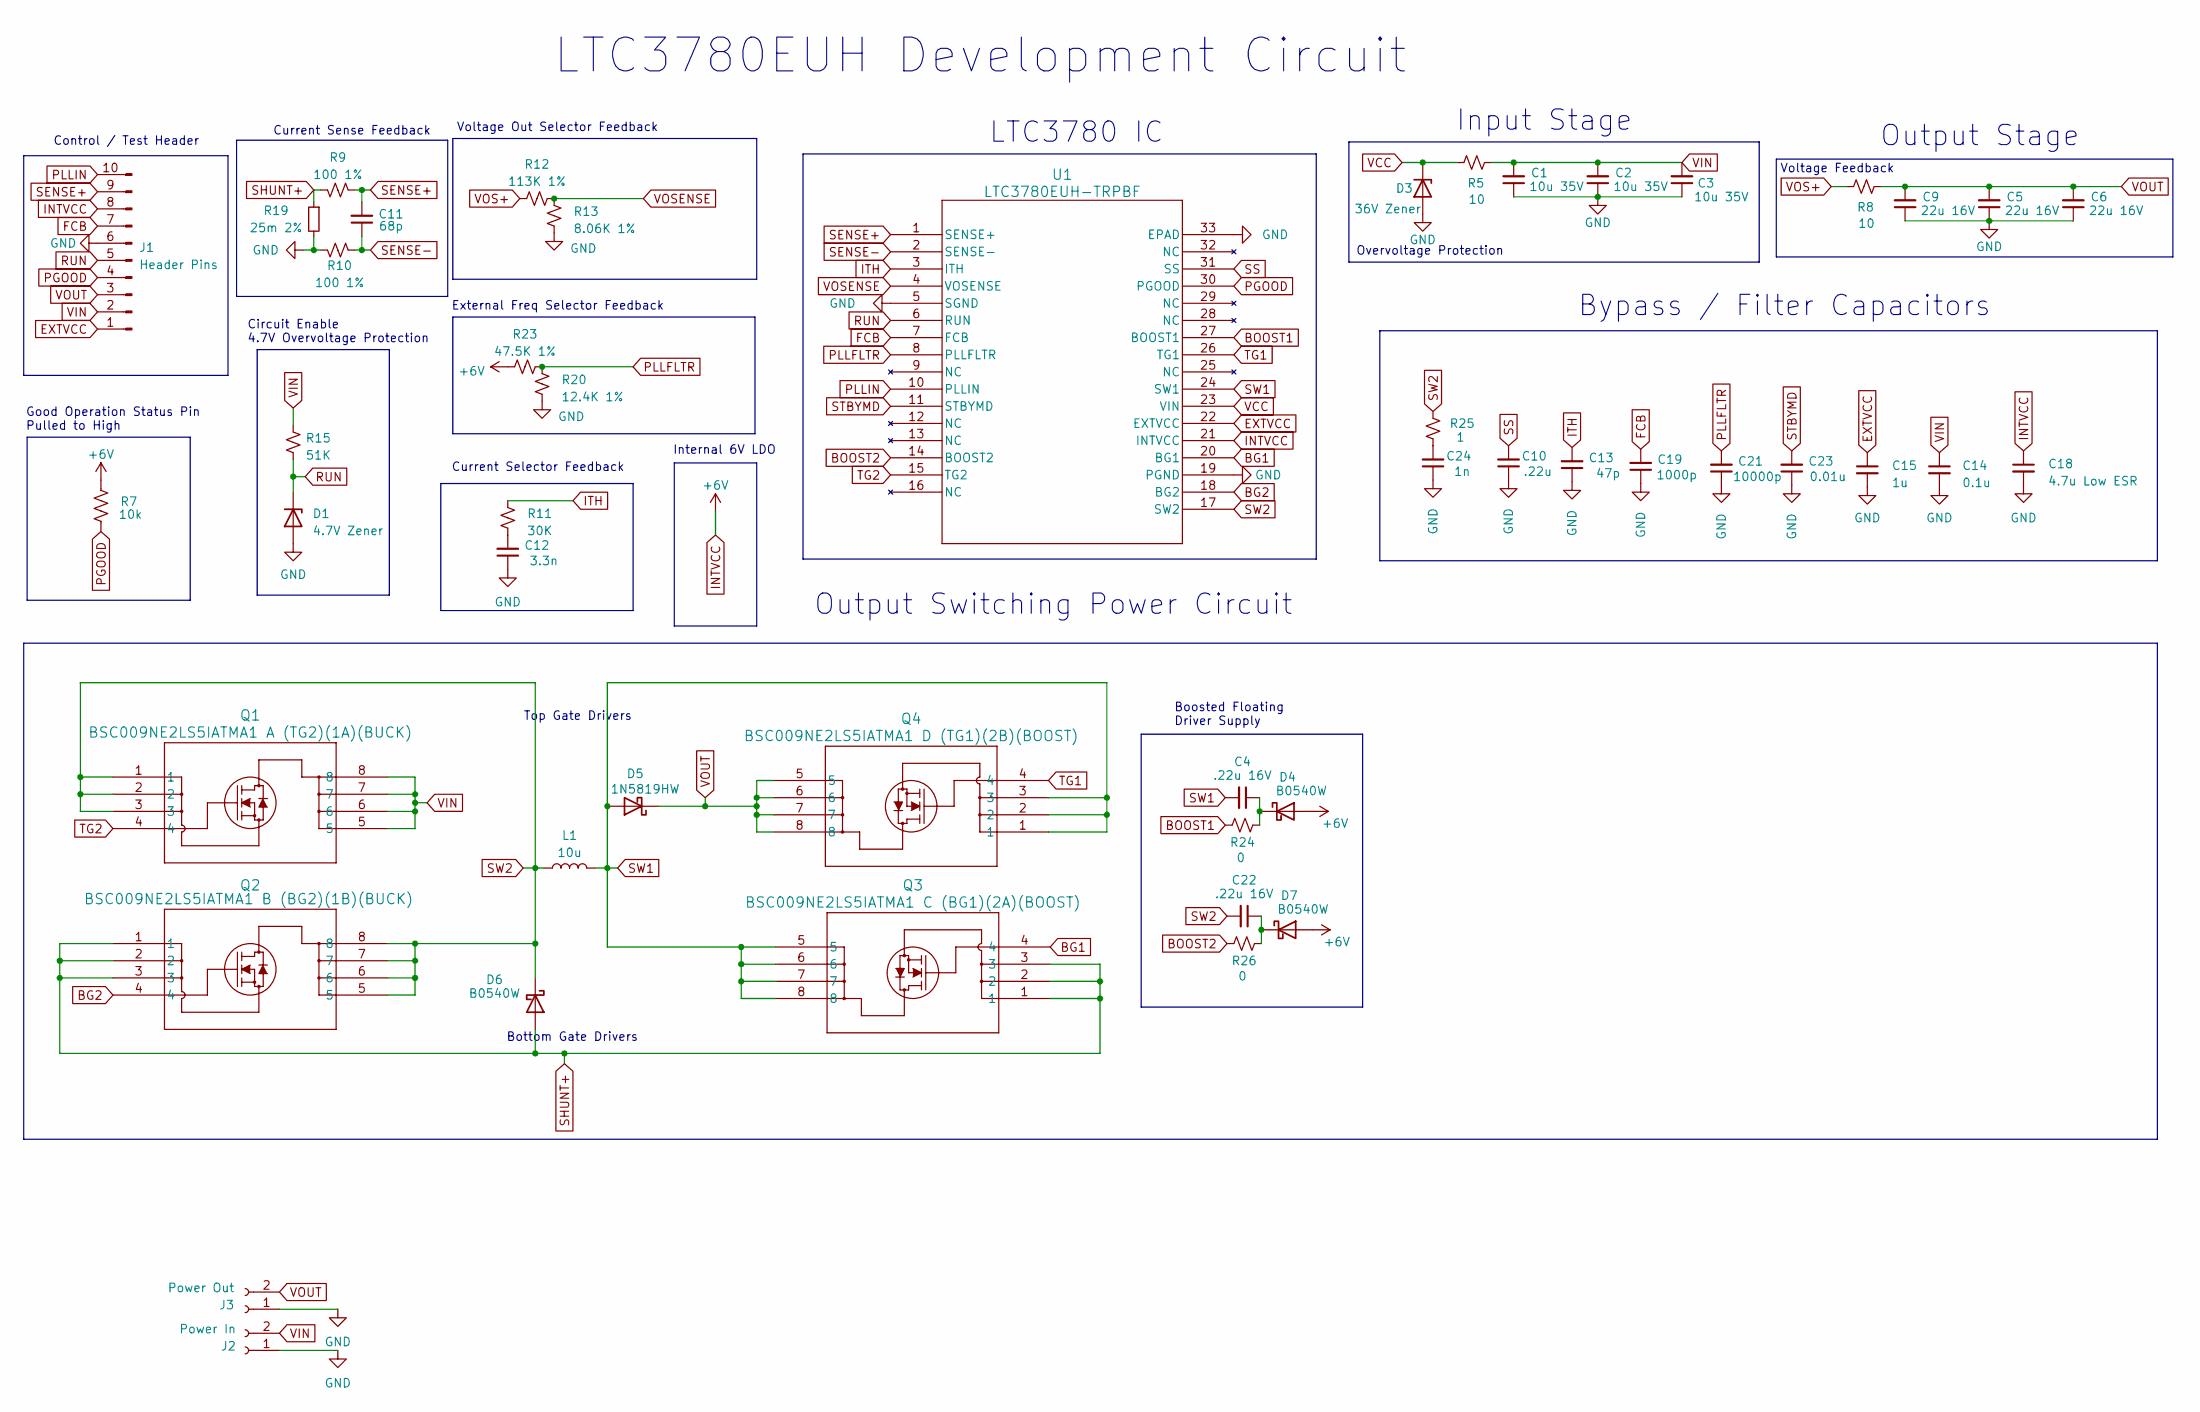
[picture p76: schematic KENESP32LTC370TEST.kicad_sch, LTC3780 Development Circuit]

Parts:
C1, C2, C3: 10u 35V; C_1206_3216Metric_Pad1.33x1.80mm_HandSolder
C4, C22: .22u 16V; C_1206_3216Metric_Pad1.33x1.80mm_HandSolder
C5, C6, C9: 22u 16V; C_1206_3216Metric_Pad1.33x1.80mm_HandSolder
C10: .22u; C_1206_3216Metric_Pad1.33x1.80mm_HandSolder
C11: 68p; C_1206_3216Metric_Pad1.33x1.80mm_HandSolder
C12: 3.3n; C_1206_3216Metric_Pad1.33x1.80mm_HandSolder
C13: 47p; C_1206_3216Metric_Pad1.33x1.80mm_HandSolder
C14: 0.1u; C_1206_3216Metric_Pad1.33x1.80mm_HandSolder
C15: 1u; C_1206_3216Metric_Pad1.33x1.80mm_HandSolder
C18: 4.7u Low ESR; LOWESRCAPMP7.6X4.3_3.1N_KEM
C19: 1000p; C_1206_3216Metric_Pad1.33x1.80mm_HandSolder
C21: 10000p; C_1206_3216Metric_Pad1.33x1.80mm_HandSolder
C23: 0.01u; C_1206_3216Metric_Pad1.33x1.80mm_HandSolder
C24: 1n; C_1206_3216Metric_Pad1.33x1.80mm_HandSolder
D1: 4.7V Zener; D_SOD-123
D3: 36V Zener; D_SOD-123
D4, D6, D7: B0540W; CR_SMA_320-340AE_DIO
D5: 1N5819HW; CR_SMA_320-340AE_DIO
J1: Header Pins; PinHeader_1x10_P2.54mm_Vertical
J2: Power In; AMASS_XT30U-M_1x02_P5.0mm_Vertical
J3: Power Out; AMASS_XT30U-F_1x02_P5.0mm_Vertical
L1: 10u; IND_410680_WRE
Q1: BSC009NE2LS5IATMA1 A (TG2)(1A)(BUCK); PG-TDSON-8_INF
Q2: BSC009NE2LS5IATMA1 B (BG2)(1B)(BUCK); PG-TDSON-8_INF
Q3: BSC009NE2LS5IATMA1 C (BG1)(2A)(BOOST); PG-TDSON-8_INF
Q4: BSC009NE2LS5IATMA1 D (TG1)(2B)(BOOST); PG-TDSON-8_INF
R5, R8: 10; R_1206_3216Metric_Pad1.30x1.75mm_HandSolder
R7: 10k; R_1206_3216Metric_Pad1.30x1.75mm_HandSolder
R9, R10: 100 1%; R_1206_3216Metric_Pad1.30x1.75mm_HandSolder
R11: 30K; R_1206_3216Metric_Pad1.30x1.75mm_HandSolder
R12: 113K 1%; R_1206_3216Metric_Pad1.30x1.75mm_HandSolder
R13: 8.06K 1%; R_1206_3216Metric_Pad1.30x1.75mm_HandSolder
R15: 51K; R_1206_3216Metric_Pad1.30x1.75mm_HandSolder
R19: 25m 2%; R_1206_3216Metric_Pad1.30x1.75mm_HandSolder
R20: 12.4K 1%; R_1206_3216Metric_Pad1.30x1.75mm_HandSolder
R23: 47.5K 1%; R_1206_3216Metric_Pad1.30x1.75mm_HandSolder
R24, R26: 0; R_1206_3216Metric_Pad1.30x1.75mm_HandSolder
R25: 1; R_1206_3216Metric_Pad1.30x1.75mm_HandSolder
U1: LTC3780EUH-TRPBF; QFN-32_UH_LIT

Connections:
BG1: Q3.4, U1.20 (BG1)
BG2: Q2.4, U1.18 (BG2)
BOOST1: R24.1, U1.27 (BOOST1)
BOOST2: R26.1, U1.14 (BOOST2)
EXTVCC: C15.1, J1.1, U1.22 (EXTVCC)
FCB: C19.2, J1.7, U1.7 (FCB)
GND: C1.1, C2.1, C3.1, C5.1, C6.1, C9.1, C10.1, C12.1, C13.1, C14.2, C15.2, C18.2, C19.1, C21.1, C23.1, C24.1, D1.2 (A), D3.2 (A), J1.6, J2.1, J3.1, R10.2, R13.2, R19.2, R20.2, U1.5 (SGND), U1.19 (PGND), U1.33 (EPAD)
INTVCC: C18.1, D4.2 (A), D7.2 (A), J1.8, R7.1, R23.1, U1.21 (INTVCC)
ITH: C13.2, R11.1, U1.3 (ITH)
unnamed: C12.2, R11.2
unnamed: C24.2, R25.1
unnamed: C4.1, D4.1 (K), R24.2
unnamed: C22.1, D7.1 (K), R26.2
PGOOD: J1.4, R7.2, U1.30 (PGOOD)
PLLFLTR: C21.2, R20.1, R23.2, U1.8 (PLLFLTR)
PLLIN: J1.10, U1.10 (PLLIN)
RUN: D1.1 (K), J1.5, R15.2, U1.6 (RUN)
SENSE+: C11.2, J1.9, R9.1, U1.1 (SENSE+)
SENSE-: C11.1, R10.1, U1.2 (SENSE-)
SHUNT+: D6.2 (A), Q2.1, Q2.2, Q2.3, Q3.1, Q3.2, Q3.3, R9.2, R19.1
SS: C10.2, U1.31 (SS)
STBYMD: C23.2, U1.11 (STBYMD)
SW1: C4.2, D5.2 (A), L1.2, Q3.5, Q3.6, Q3.7, Q3.8, Q4.1, Q4.2, Q4.3, U1.24 (SW1)
SW2: C22.2, D6.1 (K), L1.1, Q1.1, Q1.2, Q1.3, Q2.5, Q2.6, Q2.7, Q2.8, R25.2, U1.17 (SW2)
TG1: Q4.4, U1.26 (TG1)
TG2: Q1.4, U1.15 (TG2)
VCC: D3.1 (K), R5.2, U1.23 (VIN)
VIN: C1.2, C2.2, C3.2, C14.1, J1.2, J2.2, Q1.5, Q1.6, Q1.7, Q1.8, R5.1, R15.1
VOS+: R8.2, R12.1
VOSENSE: R12.2, R13.1, U1.4 (VOSENSE)
VOUT: C5.2, C6.2, C9.2, D5.1 (K), J1.3, J3.2, Q4.5, Q4.6, Q4.7, Q4.8, R8.1

Notes on the sheet:
Control / Test Header
Boosted Floating Driver Supply
LTC3780 IC
Input Stage
Voltage Out Selector Feedback
Top Gate Drivers
LTC3780EUH Development Circuit
Bypass / Filter Capacitors
External Freq Selector Feedback
Good Operation Status Pin Pulled to High
Overvoltage Protection
Internal 6V LDO
Circuit Enable 4.7V Overvoltage Protection
Voltage Feedback
Current Selector Feedback
Output Switching Power Circuit
Bottom Gate Drivers
Current Sense Feedback
Output Stage

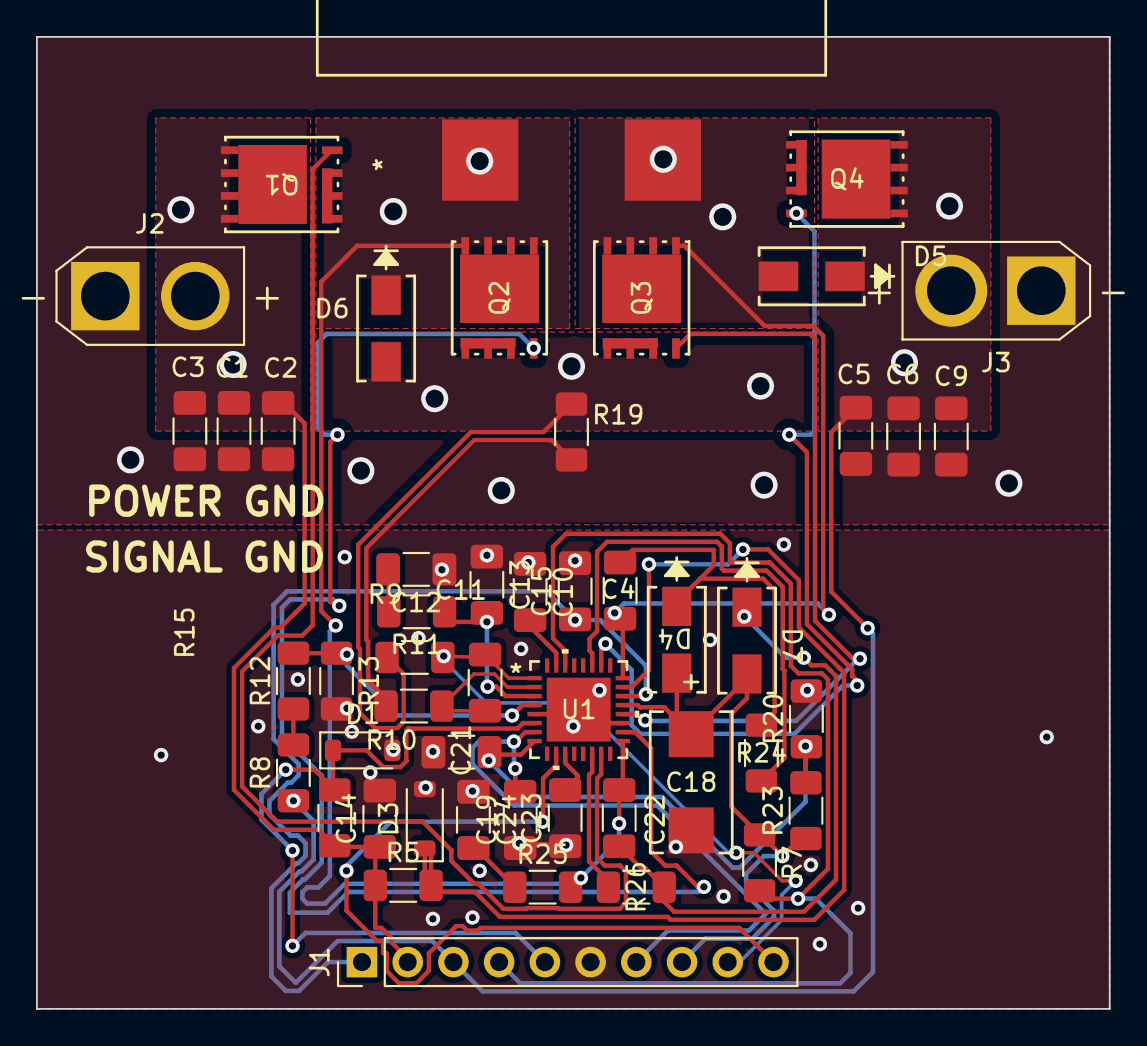
[picture p77: board KENESP32LTC370TEST.kicad_pcb from above]

Board: 2 copper layers, 59.6 x 54.0 mm, 49 parts (0 on the bottom side), 31 nets.
