Kenkneeshio/SeniorDesign-Team9/KiCad/RPS01-Revision 1/rps01.kicad_pcb

## KiCad design KiCad/RPS01-Revision 1/rps01.kicad_pcb (2023-09-22, an earlier design)

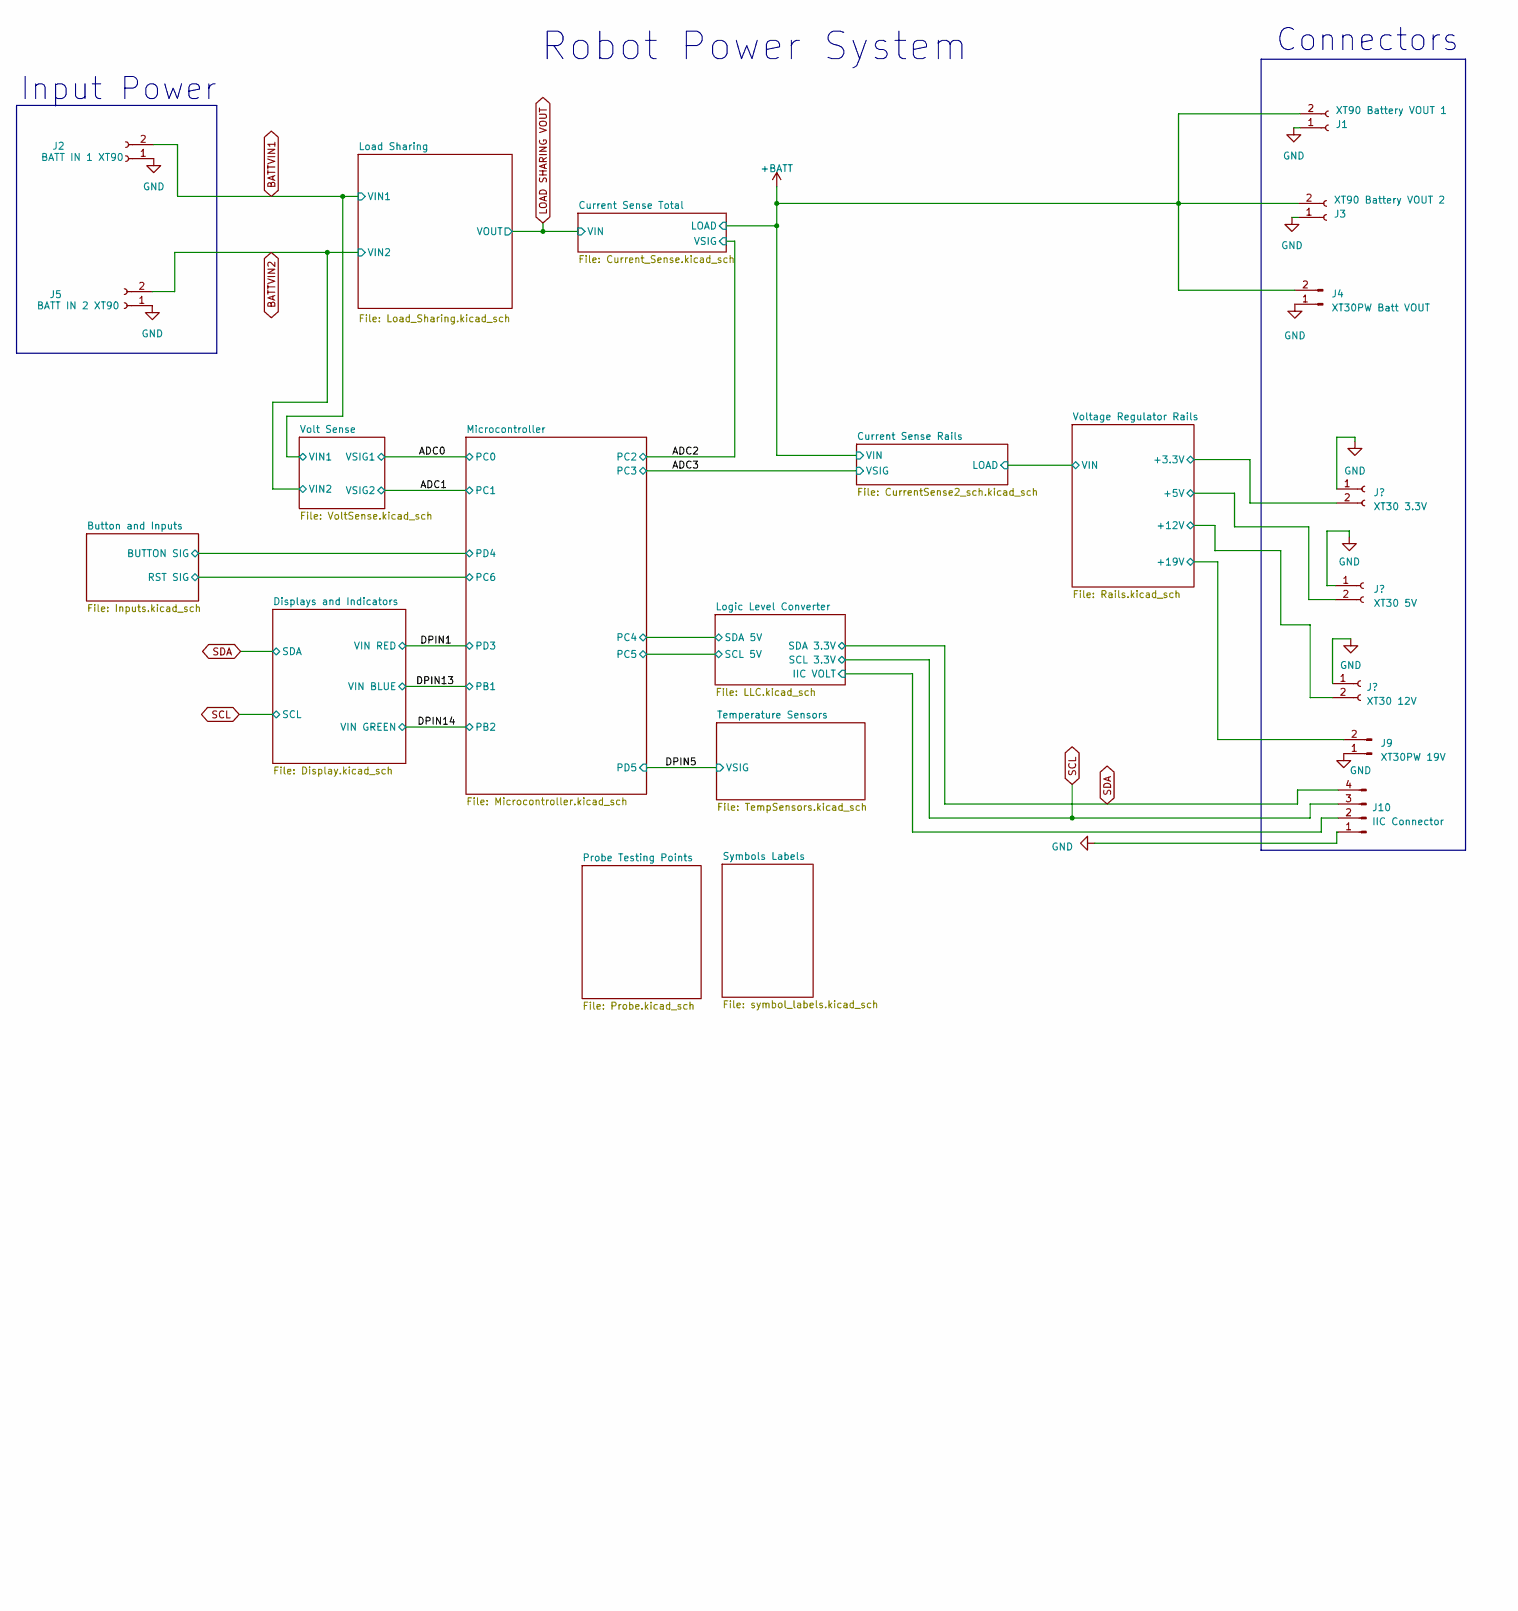
[picture p78: schematic rps01.kicad_sch, Spring Team 9 Senior Design, part in row 1, column 1]

Parts:
J1: XT90 Battery VOUT 1; AMASS_XT90-F_1x02_P11.00mm_Vertical
J2: BATT IN 1 XT90; AMASS_XT90-M_1x02_P11.00mm_Vertical
J3: XT90 Battery VOUT 2; AMASS_XT90-F_1x02_P11.00mm_Vertical
J4: XT30PW Batt VOUT; AMASS_XT30PW-F_1x02_P2.50mm_Horizontal
J5: BATT IN 2 XT90; AMASS_XT90-M_1x02_P11.00mm_Vertical
J6: XT30 3.3V; AMASS_XT30U-F_1x02_P5.0mm_Vertical
J7: XT30 5V; AMASS_XT30U-F_1x02_P5.0mm_Vertical
J8: XT30 12V; AMASS_XT30U-F_1x02_P5.0mm_Vertical
J9: XT30PW 19V; AMASS_XT30PW-F_1x02_P2.50mm_Horizontal
J10: IIC Connector; JST_PH_B4B-PH-K_1x04_P2.00mm_Vertical

Connections:
+3.3V: J6.2; also elsewhere on the board
+5V: J7.2; also elsewhere on the board
+12V: J8.2; also elsewhere on the board
+19V: J9.2; also elsewhere on the board
/Logic Level Converter/IIC VOLT: J10.2; also elsewhere on the board
BATTVIN1: J2.2; also elsewhere on the board
BATTVIN2: J5.2; also elsewhere on the board
SCL: J10.3; also elsewhere on the board
SDA: J10.4; also elsewhere on the board

Notes on the sheet:
Connectors
Robot Power System
Input Power

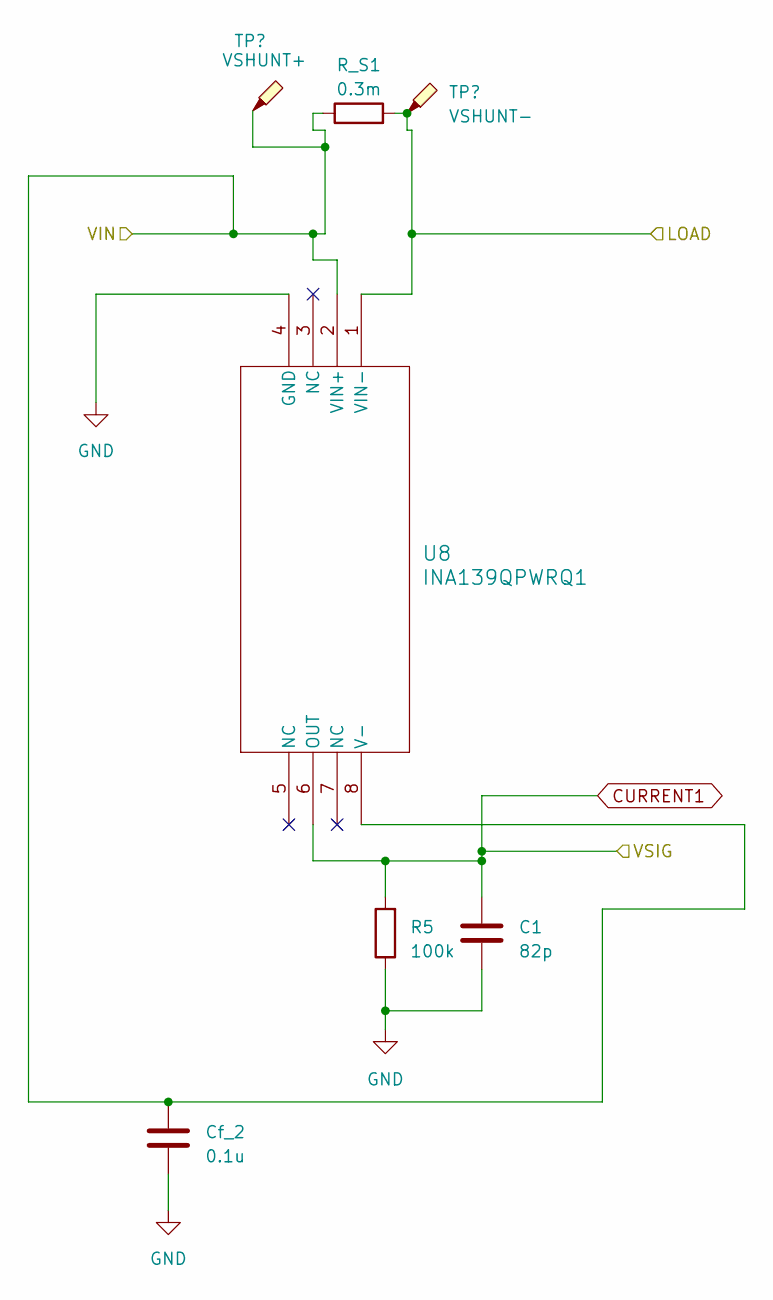
[picture p79: schematic Current_Sense.kicad_sch]

Parts:
C1: 82p; C_0603_1608Metric
Cf_2: 0.1u; C_0603_1608Metric
R5: 100k; R_0603_1608Metric
R_S1: 0.3m; CSS2H-5930R
TP1: VSHUNT-; CONN1_RCU-0C_TEC
TP2: VSHUNT+; CONN1_RCU-0C_TEC
U8: INA139QPWRQ1; INA139_PW8

Connections:
CURRENT1: C1.1, R5.2, U8.6 (OUT); also elsewhere on the board

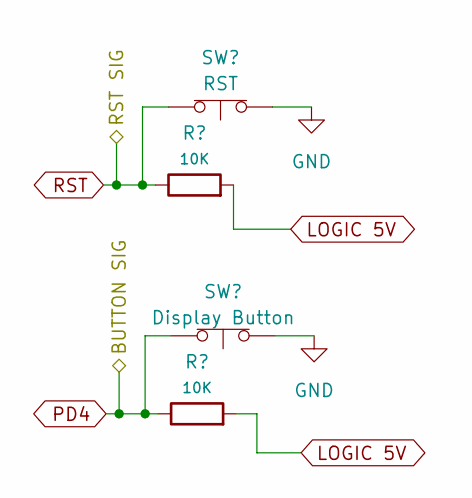
[picture p80: schematic Inputs.kicad_sch]

Parts:
R32, R33: 10K; R_0603_1608Metric
SW1: RST; SW_SPST_PTS645
SW2: Display Button; SW_SPST_PTS645

Connections:
PD4: R33.1, SW2.2 (B); also elsewhere on the board
RST: R32.1, SW1.2 (B); also elsewhere on the board

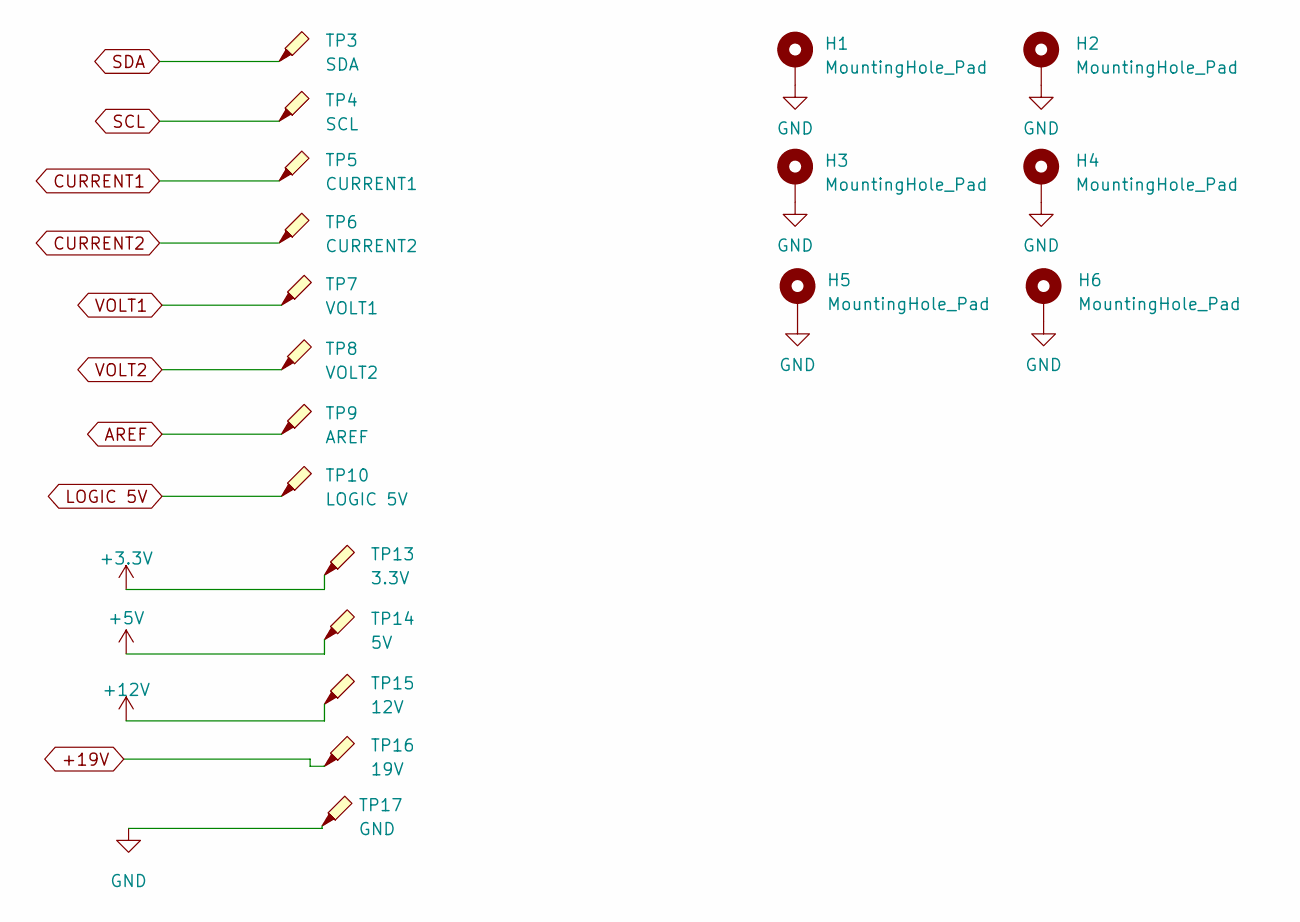
[picture p81: schematic Probe.kicad_sch]

Parts:
H1, H2, H3, H4, H5, H6: MountingHole_Pad; MountingHole_3.2mm_M3_Pad_Via
TP3: SDA; CONN1_RCU-0C_TEC
TP4: SCL; CONN1_RCU-0C_TEC
TP5: CURRENT1; CONN1_RCU-0C_TEC
TP6: CURRENT2; CONN1_RCU-0C_TEC
TP7: VOLT1; CONN1_RCU-0C_TEC
TP8: VOLT2; CONN1_RCU-0C_TEC
TP9: AREF; CONN1_RCU-0C_TEC
TP10: LOGIC 5V; CONN1_RCU-0C_TEC
TP13: 3.3V; CONN1_RCU-0C_TEC
TP14: 5V; CONN1_RCU-0C_TEC
TP15: 12V; CONN1_RCU-0C_TEC
TP16: 19V; CONN1_RCU-0C_TEC
TP17: GND; CONN1_RCU-0C_TEC

Connections:
+3.3V: TP13.1; also elsewhere on the board
+5V: TP14.1; also elsewhere on the board
+12V: TP15.1; also elsewhere on the board
+19V: TP16.1; also elsewhere on the board
AREF: TP9.1; also elsewhere on the board
CURRENT1: TP5.1; also elsewhere on the board
CURRENT2: TP6.1; also elsewhere on the board
SCL: TP4.1; also elsewhere on the board
SDA: TP3.1; also elsewhere on the board
VOLT1: TP7.1; also elsewhere on the board
VOLT2: TP8.1; also elsewhere on the board

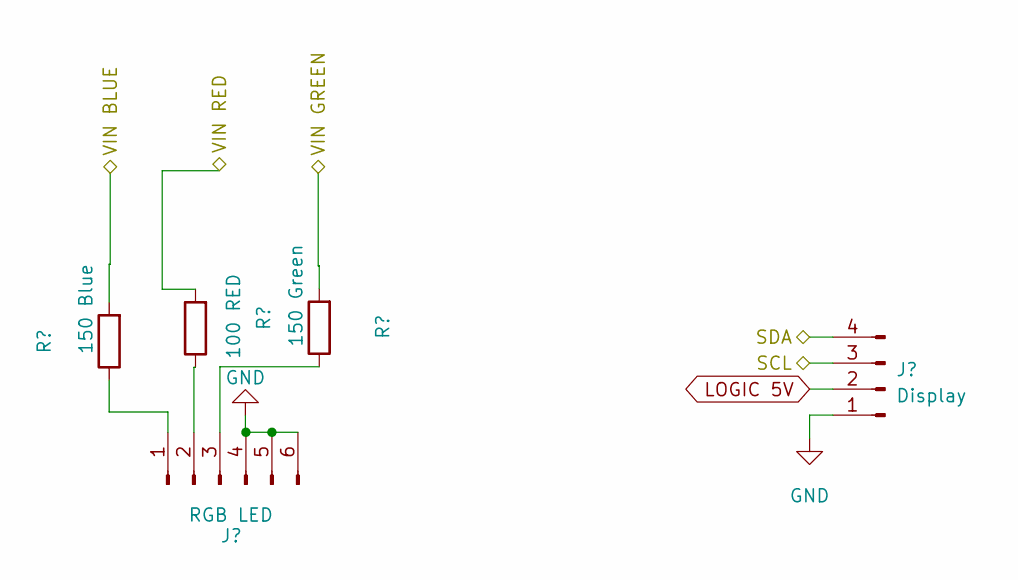
[picture p82: schematic Display.kicad_sch]

Parts:
J15: Display; 128x64OLED
J16: RGB LED; LED_RGB_5050-6
R28: 150 Green; R_0603_1608Metric
R29: 100 RED; R_0603_1608Metric
R30: 150 Blue; R_0603_1608Metric

Connections:
/DPIN1: R29.2; also elsewhere on the board
/DPIN13: R30.2; also elsewhere on the board
/DPIN14: R28.2; also elsewhere on the board
unnamed: J16.1, R30.1
unnamed: J16.2, R29.1
unnamed: J16.3, R28.1
SCL: J15.3; also elsewhere on the board
SDA: J15.4; also elsewhere on the board
