Kenkneeshio/SeniorDesign-Team9/KiCad/RPS01-Revision 1/rps01.kicad_pcb

## KiCad design KiCad/RPS01-Revision 1/rps01.kicad_pcb (continued)

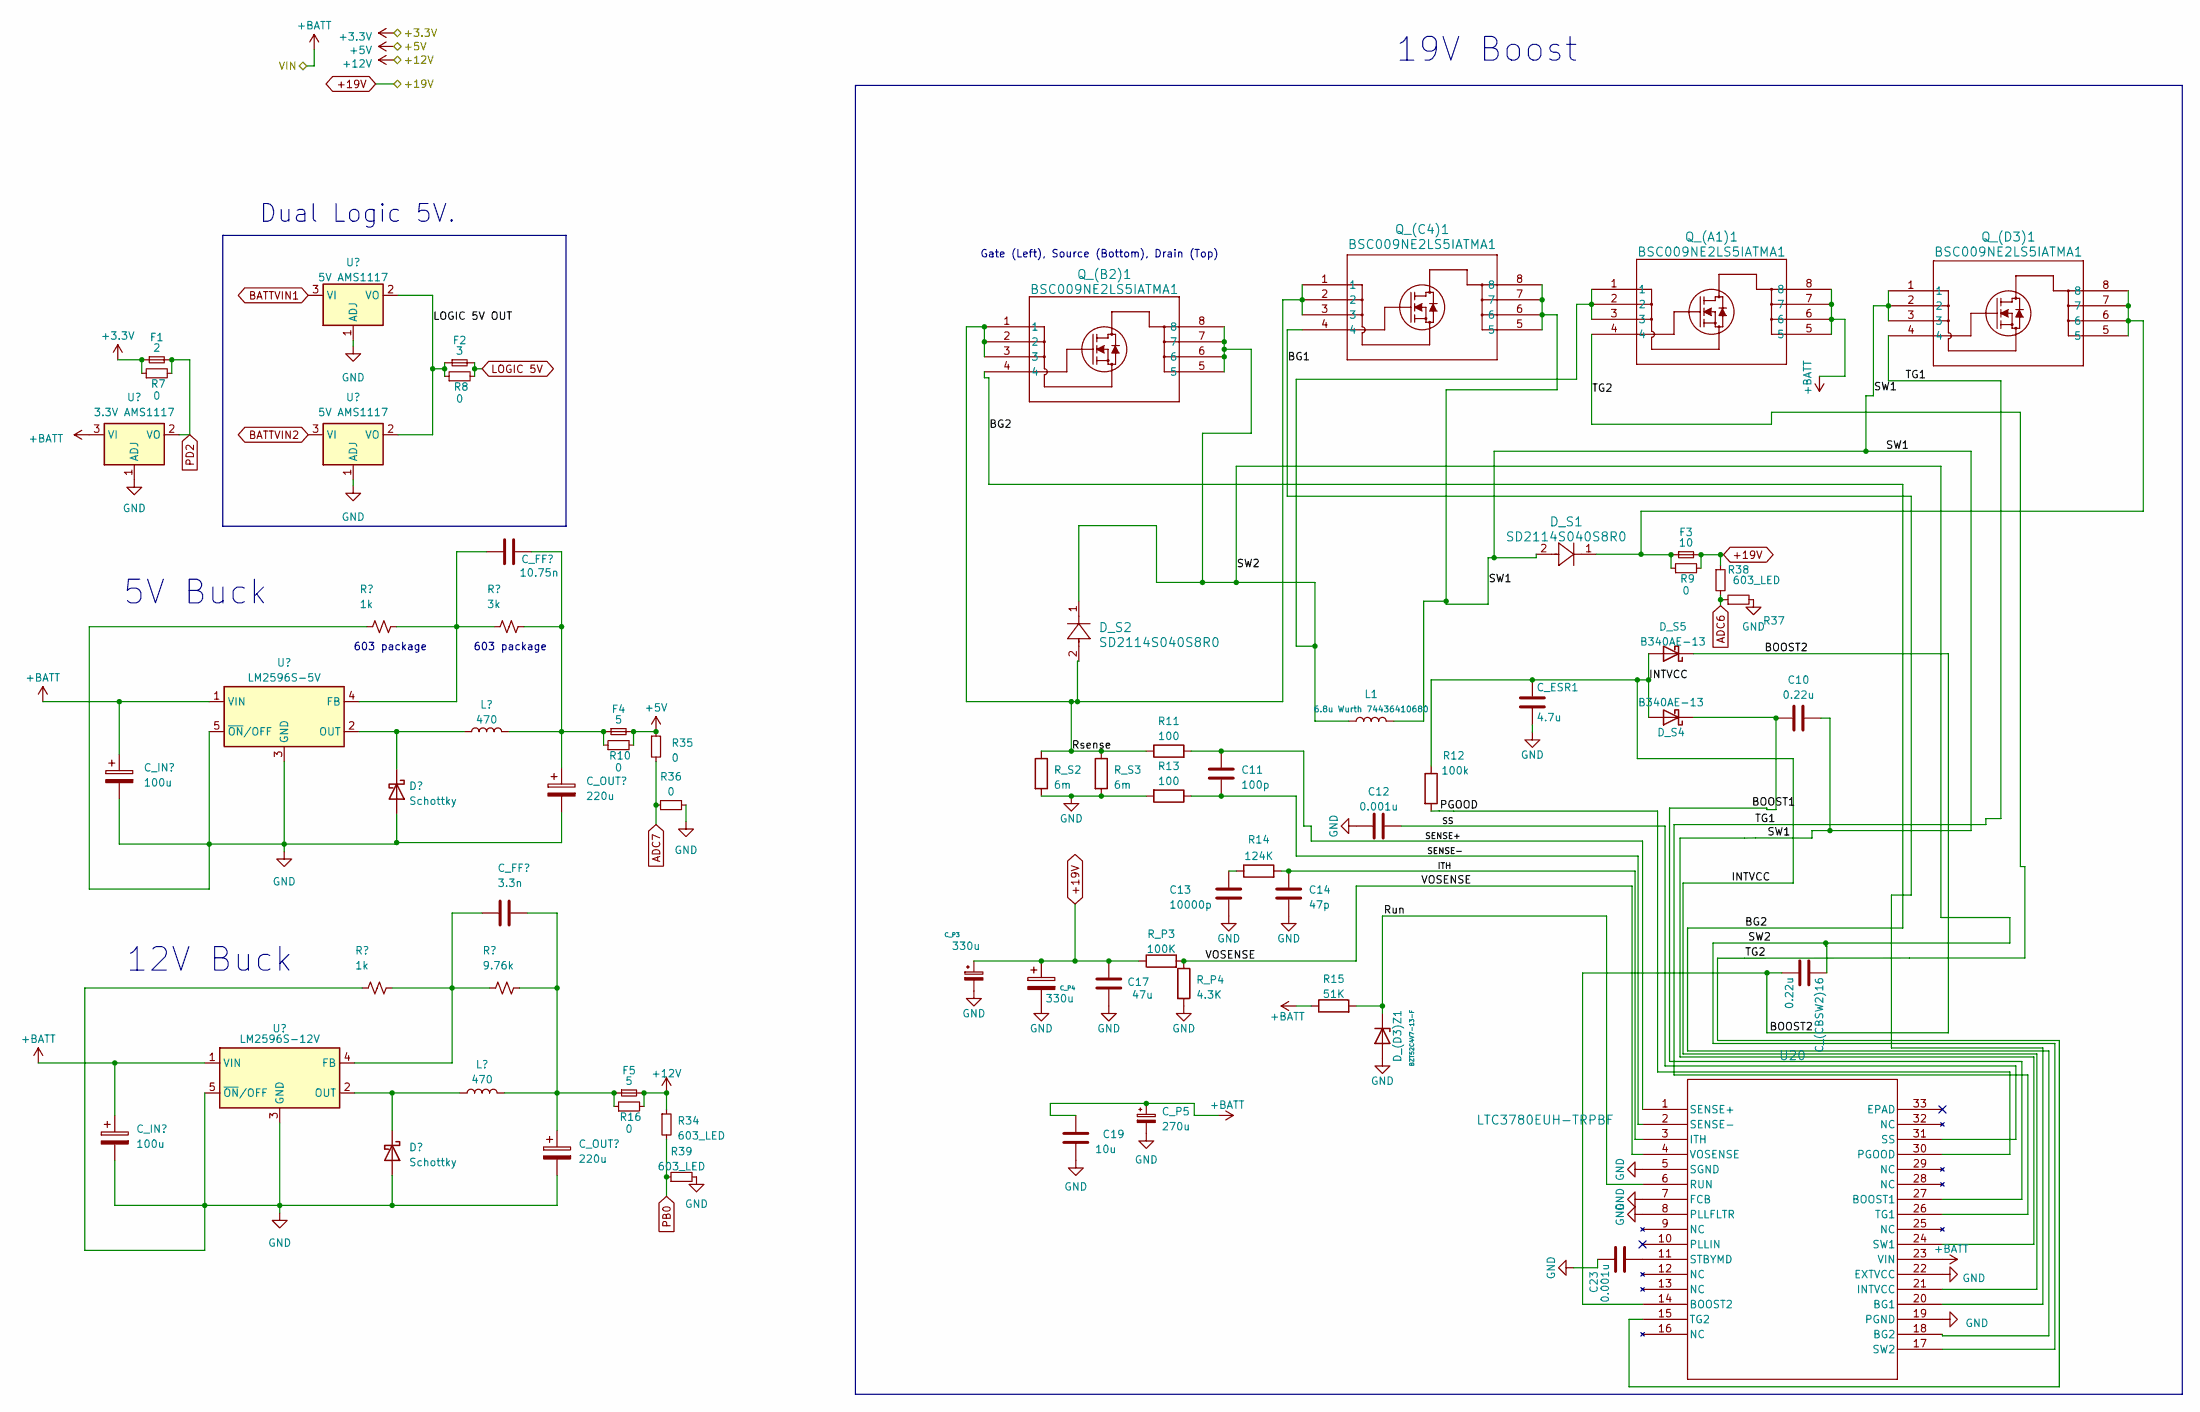
[picture p83: schematic Rails.kicad_sch]

Parts:
C9: 10.75n; C_0603_1608Metric
C10: 0.22u; C_1206_3216Metric
C11: 100p; C_1206_3216Metric
C12, C23: 0.001u; C_1206_3216Metric
C13: 10000p; C_1206_3216Metric
C14: 47p; C_1206_3216Metric
C15: 3.3n; C_0603_1608Metric
C17: 47u; C_1206_3216Metric
C19: 10u; C_1206_3216Metric
C_(CBSW2)16: 0.22u; C_1206_3216Metric
C_ESR1: 4.7u; LOWESRCAPMP7.6X4.3_3.1N_KEM
C_P1, C_P6: 100u; CP_Elec_8x10
C_P2, C_P7: 220u; CP_Elec_8x10
C_P3, C_P4: 330u; CAP_EEHZU1V331P
C_P5: 270u; LargeCAPSCAPPRD350W60D800H1200
D_(D3)Z1: BZT52C4V7-13-F; SOD123_DIO
D_S1, D_S2: SD2114S040S8R0; SD2114_AVX
D_S4, D_S5: B340AE-13; CR_SMA_320-340AE_DIO
D_S6, D_S8: Schottky; CR_SMA_320-340AE_DIO
F1: 2; 0154Series_LTF
F2: 3; 0154Series_LTF
F3: 10; 0154Series_LTF
F4, F5: 5; 0154Series_LTF
L1: 6.8u Wurth 74436410680; IND_410680_WRE
L2, L3: 470; IND_CDRH127&slash_LDNP-470MC_SUM
Q_(A1)1: BSC009NE2LS5IATMA1; PG-TDSON-8_INF
Q_(B2)1: BSC009NE2LS5IATMA1; PG-TDSON-8_INF
Q_(C4)1: BSC009NE2LS5IATMA1; PG-TDSON-8_INF
Q_(D3)1: BSC009NE2LS5IATMA1; PG-TDSON-8_INF
R7, R8, R9, R10, R16, R35, R36: 0; R_0603_1608Metric
R11, R13: 100; R_1206_3216Metric
R12: 100k; R_1206_3216Metric
R14: 124K; R_1206_3216Metric
R15: 51K; R_1206_3216Metric
R34, R37, R38, R39: 603_LED; R_0603_1608Metric
R_P1, R_P5: 1k; R_0603_1608Metric
R_P2: 3k; R_0603_1608Metric
R_P3: 100K; R_1206_3216Metric
R_P4: 4.3K; R_1206_3216Metric
R_P6: 9.76k; R_0603_1608Metric
R_S2, R_S3: 6m; R_2512_6332Metric
U11, U13: 5V AMS1117; SOT-223-3_TabPin2
U12: 3.3V AMS1117; SOT-223-3_TabPin2
U14: LM2596S-5V; TO-263-5_TabPin3
U16: LM2596S-12V; TO-263-5_TabPin3
U20: LTC3780EUH-TRPBF; QFN-32_UH_LIT

Connections:
+3.3V: F1.1, R7.1; also elsewhere on the board
+5V: F4.2, R10.2, R35.1; also elsewhere on the board
+12V: F5.2, R16.2, R34.1; also elsewhere on the board
+19V: C17.1, C_P3.1, C_P4.1, F3.2, R9.2, R37.1, R_P3.1; also elsewhere on the board
/Voltage Regulator Rails/BG1: Q_(C4)1.4, U20.20 (BG1)
/Voltage Regulator Rails/BG2: Q_(B2)1.4, U20.18 (BG2)
/Voltage Regulator Rails/BOOST1: C10.1, D_S4.1 (K), U20.27 (BOOST1)
/Voltage Regulator Rails/BOOST2: C_(CBSW2)16.2, D_S5.1 (K), U20.14 (BOOST2)
/Voltage Regulator Rails/INTVCC: C_ESR1.1, D_S4.2 (A), D_S5.2 (A), R12.1, U20.21 (INTVCC)
/Voltage Regulator Rails/ITH: C14.1, R14.2, U20.3 (ITH)
/Voltage Regulator Rails/LOGIC 5V OUT: F2.1, R8.1, U11.2 (VO), U13.2 (VO)
/Voltage Regulator Rails/PGOOD: R12.2, U20.30 (PGOOD)
/Voltage Regulator Rails/Rsense: D_S2.2, Q_(B2)1.1, Q_(B2)1.2, Q_(B2)1.3, Q_(C4)1.1, Q_(C4)1.2, Q_(C4)1.3, R11.1, R_S2.1, R_S3.1
/Voltage Regulator Rails/Run: D_(D3)Z1.1 (K), R15.2, U20.6 (RUN)
/Voltage Regulator Rails/SENSE+: C11.2, R11.2, U20.1 (SENSE+)
/Voltage Regulator Rails/SENSE-: C11.1, R13.1, U20.2 (SENSE-)
/Voltage Regulator Rails/SS: C12.2, U20.31 (SS)
/Voltage Regulator Rails/SW1: C10.2, D_S1.2, L1.2, Q_(C4)1.5, Q_(C4)1.6, Q_(C4)1.7, Q_(C4)1.8, Q_(D3)1.1, Q_(D3)1.2, Q_(D3)1.3, U20.24 (SW1)
/Voltage Regulator Rails/SW2: C_(CBSW2)16.1, D_S2.1, L1.1, Q_(A1)1.1, Q_(A1)1.2, Q_(A1)1.3, Q_(B2)1.5, Q_(B2)1.6, Q_(B2)1.7, Q_(B2)1.8, U20.17 (SW2)
/Voltage Regulator Rails/TG1: Q_(D3)1.4, U20.26 (TG1)
/Voltage Regulator Rails/TG2: Q_(A1)1.4, U20.15 (TG2)
/Voltage Regulator Rails/VOSENSE: R_P3.2, R_P4.1, U20.4 (VOSENSE)
ADC6: R37.2, R38.1; also elsewhere on the board
ADC7: R35.2, R36.1; also elsewhere on the board
BATTVIN1: U11.3 (VI); also elsewhere on the board
BATTVIN2: U13.3 (VI); also elsewhere on the board
unnamed: C9.2, C_P2.1, F4.1, L2.2, R10.1, R_P2.2
unnamed: C13.1, R14.1
unnamed: C15.2, C_P7.1, F5.1, L3.2, R16.1, R_P6.2
unnamed: D_S1.1, F3.1, Q_(D3)1.5, Q_(D3)1.6, Q_(D3)1.7, Q_(D3)1.8, R9.1
unnamed: D_S6.1 (K), L3.1, U16.2 (OUT)
unnamed: D_S8.1 (K), L2.1, U14.2 (OUT)
unnamed: C9.1, R_P1.2, R_P2.1, U14.4 (FB)
unnamed: C15.1, R_P5.2, R_P6.1, U16.4 (FB)
unnamed: C23.1, U20.11 (STBYMD)
PB0: R34.2, R39.1; also elsewhere on the board
PD2: F1.2, R7.2, U12.2 (VO); also elsewhere on the board

Notes on the sheet:
19V Boost
603 package
5V Buck
Gate (Left), Source (Bottom), Drain (Top)
Dual Logic 5V.
12V Buck

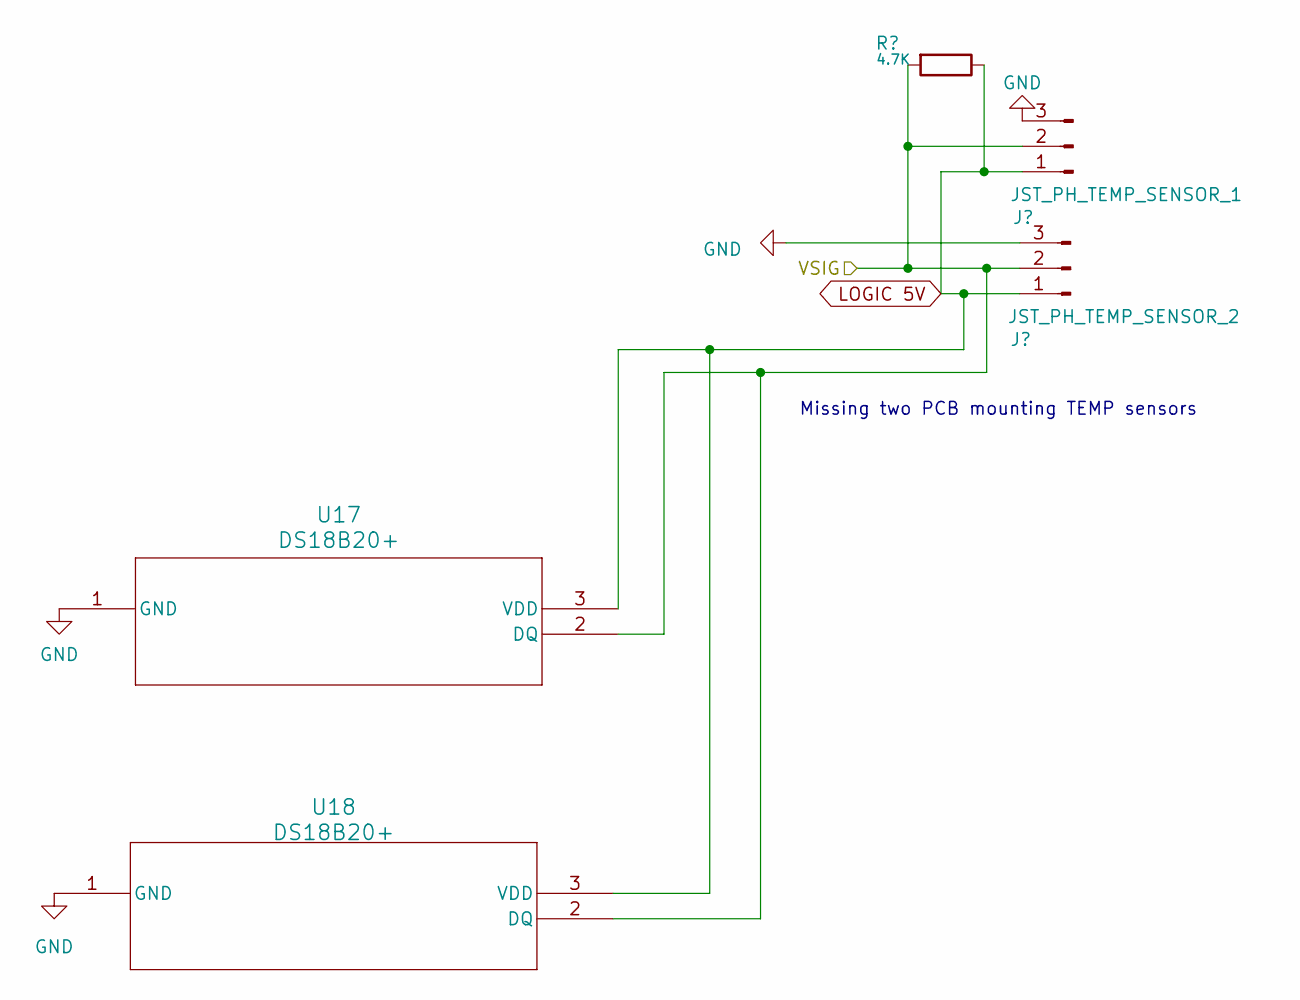
[picture p84: schematic TempSensors.kicad_sch]

Parts:
J13: JST_PH_TEMP_SENSOR_1; JST_PH_B3B-PH-K_1x03_P2.00mm_Vertical
J14: JST_PH_TEMP_SENSOR_2; JST_PH_B3B-PH-K_1x03_P2.00mm_Vertical
R27: 4.7K; R_0603_1608Metric
U17, U18: DS18B20+; TO-92L_Inline

Connections:
/DPIN5: J13.2, J14.2, R27.2, U17.2 (DQ), U18.2 (DQ); also elsewhere on the board

Notes on the sheet:
Missing two PCB mounting TEMP sensors

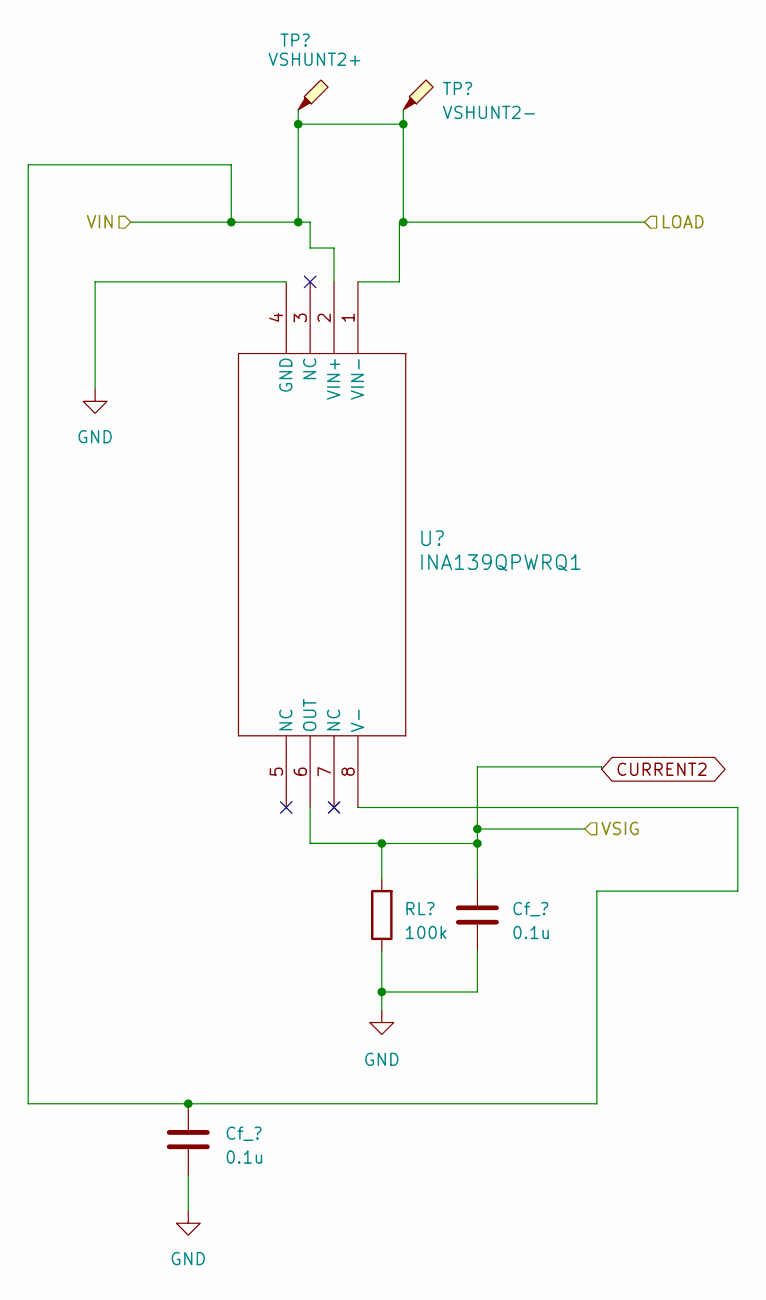
[picture p85: schematic CurrentSense2_sch.kicad_sch]

Parts:
C22: 0.1u; C_0603_1608Metric
Cf_1: 0.1u; C_0603_1608Metric
R31: 100k; R_0603_1608Metric
TP1: VSHUNT2-; CONN1_RCU-0C_TEC
TP2: VSHUNT2+; CONN1_RCU-0C_TEC
U19: INA139QPWRQ1; INA139_PW8

Connections:
CURRENT2: C22.1, R31.2, U19.6 (OUT); also elsewhere on the board

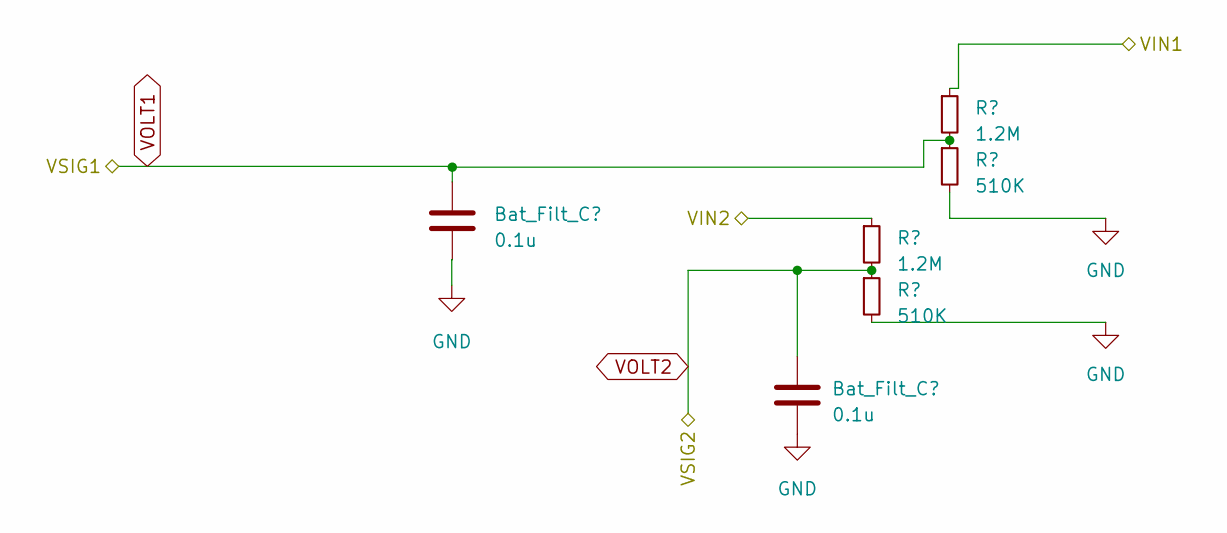
[picture p86: schematic VoltSense.kicad_sch]

Parts:
C20, C21: 0.1u; C_0603_1608Metric
R_P7, R_P9: 1.2M; R_1206_3216Metric
R_P8, R_P10: 510K; R_1206_3216Metric

Connections:
BATTVIN1: R_P7.1; also elsewhere on the board
BATTVIN2: R_P9.1; also elsewhere on the board
VOLT1: C20.1, R_P7.2, R_P8.1; also elsewhere on the board
VOLT2: C21.1, R_P9.2, R_P10.1; also elsewhere on the board

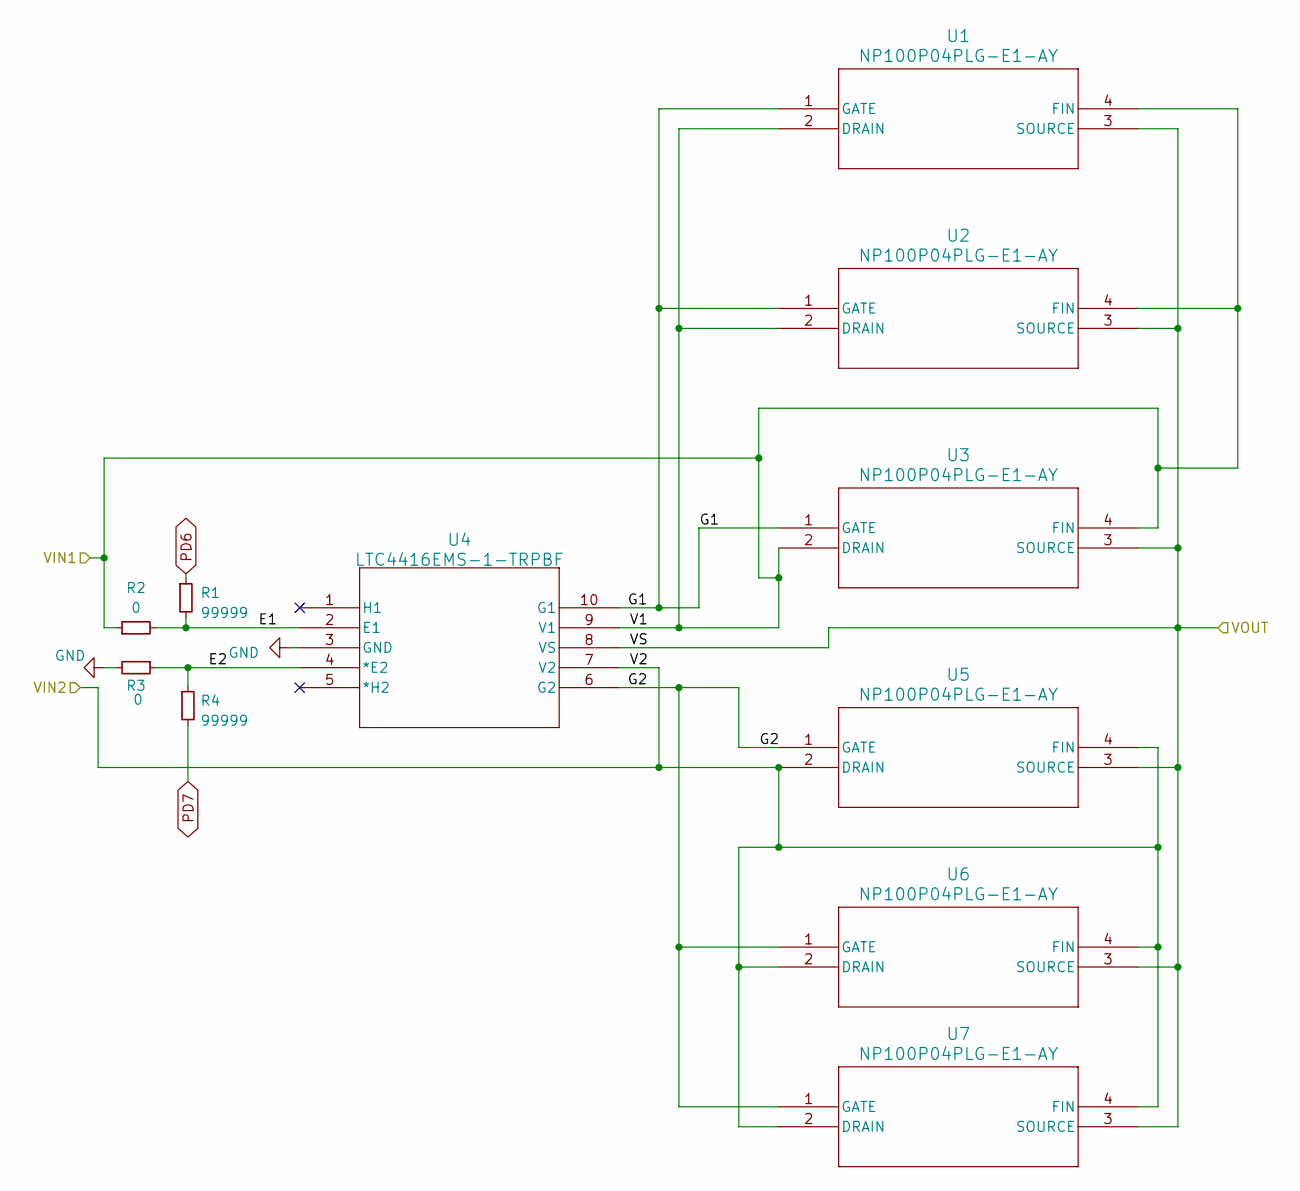
[picture p87: schematic Load_Sharing.kicad_sch]

Parts:
R1, R4: 99999; R_0603_1608Metric
R2, R3: 0; R_0603_1608Metric
U1, U2, U3, U5, U6, U7: NP100P04PLG-E1-AY; LTC3780_PRSS0004AL-A_REN
U4: LTC4416EMS-1-TRPBF; LTC4416_MSOP-10_MS_LIT

Connections:
/Load Sharing/E1: R1.2, R2.2, U4.2 (E1)
/Load Sharing/E2: R3.1, R4.1, U4.4 (*E2)
/Load Sharing/G1: U1.1 (GATE), U2.1 (GATE), U3.1 (GATE), U4.10 (G1)
/Load Sharing/G2: U4.6 (G2), U5.1 (GATE), U6.1 (GATE), U7.1 (GATE)
BATTVIN1: R2.1, U1.2 (DRAIN), U1.4 (FIN), U2.2 (DRAIN), U2.4 (FIN), U3.2 (DRAIN), U3.4 (FIN), U4.9 (V1); also elsewhere on the board
BATTVIN2: U4.7 (V2), U5.2 (DRAIN), U5.4 (FIN), U6.2 (DRAIN), U6.4 (FIN), U7.2 (DRAIN), U7.4 (FIN); also elsewhere on the board
PD6: R1.1; also elsewhere on the board
PD7: R4.2; also elsewhere on the board

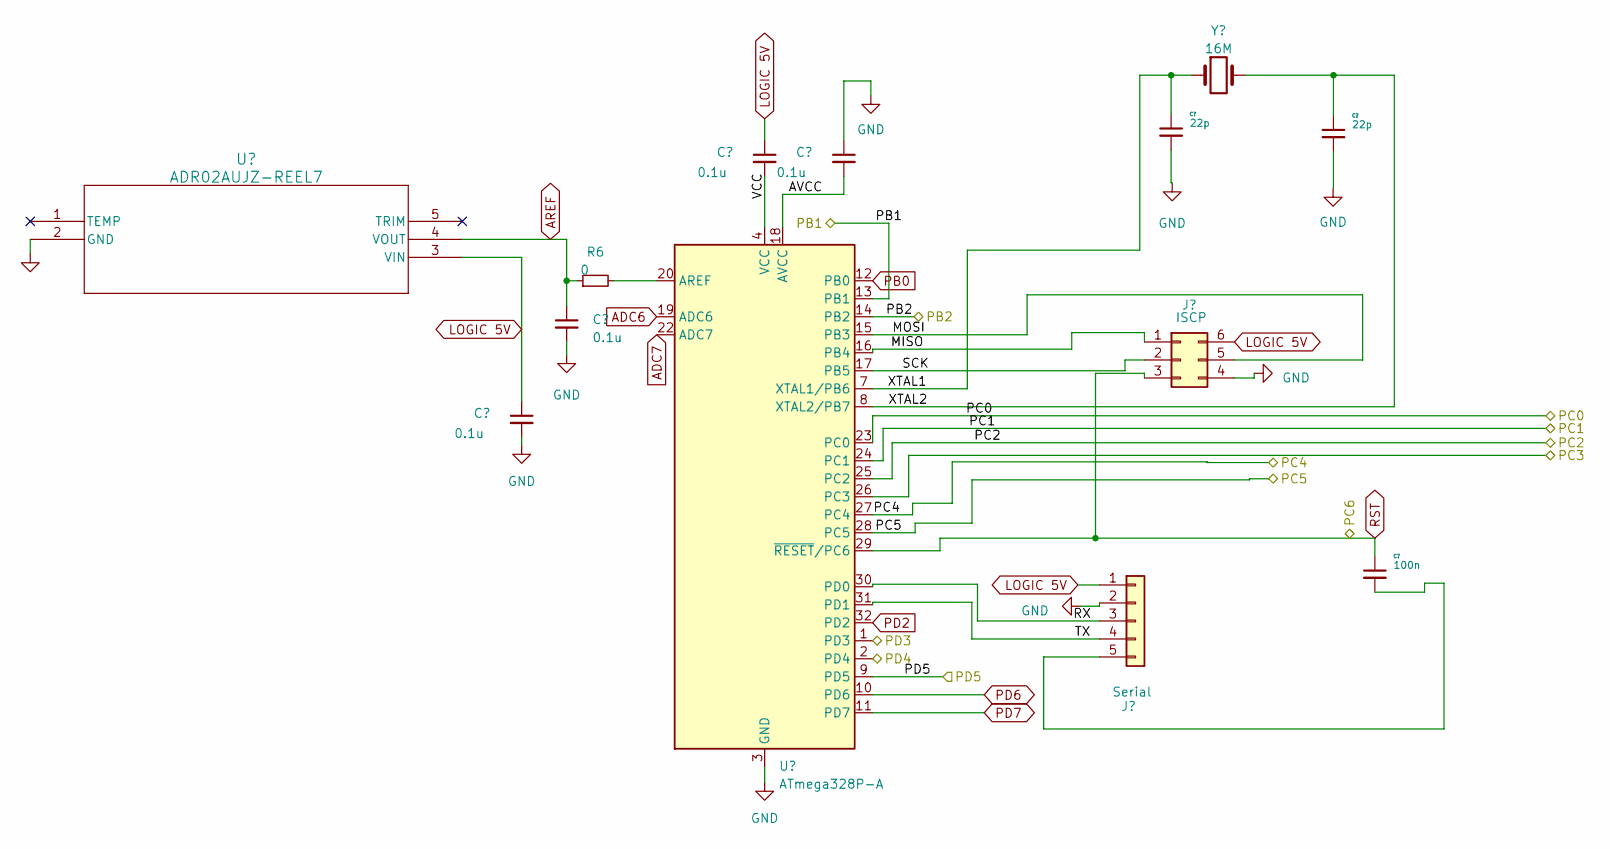
[picture p88: schematic Microcontroller.kicad_sch]

Parts:
C2, C3: 22p; C_0603_1608Metric
C4, C5, C6, C7: 0.1u; C_0603_1608Metric
C8: 100n; C_0603_1608Metric
J11: ISCP; PinHeader_2x03_P2.54mm_Vertical
J12: Serial; PinHeader_1x05_P2.54mm_Horizontal
R6: 0; R_0603_1608Metric
U9: ADR02AUJZ-REEL7; UJ_5_ADI
U10: ATmega328P-A; TQFP-32_7x7mm_P0.8mm
Y1: 16M; Crystal_SMD_HC49-SD

Connections:
/DPIN1: U10.1 (PD3); also elsewhere on the board
/DPIN5: U10.9 (PD5); also elsewhere on the board
/DPIN13: U10.13 (PB1); also elsewhere on the board
/DPIN14: U10.14 (PB2); also elsewhere on the board
/Microcontroller/AVCC: C5.2, U10.18 (AVCC)
/Microcontroller/MISO: J11.1, U10.16 (PB4)
/Microcontroller/MOSI: J11.5, U10.15 (PB3)
/Microcontroller/PC4: U10.27 (PC4); also elsewhere on the board
/Microcontroller/PC5: U10.28 (PC5); also elsewhere on the board
/Microcontroller/RX: J12.3, U10.30 (PD0)
/Microcontroller/SCK: J11.2, U10.17 (PB5)
/Microcontroller/TX: J12.4, U10.31 (PD1)
/Microcontroller/VCC: C4.2, U10.4 (VCC), U10.6 (VCC)
/Microcontroller/XTAL1: C2.1, U10.7 (XTAL1/PB6), Y1.1
/Microcontroller/XTAL2: C3.1, U10.8 (XTAL2/PB7), Y1.2
ADC6: U10.19 (ADC6); also elsewhere on the board
ADC7: U10.22 (ADC7); also elsewhere on the board
AREF: C6.1, R6.1, U9.4 (VOUT); also elsewhere on the board
CURRENT1: U10.25 (PC2); also elsewhere on the board
CURRENT2: U10.26 (PC3); also elsewhere on the board
unnamed: C8.2, J12.5
unnamed: R6.2, U10.20 (AREF)
PB0: U10.12 (PB0); also elsewhere on the board
PD2: U10.32 (PD2); also elsewhere on the board
PD4: U10.2 (PD4); also elsewhere on the board
PD6: U10.10 (PD6); also elsewhere on the board
PD7: U10.11 (PD7); also elsewhere on the board
RST: C8.1, J11.3, U10.29 (~RESET/PC6); also elsewhere on the board
VOLT1: U10.23 (PC0); also elsewhere on the board
VOLT2: U10.24 (PC1); also elsewhere on the board

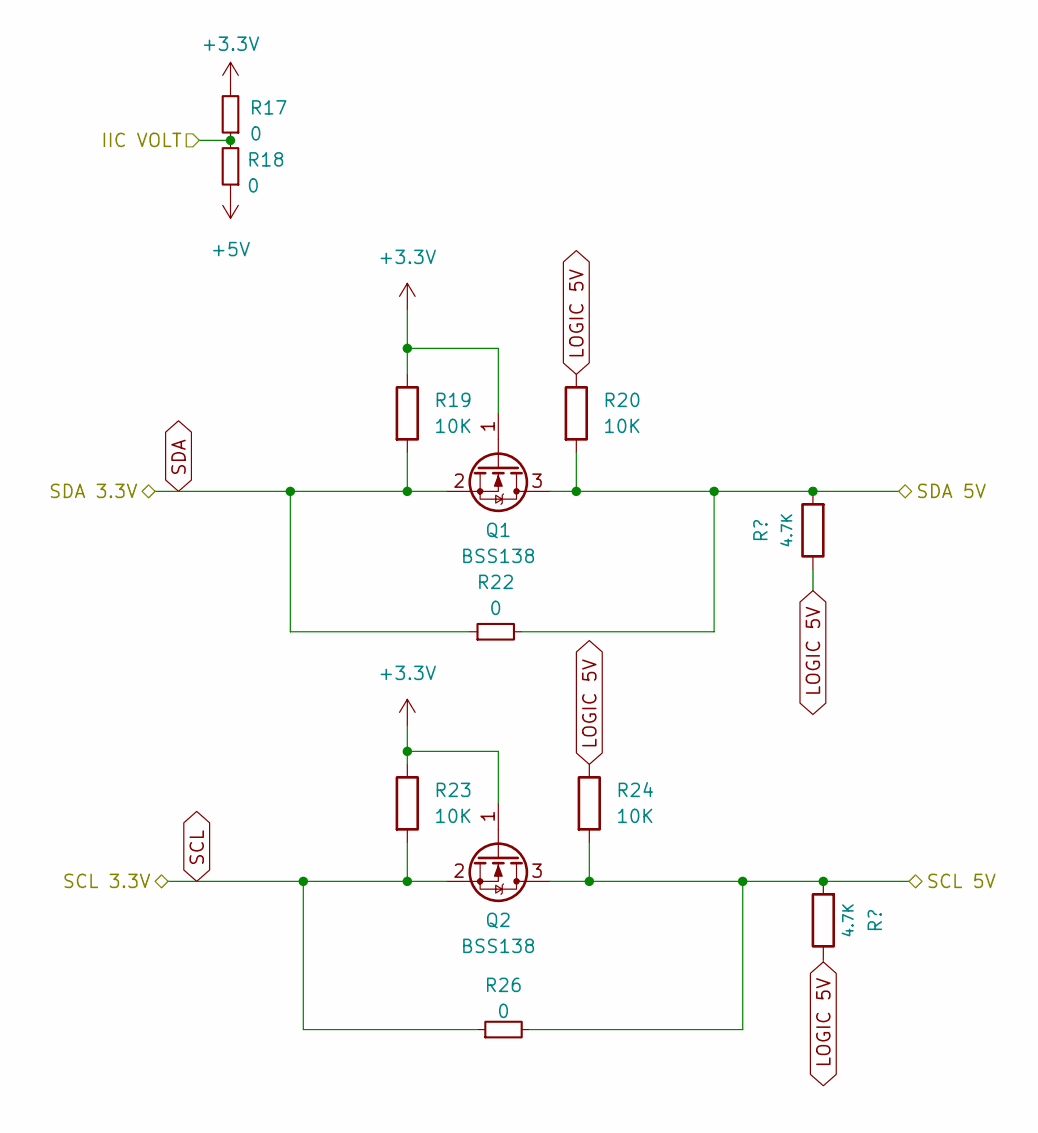
[picture p89: schematic LLC.kicad_sch]

Parts:
Q1, Q2: BSS138; SOT-23
R17, R18, R22, R26: 0; R_0603_1608Metric
R19, R20, R23, R24: 10K; R_0603_1608Metric
R21, R25: 4.7K; R_0603_1608Metric

Connections:
+3.3V: Q1.1 (G), Q2.1 (G), R17.2, R19.1, R23.1; also elsewhere on the board
+5V: R18.1; also elsewhere on the board
/Logic Level Converter/IIC VOLT: R17.1, R18.2; also elsewhere on the board
/Microcontroller/PC4: Q1.3 (D), R20.2, R21.2, R22.2; also elsewhere on the board
/Microcontroller/PC5: Q2.3 (D), R24.2, R25.2, R26.2; also elsewhere on the board
SCL: Q2.2 (S), R23.2, R26.1; also elsewhere on the board
SDA: Q1.2 (S), R19.2, R22.1; also elsewhere on the board

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
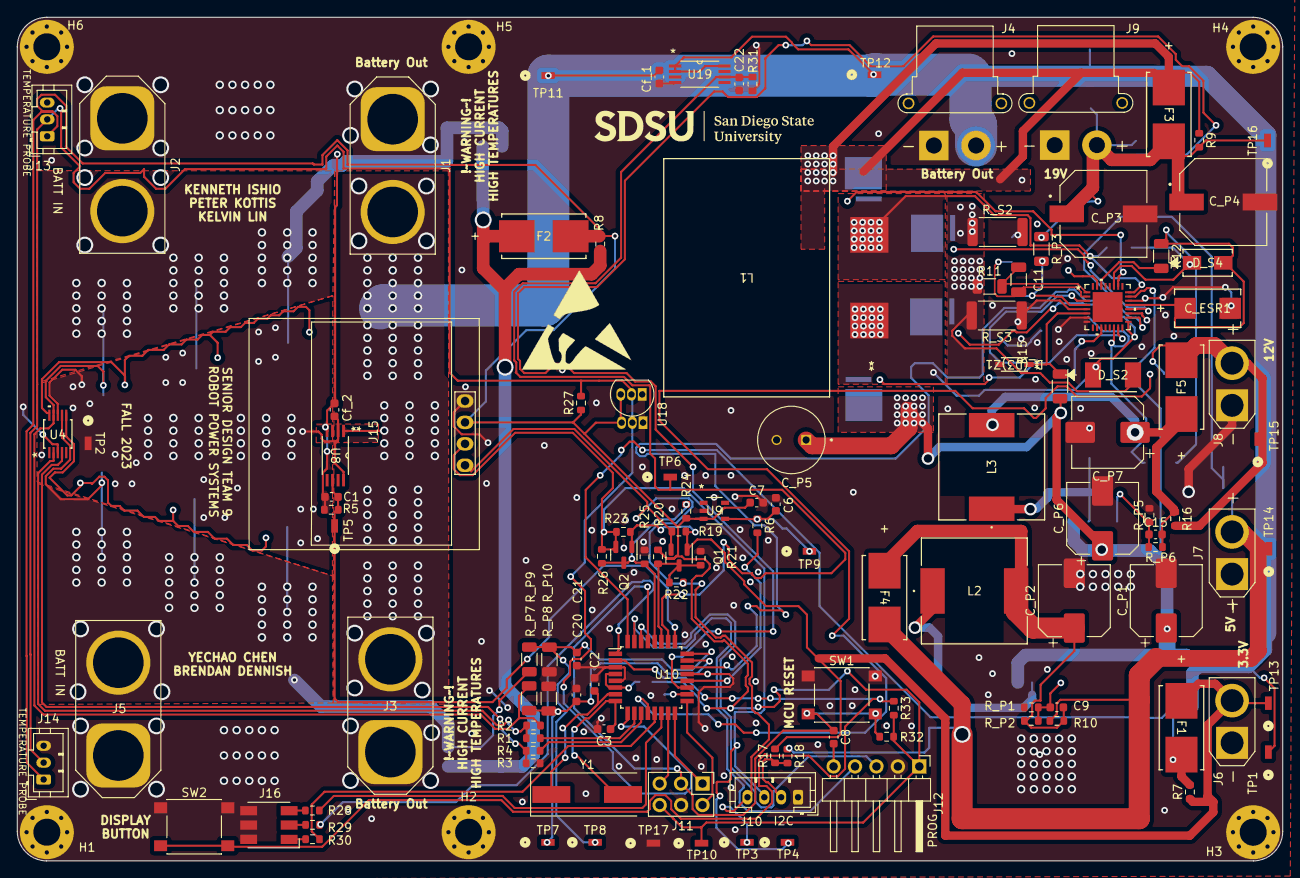
[picture p90: board KiCad/RPS01-Revision 1/rps01.kicad_pcb from above]

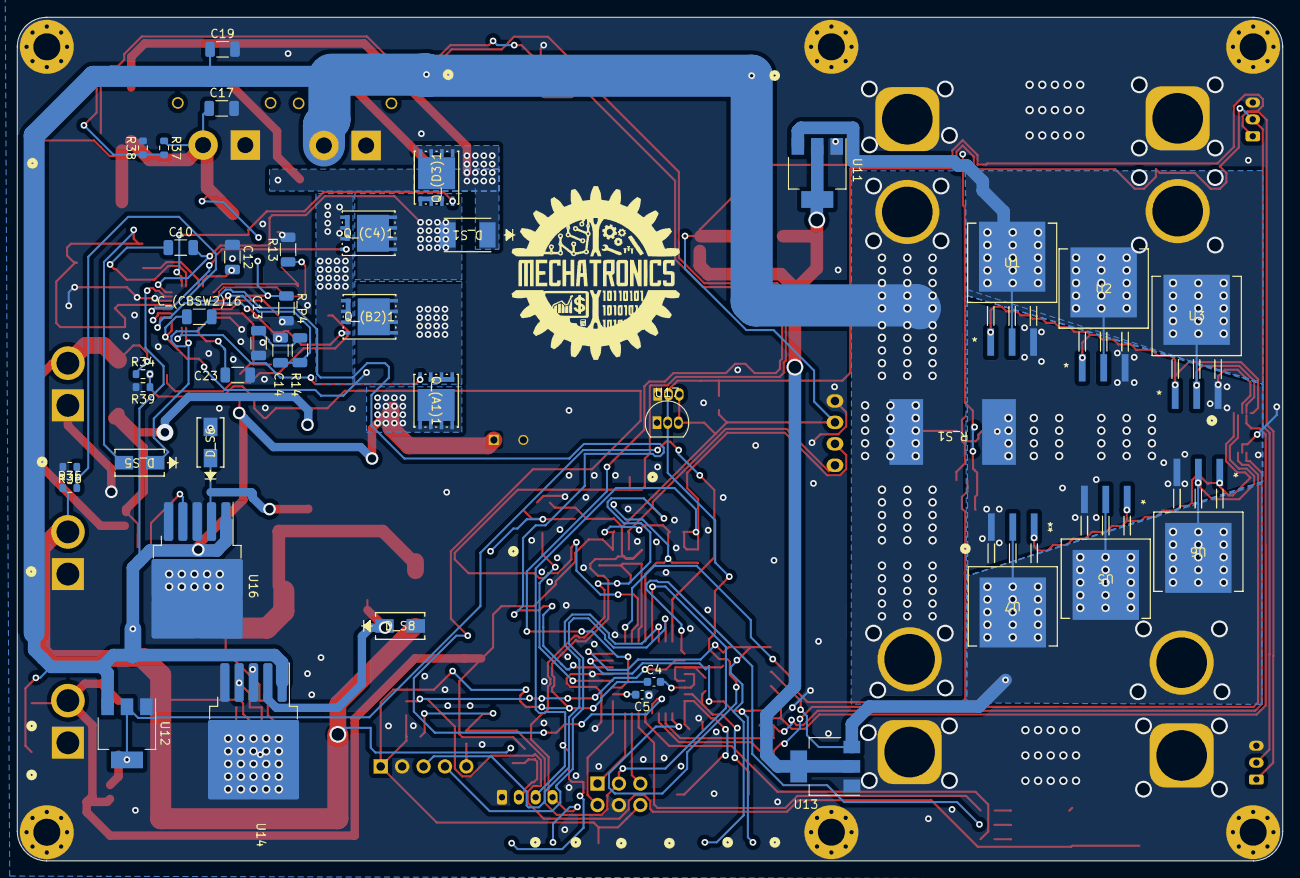
[picture p91: board KiCad/RPS01-Revision 1/rps01.kicad_pcb from below]

Board: 2 copper layers, 150.0 x 100.0 mm, 166 parts (40 on the bottom side), 77 nets.

Other parts of the board:
TP11: VSHUNT2-; CONN1_RCU-0C_TEC
TP12: VSHUNT2+; CONN1_RCU-0C_TEC
