Kenkneeshio/SeniorDesign-Team9/KiCad/RGB_test/RGB/RGB.kicad_pcb

## KiCad design KiCad/RGB_test/RGB/RGB.kicad_pcb (2023-09-15)

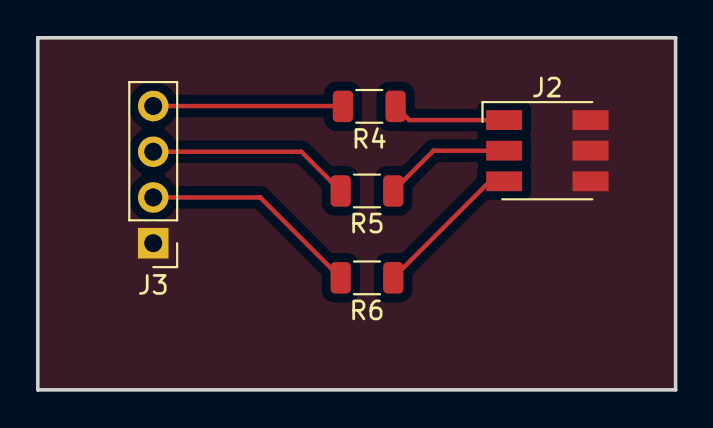
[picture p92: board RGB.kicad_pcb from above]

Board: 2 copper layers, 35.4 x 19.6 mm, 5 parts (0 on the bottom side), 7 nets.

Parts:
J2: RGB LED; LED_RGB_5050-6
J3: Conn_01x04_Pin; PinHeader_1x04_P2.54mm_Vertical
R4: 150 Blue; R_1206_3216Metric
R5: 100 RED; R_1206_3216Metric
R6: 150 Green; R_1206_3216Metric

Connections:
GND: J2.4, J2.5, J2.6, J3.1
unnamed: J2.1, R4.1
unnamed: J2.2, R5.1
unnamed: J2.3, R6.1
unnamed: J3.2, R6.2
unnamed: J3.3, R5.2
unnamed: J3.4, R4.2
