Kenkneeshio/SeniorDesign-Team9/KiCad/Buck Converter (LM2596)/Buck Converter/Buck Converter.kicad_pcb

## KiCad design KiCad/Buck Converter (LM2596)/Buck Converter/Buck Converter.kicad_pcb (2023-09-08)

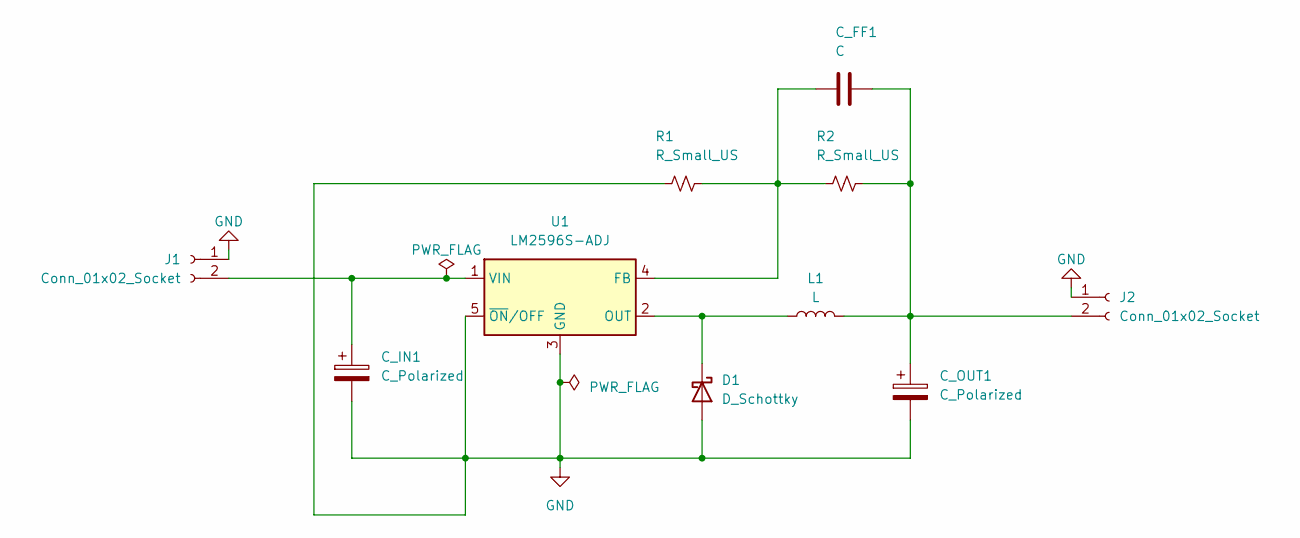
[picture p93: schematic Buck Converter.kicad_sch]

Parts:
C_FF1: C; C_1206_3216Metric
C_IN1: C_Polarized; CP_Elec_8x10
C_OUT1: C_Polarized; CP_Elec_8x10
D1: D_Schottky; CR_SMA_320-340AE_DIO
J1: Conn_01x02_Socket; AMASS_XT60-M_1x02_P7.20mm_Vertical
J2: Conn_01x02_Socket; AMASS_XT60-F_1x02_P7.20mm_Vertical
L1: L; IND_CDRH127_LDNP-470MC_SUM
R1, R2: R_Small_US; R_1206_3216Metric
U1: LM2596S-ADJ; TO-263-5_TabPin3

Connections:
GND: C_IN1.2, C_OUT1.2, D1.2 (A), J1.1, J2.1, R1.1, U1.3 (GND), U1.5 (~ON/OFF)
unnamed: D1.1 (K), L1.1, U1.2 (OUT)
unnamed: C_IN1.1, J1.2, U1.1 (VIN)
unnamed: C_FF1.2, C_OUT1.1, J2.2, L1.2, R2.2
unnamed: C_FF1.1, R1.2, R2.1, U1.4 (FB)

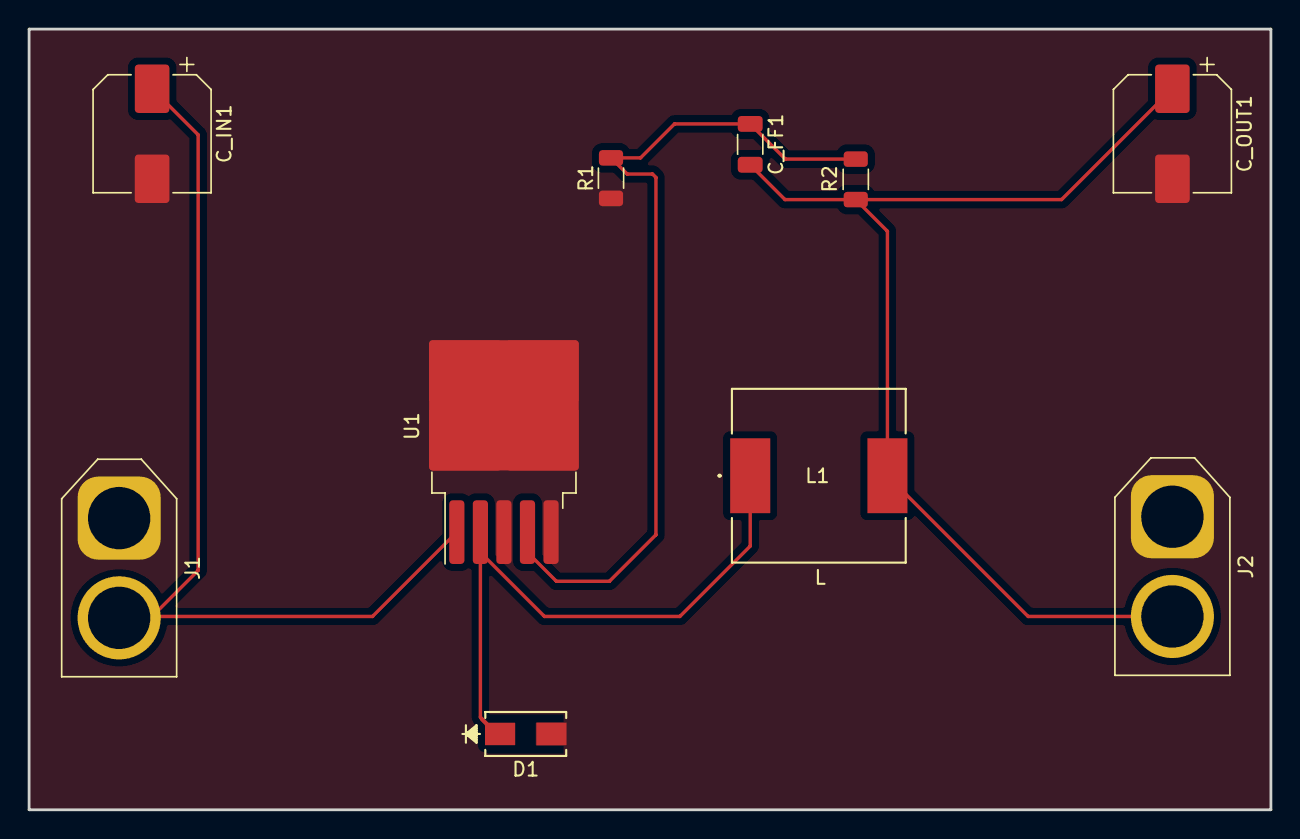
[picture p94: board Buck Converter.kicad_pcb from above]

Board: 2 copper layers, 89.7 x 56.4 mm, 10 parts (0 on the bottom side), 5 nets.
