Kenkneeshio/SeniorDesign-Team9/KiCad/Current Sense Standalone (High Current 50A)/Current Sense Standalone.kicad_pcb

## KiCad design KiCad/Current Sense Standalone (High Current 50A)/Current Sense Standalone.kicad_pcb (2023-09-06)

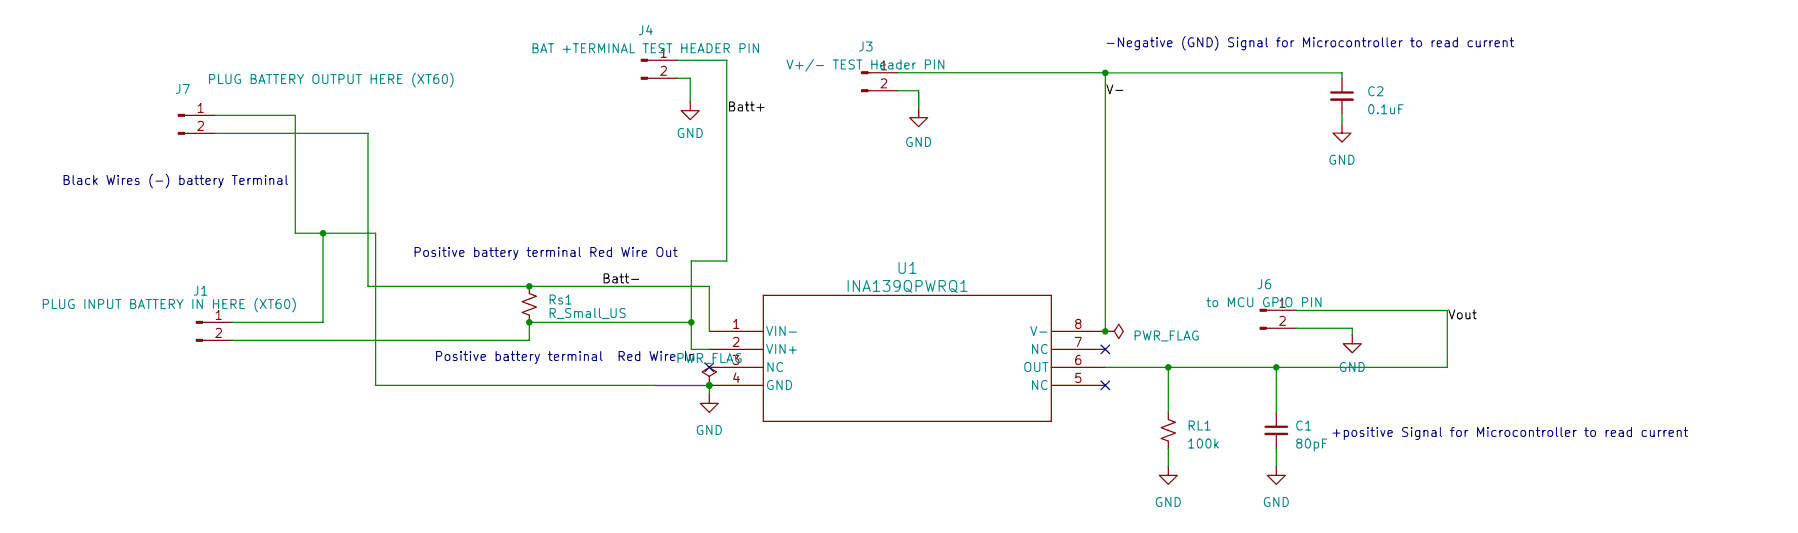
[picture p95: schematic Current Sense Standalone.kicad_sch]

Parts:
C1: 80pF; C_1206_3216Metric
C2: 0.1uF; C_1206_3216Metric
J1: PLUG INPUT BATTERY IN HERE (XT60); AMASS_XT60-M_1x02_P7.20mm_Vertical
J3: V+/- TEST Header PIN; PinHeader_1x02_P2.54mm_Vertical
J4: BAT +TERMINAL TEST HEADER PIN; PinHeader_1x02_P2.54mm_Vertical
J6: to MCU GPIO PIN; PinHeader_1x02_P2.54mm_Vertical
J7: PLUG BATTERY OUTPUT HERE (XT60); AMASS_XT60-F_1x02_P7.20mm_Vertical
RL1: 100k; RESC3216X65
Rs1: R_Small_US; Bourns-CSS2H-3920R-L300F-MFG
U1: INA139QPWRQ1; INA139_PW8

Connections:
/Batt+: J1.2, J4.1, Rs1.2, U1.2 (VIN+)
/Batt-: J7.2, Rs1.1, U1.1 (VIN-)
/V-: C2.1, J3.1, U1.8 (V-)
/Vout: C1.1, J6.1, RL1.1, U1.6 (OUT)
GND: C1.2, C2.2, J1.1, J3.2, J4.2, J6.2, J7.1, RL1.2, U1.4 (GND)

Notes on the sheet:
+positive Signal for Microcontroller to read current
-Negative (GND) Signal for Microcontroller to read current
Positive battery terminal Red Wire In
Black Wires (-) battery Terminal
Positive battery terminal Red Wire Out
