Kenkneeshio/SeniorDesign-Team9/KiCad/Current Sense Standalone (High Current 50A)/Current Sense Standalone.kicad_pcb

## KiCad design KiCad/Current Sense Standalone (High Current 50A)/Current Sense Standalone.kicad_pcb (continued)

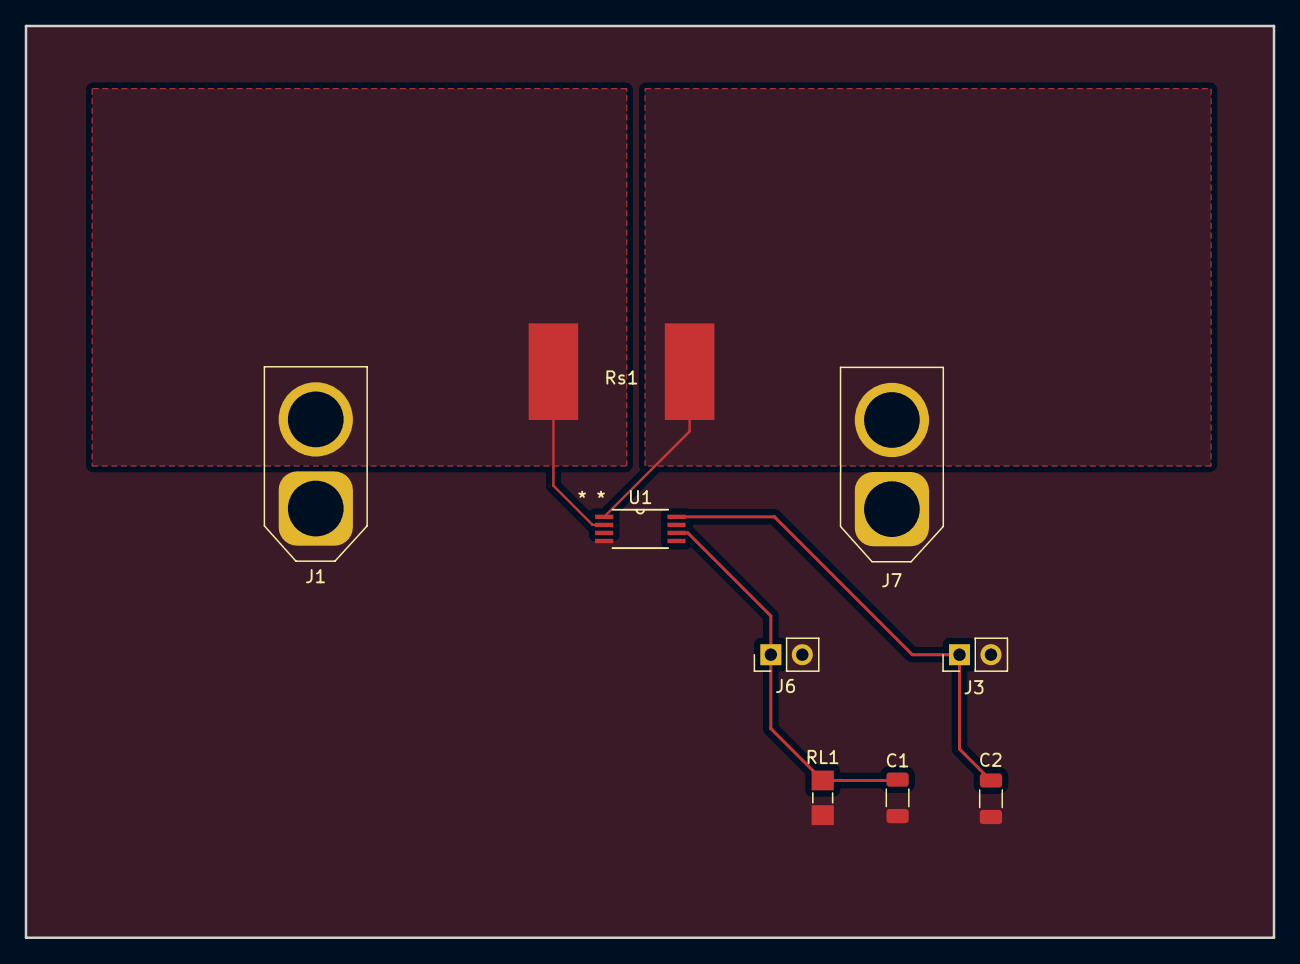
[picture p96: board Current Sense Standalone.kicad_pcb from above]

Board: 2 copper layers, 100.8 x 73.6 mm, 9 parts (0 on the bottom side), 5 nets.
