Kenkneeshio/SeniorDesign-Team9/KiCad/MCU2_SingleSide/mcu_singleside/mcu_singleside.kicad_pcb

## KiCad design KiCad/MCU2_SingleSide/mcu_singleside/mcu_singleside.kicad_pcb (2023-09-02)

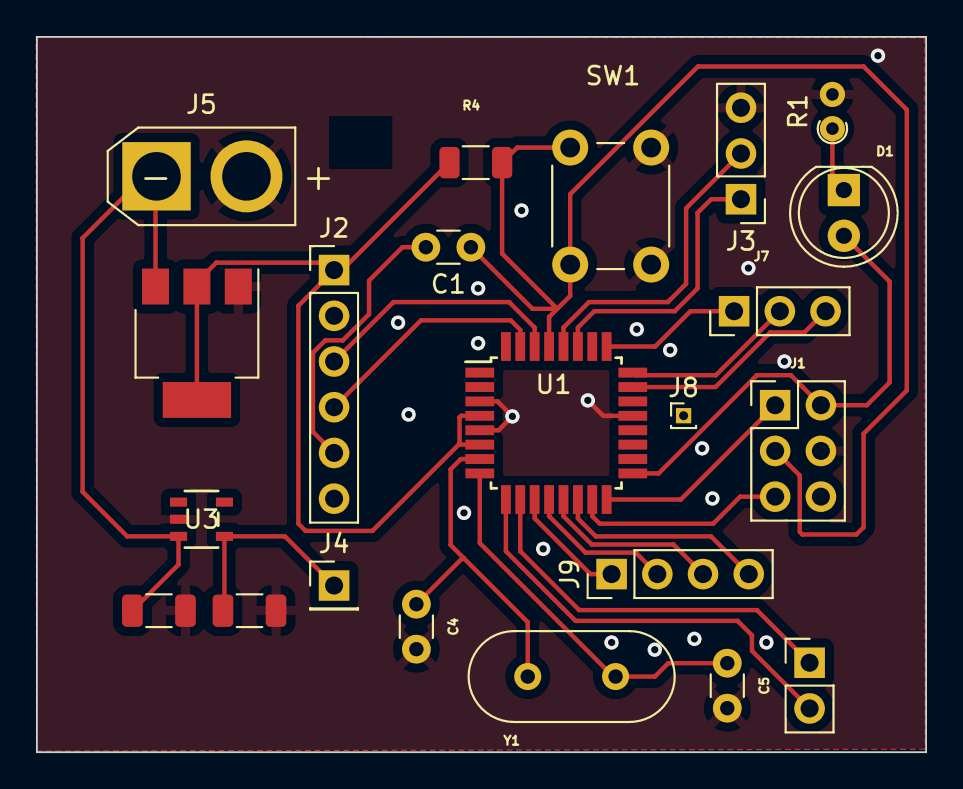
[picture p97: board mcu_singleside.kicad_pcb from above]

Board: 2 copper layers, 49.4 x 39.7 mm, 22 parts (0 on the bottom side), 22 nets.

Parts:
C1: 100nF; C_Disc_D3.0mm_W1.6mm_P2.50mm
C2, C3: 0.1uf; C_1206_3216Metric
C4, C5: 0.22pf; C_Disc_D3.0mm_W1.6mm_P2.50mm
D1: MCU_LED; LED_D5.0mm
J1: Conn_02x03_Counter_Clockwise; PinHeader_2x03_P2.54mm_Vertical
J2: Conn_01x06; PinHeader_1x06_P2.54mm_Vertical
J3, J7: Conn_01x03; PinHeader_1x03_P2.54mm_Vertical
J4: Conn_01x02_Pin; PinHeader_1x01_P2.54mm_Vertical
J5: XT30; AMASS_XT30U-F_1x02_P5.0mm_Vertical
J6: AandDpin; PinHeader_1x02_P2.54mm_Vertical
J8: Conn_01x01_Pin; PinHeader_1x01_P1.00mm_Vertical
J9: Conn_01x04_Pin; PinHeader_1x04_P2.54mm_Vertical
R1: 1k; R_Axial_DIN0204_L3.6mm_D1.6mm_P1.90mm_Vertical
R4: 10K; R_1206_3216Metric
SW1: MCU_Button; SW_PUSH_6mm
U1: ATmega328P-A; TQFP-32_7x7mm_P0.8mm
U2: AMS1117; SOT-223-3_TabPin2
U3: ADR02AUJZ-REEL7; UJ_5_ADI
Y1: Crystal; Crystal_HC49-4H_Vertical

Connections:
+5V: J1.6, J2.1, R4.2, U1.4 (VCC), U1.6 (VCC), U2.2 (VO)
/AREF: J8.1, U1.20 (AREF)
/Analog: J6.1, U1.10 (PD6)
/Digital: J6.2, U1.9 (PD5)
/MISO: J1.1, U1.16 (PB4)
/MOSI: J1.5, U1.15 (PB3)
/RESET: C1.1, J1.3, R4.1, SW1.2 (B), U1.29 (~RESET/PC6)
/RST: C1.2, J2.5
/RX: J2.3, U1.30 (PD0)
/SCK: D1.2 (A), J1.2, U1.17 (PB5)
/SCL: J3.2, U1.28 (PC5)
/SDA: J3.1, U1.27 (PC4)
/TX: J2.4, U1.31 (PD1)
/VI: C2.1, J5.1, U2.3 (VI), U3.3 (VIN)
/VOUT: C3.1, J4.1, U3.4 (VOUT)
GND: C2.2, C3.2, C4.2, C5.2, J1.4, J2.2, J3.3, J5.2, R1.2, SW1.1 (A), U1.3 (GND), U1.5 (GND), U1.21 (GND), U2.1 (ADJ), U3.2 (GND)
unnamed: D1.1 (K), R1.1
unnamed: J7.1, U1.25 (PC2)
unnamed: J7.2, U1.24 (PC1)
unnamed: J7.3, U1.23 (PC0)
unnamed: C4.1, U1.7 (XTAL1/PB6), Y1.1
unnamed: C5.1, U1.8 (XTAL2/PB7), Y1.2
