Kenkneeshio/SeniorDesign-Team9/KiCad/19V 10A Standalone/19V 10A Standalone.kicad_pcb

## KiCad design KiCad/19V 10A Standalone/19V 10A Standalone.kicad_pcb (2023-06-27)

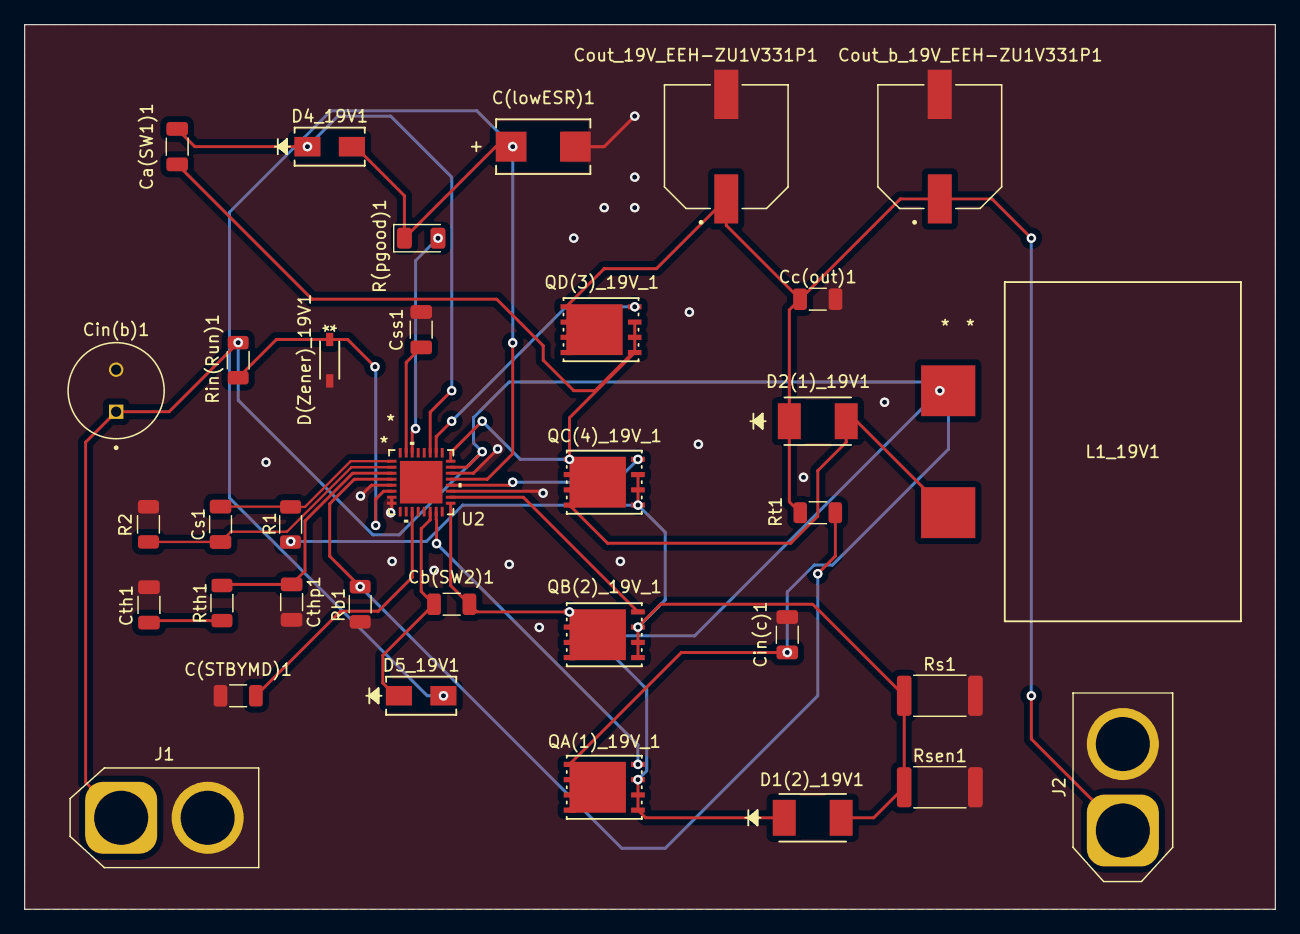
[picture p98: board 19V 10A Standalone.kicad_pcb from above]

Board: 2 copper layers, 104.1 x 73.7 mm, 35 parts (0 on the bottom side), 22 nets.

Parts:
C(STBYMD)1: 0.001u; C_1206_3216Metric
C(lowESR)1: 4.7u; CAPMP7.6X4.3_3.1N_KEM
Ca(SW1)1: 0.22u; C_1206_3216Metric
Cb(SW2)1: 0.22u; C_1206_3216Metric
Cc(out)1: 47u; C_1206_3216Metric
Cin(b)1: 270u; LargeCAPSCAPPRD350W60D800H1200
Cin(c)1: 10u; C_1206_3216Metric
Cout_19V_EEH-ZU1V331P1: 330u; CAP_EEHZU1V331P
Cout_b_19V_EEH-ZU1V331P1: 330u; CAP_EEHZU1V331P
Cs1: 100p; C_1206_3216Metric
Css1: 0.001u; C_1206_3216Metric
Cth1: 10000p; C_1206_3216Metric
Cthp1: 47p; C_1206_3216Metric
D1(2)_19V1, D2(1)_19V1: SD2114S040S8R0; SD2114_AVX
D4_19V1, D5_19V1: D_Schottky_B340AE-13; CR_SMA_320-340AE_DIO
D(Zener)_19V1: D_Zener_BZT52C4V7-13-F; SOD123_DIO
J1: Conn_01x02_Socket; AMASS_XT60-M_1x02_P7.20mm_Vertical
J2: Conn_01x02_Socket; AMASS_XT60-F_1x02_P7.20mm_Vertical
L1_19V1: 6.8u Wurth 74436410680; IND_410680_WRE
QA(1)_19V_1: BSC009NE2LS5IATMA1; PG-TDSON-8_INF_modified_ken
QB(2)_19V_1: BSC009NE2LS5IATMA1; PG-TDSON-8_INF_modified_ken
QC(4)_19V_1: BSC009NE2LS5IATMA1; PG-TDSON-8_INF_modified_ken
QD(3)_19V_1: BSC009NE2LS5IATMA1; PG-TDSON-8_INF_modified_ken
R1, R2: 100; R_1206_3216Metric
R(pgood)1: 100k; LED_1206_3216Metric
Rb1: 4.3K; R_1206_3216Metric
Rin(Run)1: 51K; R_1206_3216Metric
Rs1: 6m; R_2512_6332Metric
Rsen1: 6m; R_2512_6332Metric
Rt1: 100K; R_1206_3216Metric
Rth1: 124K; R_1206_3216Metric
U2: LTC3780EUH-TRPBF; QFN-32_UH_LIT

Connections:
/BG1: QC(4)_19V_1.4, U2.20 (BG1)
/BG2: QB(2)_19V_1.4, U2.18 (BG2)
/BOOST1: Ca(SW1)1.1, D4_19V1.1 (K), U2.27 (BOOST1)
/BOOST2: Cb(SW2)1.2, D5_19V1.1 (K), U2.14 (BOOST2)
/INTVCC: C(lowESR)1.1, D4_19V1.2 (A), D5_19V1.2 (A), R(pgood)1.1, U2.21 (INTVCC)
/ITH: Cthp1.1, Rth1.2, U2.3 (ITH)
/PGOOD: R(pgood)1.2, U2.30 (PGOOD)
/Rsense: D1(2)_19V1.2, QB(2)_19V_1.1, QB(2)_19V_1.2, QB(2)_19V_1.3, QC(4)_19V_1.1, QC(4)_19V_1.2, QC(4)_19V_1.3, R1.1, Rs1.1, Rsen1.1
/Run: D(Zener)_19V1.1 (K), Rin(Run)1.2, U2.6 (RUN)
/SENSE+: Cs1.2, R1.2, U2.1 (SENSE+)
/SENSE-: Cs1.1, R2.1, U2.2 (SENSE-)
/SS: Css1.2, U2.31 (SS)
/STBYMD: C(STBYMD)1.1, U2.11 (STBYMD)
/SW1: Ca(SW1)1.2, D2(1)_19V1.2, L1_19V1.2, QC(4)_19V_1.5, QC(4)_19V_1.6, QC(4)_19V_1.7, QC(4)_19V_1.8, QD(3)_19V_1.1, QD(3)_19V_1.2, QD(3)_19V_1.3, U2.24 (SW1)
/SW2: Cb(SW2)1.1, D1(2)_19V1.1, L1_19V1.1, QA(1)_19V_1.1, QA(1)_19V_1.2, QA(1)_19V_1.3, QB(2)_19V_1.5, QB(2)_19V_1.6, QB(2)_19V_1.7, QB(2)_19V_1.8, U2.17 (SW2)
/TG1: QD(3)_19V_1.4, U2.26 (TG1)
/TG2: QA(1)_19V_1.4, U2.15 (TG2)
/VOSENSE: Rb1.1, Rt1.2, U2.4 (VOSENSE)
/Vin: Cin(b)1.1, Cin(c)1.1, J1.1, QA(1)_19V_1.5, QA(1)_19V_1.6, QA(1)_19V_1.7, QA(1)_19V_1.8, Rin(Run)1.1, U2.23 (VIN)
/Vout: Cc(out)1.1, Cout_19V_EEH-ZU1V331P1.1, Cout_b_19V_EEH-ZU1V331P1.1, D2(1)_19V1.1, J2.1, QD(3)_19V_1.5, QD(3)_19V_1.6, QD(3)_19V_1.7, QD(3)_19V_1.8, Rt1.1
GND: C(STBYMD)1.2, C(lowESR)1.2, Cc(out)1.2, Cin(b)1.2, Cin(c)1.2, Cout_19V_EEH-ZU1V331P1.2, Cout_b_19V_EEH-ZU1V331P1.2, Css1.1, Cth1.2, Cthp1.2, D(Zener)_19V1.2 (A), J1.2, J2.2, R2.2, Rb1.2, Rs1.2, Rsen1.2, U2.5 (SGND), U2.7 (FCB), U2.8 (PLLFLTR), U2.19 (PGND), U2.22 (EXTVCC)
unnamed: Cth1.1, Rth1.1
