Kenkneeshio/SeniorDesign-Team9/KiCad/MCU1/M_MUC.kicad_pcb

## KiCad design KiCad/MCU1/M_MUC.kicad_pcb (2023-05-12)

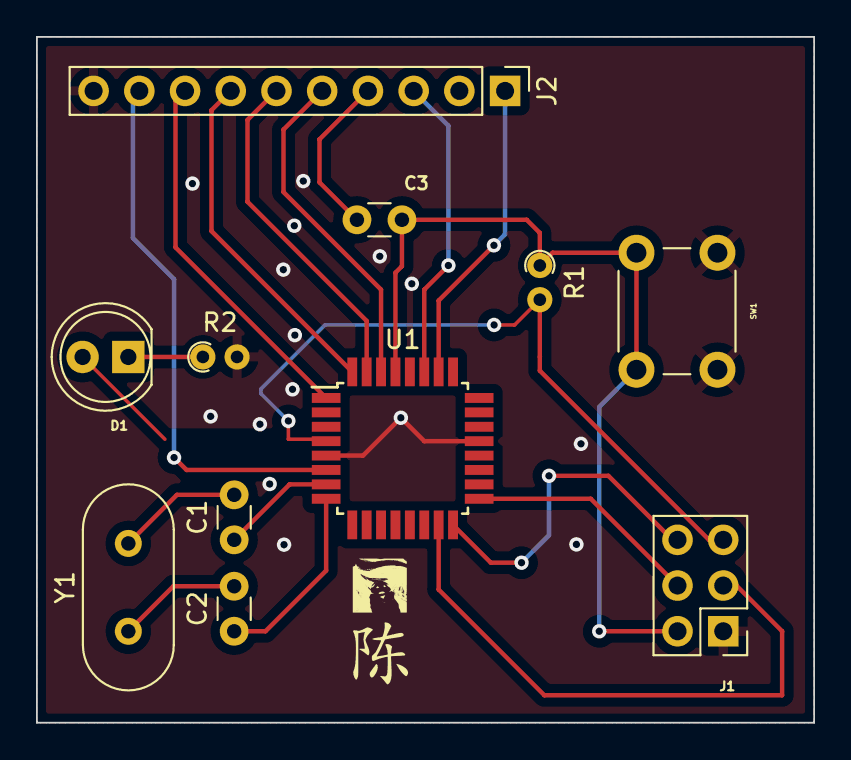
[picture p99: board M_MUC.kicad_pcb from above]

Board: 2 copper layers, 43.2 x 38.1 mm, 11 parts (0 on the bottom side), 19 nets.

Parts:
C1, C2: 22pF; C_Disc_D3.0mm_W1.6mm_P2.50mm
C3: 100nF; C_Disc_D3.0mm_W1.6mm_P2.50mm
D1: LED; LED_D5.0mm
J1: 6pin; PinHeader_2x03_P2.54mm_Vertical
J2: Conn_01x10; PinHeader_1x10_P2.54mm_Vertical
R1: 10K; R_Axial_DIN0204_L3.6mm_D1.6mm_P1.90mm_Vertical
R2: 1k; R_Axial_DIN0204_L3.6mm_D1.6mm_P1.90mm_Vertical
SW1: SW_Push_Open; SW_PUSH_6mm
U1: ATmega328PB-A; TQFP-32_7x7mm_P0.8mm
Y1: Crystal; Crystal_HC49-4H_Vertical

Connections:
5V: J1.5, R1.2, U1.4 (VCC)
/rst: C3.2, J2.4
/rx: J2.5, U1.30 (PD0)
/tx: J2.6, U1.31 (PD1)
GND: J1.1, J2.10, R2.2, SW1.1 (A), U1.5 (GND), U1.21 (GND)
MISO: J1.6, U1.16 (PB4)
MOSI: J1.3, U1.15 (PB3)
unnamed: C1.2, Y1.2
unnamed: C2.2, Y1.1
unnamed: D1.1 (K), R2.1
unnamed: J2.1, U1.26 (PC3)
unnamed: J2.3, U1.27 (PC4)
unnamed: J2.7, U1.32 (PD2)
unnamed: J2.8, U1.1 (PD3)
unnamed: J2.9, U1.6 (PE1)
unnamed: C1.1, U1.7 (XTAL1/PB6)
unnamed: C2.1, U1.8 (XTAL2/PB7)
RST: C3.1, J1.2, R1.1, SW1.2 (B), U1.29 (~RESET/PC6)
SCK: J1.4, U1.17 (PB5)
