Kenkneeshio/SeniorDesign-Team9/KiCad/Current Test Bench - Ken/Current Test Bench.kicad_pcb

## KiCad design KiCad/Current Test Bench - Ken/Current Test Bench.kicad_pcb (2023-03-11)

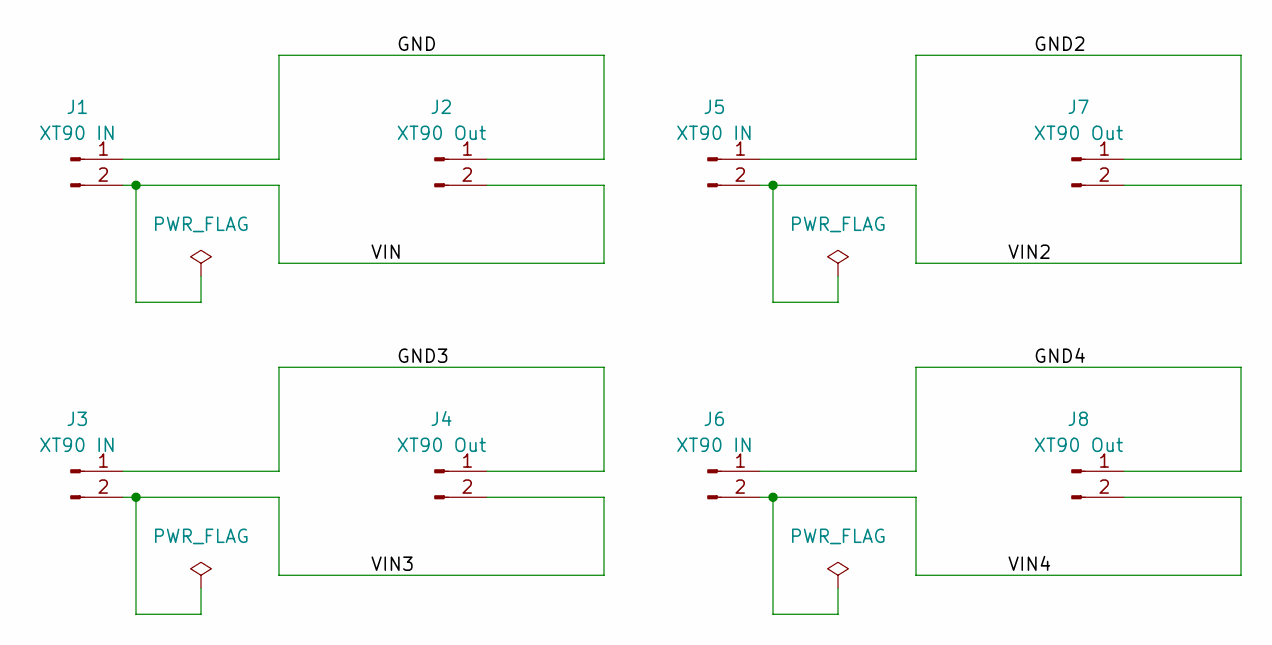
[picture p100: schematic Current Test Bench.kicad_sch]

Parts:
J1, J3, J5, J6: XT90 IN; AMASS_XT90-M_1x02_P11.00mm_Vertical
J2, J4, J7, J8: XT90 Out; AMASS_XT90-M_1x02_P11.00mm_Vertical

Connections:
/GND: J1.1, J2.1
/GND2: J5.1, J7.1
/GND3: J3.1, J4.1
/GND4: J6.1, J8.1
/VIN: J1.2, J2.2
/VIN2: J5.2, J7.2
/VIN3: J3.2, J4.2
/VIN4: J6.2, J8.2

Board: 2 copper layers, 8 parts (0 on the bottom side), 8 nets, no tracks yet.
