Kenkneeshio/SeniorDesign-Team9/Code/3Temp_test/3Temp_test.ino

#include <OneWire.h>
#include <DallasTemperature.h>

// change the pin when you use jason's board
#define ONE_WIRE_BUS 5
//#define temp1 28EE0A81E3373CB2
// Setup a oneWire instance to communicate with any OneWire devices (not just Maxim/Dallas temperature ICs)
OneWire oneWire(ONE_WIRE_BUS);

// Pass our oneWire reference to Dallas Temperature. 
DallasTemperature sensors(&oneWire);

int numberOfDevices; // Number of temperature devices found

DeviceAddress tempDeviceAddress; // We'll use this variable to store a found device address

DeviceAddress deviceAddresses;
void setup(void) {

  //deviceAddresses[0] = 0x28EE0A81E3373CB2;
  // start serial port
  Serial.begin(9600);
  
  // Start up the library
  sensors.begin();
  
  // Grab a count of devices on the wire
  numberOfDevices = sensors.getDeviceCount();
  
  // locate devices on the bus
  Serial.print("Locating devices...");
  Serial.print("Found ");
  Serial.print(numberOfDevices, DEC);
  Serial.println(" devices.");

  // Loop through each device, print out address
  // for(int i=0;i<numberOfDevices; i++) {
  //   // Search the wire for address
  //   if(sensors.getAddress(tempDeviceAddress, i)) {
  //     Serial.print("Found device ");
  //     Serial.print(i, DEC);
  //     Serial.print(" with address: ");
  //     printAddress(tempDeviceAddress);
  //     Serial.println();
	// 	} else {
	// 	  Serial.print("Found ghost device at ");
	// 	  Serial.print(i, DEC);
	// 	  Serial.print(" but could not detect address. Check power and cabling");
	// 	}
  // }
}

void loop(void) { 
  sensors.requestTemperatures(); // Send the command to get temperatures
  
  // Loop through each device, print out temperature data
  for(int i=0;i<numberOfDevices; i++) {
     // Search the wire for address
     if(sensors.getAddress(tempDeviceAddress, i)){
		
	 	// Output the device ID
	 	Serial.print("Temperature for device: ");
	 	Serial.println(i,DEC);

     // Print the data
     float tempC = sensors.getTempC(tempDeviceAddress);
     Serial.print("Temp C: ");
     Serial.print(tempC);
     Serial.print(" Temp F: ");
     Serial.println(DallasTemperature::toFahrenheit(tempC)); // Converts tempC to Fahrenheit
     } 	
   }

//  float tempC = sensors.getTempC(deviceAddresses);
//    Serial.print("Temp C: ");
//    Serial.print(tempC);
//    Serial.print(" Temp F: ");
//    Serial.println(DallasTemperature::toFahrenheit(tempC)); // Converts tempC to Fahrenheit
  delay(5000);
}

// function to print a device address
void printAddress(DeviceAddress deviceAddress) {
  for (uint8_t i = 0; i < 8; i++) {
    if (deviceAddress[i] < 16) Serial.print("0");
      Serial.print(deviceAddress[i], HEX);
  }
}
