Kenkneeshio/SeniorDesign-Team9/Code/slave_test.ino

2#include <OneWire.h>
#include <DallasTemperature.h>
#include <Wire.h>



// Data wire is conntec to the Arduino digital pin 4
#define ONE_WIRE_BUS 4

// Setup a oneWire instance to communicate with any OneWire devices
OneWire oneWire(ONE_WIRE_BUS);

// Pass our oneWire reference to Dallas Temperature sensor 
DallasTemperature sensors(&oneWire);

void setup(void)
{
  // Start serial communication for debugging purposes
  Serial.begin(9600);
  // Start up the library
  sensors.begin();
   Wire.begin(8);                // join i2c bus with address #8
  Wire.onRequest(requestEvent); // register event
}

void loop(void){ 
  // Call sensors.requestTemperatures() to issue a global temperature and Requests to all devices on the bus
  sensors.requestTemperatures(); 
  
  Serial.print("Celsius temperature: ");
  // Why "byIndex"? You can have more than one IC on the same bus. 0 refers to the first IC on the wire
  Serial.print(sensors.getTempCByIndex(0)); 
  Serial.print(" - Fahrenheit temperature: ");
  Serial.println(sensors.getTempFByIndex(0));
  delay(1000);
}

volatile byte* input;

void requestEvent() {
  byte* data;
  float ken= sensors.getTempCByIndex(0);
  //Wire.write((byte)ken); // respond with message of 6 bytes
  input = (byte*) &ken;
  data[0] = input[0];
  data[1] = input[1];
  data[2] = input[2];
  data[3] = input[3];
  Wire.write(data[0]);
  Wire.write(data[1]);
  Wire.write(data[2]);
  Wire.write(data[3]);
}
