Kenkneeshio/SeniorDesign-Team9/(commit log)

2023-03-11 Uploading Ken's Stuff
    Uploading Ken's Stuff
    [Current Test Bench-B_Cu.gbl, Current Test Bench-B_Mask.gbs, Current Test Bench-B_Paste.gbp, Current Test Bench-B_Silkscreen.gbo, Current Test Bench-Edge_Cuts.gm1, Current Test Bench-F_Cu.gtl, Current Test Bench-F_Mask.gts, Current Test Bench-F_Paste.gtp]
2023-03-28 prototype/kicad/temperature files
    [Linear_Technology_-_LTC4416IMS-1.step, rps01.kicad_pcb, rps01.kicad_sch]
2023-03-28 Peter Updated rps01 kicad Project
    Peter Updated rps01 kicad Project
    [rps01.kicad_sch]
2023-03-29 Updated PCB Project
    Changed Fonts
    [rps01.kicad_sch]
2023-03-29 Footprints and Folders
    Updated Main KiCad PCB
    Added Footprint Files
    Updated Folders
    [Current Test Bench-B_Cu.gbl, Current Test Bench-B_Mask.gbs, Current Test Bench-B_Paste.gbp, Current Test Bench-B_Silkscreen.gbo, Current Test Bench-Edge_Cuts.gm1, Current Test Bench-F_Cu.gtl, Current Test Bench-F_Mask.gts, Current Test Bench-F_Paste.gtp]
2023-03-31 Updated PCB Outline
    [rps01.kicad_pcb, rps01.kicad_sch]
2023-04-03 Updated The Schematic Hierarvhy
    Added each sub system to separate pages
    [12V_Buck_Boost.kicad_sch, 19V_Boost.kicad_sch, 5V_Buck.kicad_sch, Current_Sense.kicad_sch, Load_Sharing.kicad_sch, Microcontroller.kicad_sch, rps01.kicad_sch]
2023-04-03 Created separated files and added datasheets
    Created separated files and added datasheets.
    Use the hierachy
    [12V_Buck_Boost.kicad_sch, 19V_Boost.kicad_sch, 5V_Buck.kicad_sch, Current_Sense.kicad_sch, Load_Sharing.kicad_sch, Microcontroller.kicad_sch, rps01.kicad_sch]
2023-04-03 Added reference Images to sheets
    Added reference Images to sheets
    [12V_Buck_Boost.kicad_sch, 19V_Boost.kicad_sch, 5V_Buck.kicad_sch, Current_Sense.kicad_sch, Load_Sharing.kicad_sch, Microcontroller.kicad_sch]
2023-04-03 Updated Red Photos
    Added Simulation of Load Sharing Circuit
    [12V_Buck_Boost.kicad_sch, 19V_Boost.kicad_sch, 5V_Buck.kicad_sch, Current_Sense.kicad_sch, Load_Sharing.kicad_sch, Microcontroller.kicad_sch]
2023-04-03 Updated Layout
    [Load_Sharing.kicad_sch, rps01.kicad_sch]
2023-04-03 Worked on 19V PSU
    Worked on 19V PSU
    [rps01.kicad_sch]
2023-04-03 Worked on 19v power
    [19V_Boost.kicad_sch]
2023-04-03 Updated LTspice 19v PSU
2023-04-04 Continued work on 19V PSU
2023-04-04 Saving Work
    Completed KiCad Schematic and LTSpice Simulation for 19V PSU
    [rps01.kicad_sch]
2023-04-04 Completed 19V Footprints
2023-04-04 started on the PCB
    [rps01.kicad_pcb, rps01.kicad_sch]
2023-04-06 board pics + LTC4416 datasheet
2023-04-06 MCU_KiCad
    PCB for Atmega328PB
    [M_MUC-B_Cu.gbl, M_MUC-B_Mask.gbs, M_MUC-B_Paste.gbp, M_MUC-B_Silkscreen.gbo, M_MUC-Edge_Cuts.gm1, M_MUC-F_Cu.gtl, M_MUC-F_Mask.gts, M_MUC-F_Paste.gtp]
2023-04-06 saving my stuff
    [Load_Sharing.kicad_sch, rps01.kicad_sch]
2023-04-06 current sense
    [Current_Sense.kicad_sch, rps01.kicad_sch]
2023-04-06 saving files
    [Load_Sharing.kicad_sch]
2023-04-06 Saving Files
    I dont see Kelvins Schematic?
    [Load_Sharing.kicad_sch, rps01.kicad_sch]
2023-04-06 saving work
    [Load_Sharing.kicad_sch, rps01.kicad_sch]
2023-04-06 Saving Work for the Night
    Finished Load Sharing PCB
    [rps01-B_Cu.gbl, rps01-B_Mask.gbs, rps01-B_Paste.gbp, rps01-B_Silkscreen.gbo, rps01-Edge_Cuts.gm1, rps01-F_Cu.gtl, rps01-F_Mask.gts, rps01-F_Paste.gtp]
2023-04-06 update
    update
    [M_MUC-B_Cu.gbl, M_MUC-B_Mask.gbs, M_MUC-B_Paste.gbp, M_MUC-B_Silkscreen.gbo, M_MUC-Edge_Cuts.gm1, M_MUC-F_Cu.gtl, M_MUC-F_Mask.gts, M_MUC-F_Paste.gtp]
2023-04-06 updated kicad version
    [M_MUC.kicad_pcb, M_MUC.kicad_sch]
2023-04-16 3D Model
    [rps01.blend]
2023-04-16 Create Robot Power System WBS V2-ectype.vmind
2023-04-16 Update Robot Power System WBS V2-ectype.vmind
2023-05-06 Updating to start BUCKBOOST
2023-05-12 Add MCU to the root Kicad
    [Microcontroller.kicad_sch, rps01.kicad_pcb, rps01.kicad_sch]
2023-05-12 Fixed 5V reg footprint
    [rps01.kicad_pcb, rps01.kicad_sch]
2023-05-12 Add Note for +5V label on 5V Buck
    [Current_Sense.kicad_sch, Load_Sharing.kicad_sch, Microcontroller.kicad_sch, rps01.kicad_sch]
2023-05-12 5V Buck Schematic and Some Components
    [5V_Buck.kicad_sch, rps01.kicad_pcb]
2023-05-12 Root cleanup and new regulator
    [Current_Sense.kicad_sch, rps01.kicad_sch]
2023-05-12 Net listed and attacked outline components
    [rps01.kicad_pcb, rps01.kicad_sch]
2023-05-12 Changed footprints on my end only
    [12V_Buck_Boost.kicad_sch, 5V_Buck.kicad_sch, Current_Sense.kicad_sch, Load_Sharing.kicad_sch, rps01.kicad_pcb, rps01.kicad_sch]
2023-05-12 update for layout before 1 H break
    [rps01.kicad_pcb, rps01.kicad_sch]
2023-05-13 Layout Updates
    [rps01.kicad_pcb, rps01.kicad_sch]
2023-05-13 VIA FUN
    [rps01.kicad_pcb]
2023-05-13 Load Sharing Traces
    [rps01.kicad_pcb]
2023-05-13 Fixed Footprint/Symbol Paths and 19V Boost Footprint
    [rps01.blend]
2023-05-13 so many updates
    [rps01.kicad_pcb]
2023-05-13 All Footprints Load from Mechatronics Folder
    [12V_Buck_Boost.kicad_sch, 5V_Buck.kicad_sch, Current_Sense.kicad_sch, Load_Sharing.kicad_sch, rps01.kicad_sch]
2023-05-13 My Load Sharing Group
    [rps01.kicad_pcb]
2023-05-13 Progress saving on Load Sharing
    [rps01.kicad_pcb, rps01.kicad_sch]
2023-05-13 LTPowerCad files with BSC009NE2LS5I on all mosfets
    BSC009NE2LS5I
    [5V_Buck.kicad_sch]
2023-05-14 Completed Load Sharing Circuit PCB
    [rps01.kicad_pcb]
2023-05-14 Deleted 12 and 5 V. 19V updated
    [12V_Buck_Boost.kicad_sch, 5V_Buck.kicad_sch, rps01.kicad_pcb]
2023-05-14 Corrceted 19V components
    [rps01.kicad_pcb]
2023-05-14 Fully Updated 19V SCh
    [rps01.kicad_pcb]
2023-05-14 Added Voltmeter
    [Microcontroller.kicad_sch, rps01.kicad_pcb, rps01.kicad_sch]
2023-05-14 Major Changes
    [Current_Sense.kicad_sch, rps01.kicad_pcb]
2023-05-14 Repaired root grid
    [rps01.kicad_sch]
2023-05-14 Repaired Grid root
    [rps01.kicad_sch]
2023-05-14 fixed SW1
    [rps01.kicad_pcb]
2023-05-14 Updated Footprint
    [rps01.kicad_pcb, rps01.kicad_sch]
2023-05-14 updated footprints
2023-05-14 Added ground planes to 19V
    [rps01.kicad_pcb]
2023-05-14 Changed the Diodes
    [rps01.kicad_pcb]
2023-05-14 19V Update
    [Current_Sense.kicad_sch, rps01.kicad_pcb]
2023-05-14 Completed 19V
    [rps01.kicad_pcb]
2023-05-14 Revisions before sleep
    [rps01.kicad_pcb]
2023-05-14 Microcontroller Traces
    [rps01.kicad_pcb]
2023-05-14 mcu ground plane
    [rps01.kicad_pcb]
2023-05-15 Deleted Current Sense Circuit to remove errors and started 5V system
    [5V_Buck.kicad_sch, Current_Sense.kicad_sch, rps01.kicad_pcb]
2023-05-15 Removed all Electrical Errors from PCB File...Moving on to add 5V System
    [5V_Buck.kicad_sch, rps01.kicad_pcb]
2023-05-15 Cesr footprint
2023-05-15 Corrected all footprint errors and PCB electrical errors......NOW onto the 5V
    [rps01.kicad_pcb, rps01.kicad_sch]
2023-05-15 Added prototype 12V and 5V boards
    [12V_Buck_Boost.kicad_sch, 5V_Buck.kicad_sch, rps01.kicad_pcb]
2023-05-15 Updated the Footprints
2023-05-15 WIRE X
    [Microcontroller.kicad_sch]
2023-05-15 Fixing 5V Problems
    [12V_Buck_Boost.kicad_sch, 5V_Buck.kicad_sch]
2023-05-15 5V updates
    [5V_Buck.kicad_sch, rps01.kicad_pcb]
2023-05-15 Added repaired 12 and 5v
    [12V_Buck_Boost.kicad_sch, 5V_Buck.kicad_sch, Microcontroller.kicad_sch]
2023-05-15 Fixed a bunch of unconnected connections on all the sheets Schematics
    [12V_Buck_Boost.kicad_sch, 5V_Buck.kicad_sch]
2023-05-15 Placed the components. Only thing left is to Connect all the connections of the 12 and 5v bucks
2023-05-15 Completed V0 of the PCB....except the zener diodes need to change due to stock
2023-05-15 Completed First Prototype!!!!!!!
2023-06-13 EEHZU1V331P 330uF NMOS
    Added the schematic and footprint for the correct 330uF Cap
2023-06-14 328pb to 328p
    [Microcontroller.kicad_sch]
2023-06-14 19V 10A Boost Converter
    This should be the new PCB for the updated IC since the OG one is out of stock.
    [19V 10A Standalone.kicad_pcb, 19V 10A Standalone.kicad_sch]
2023-06-21 19V 10A Standalone PCB
    Updated the standalone 19V 10A PCB. Just needs the connectors.
    [19V 10A Standalone.kicad_pcb, 19V 10A Standalone.kicad_sch]
2023-06-23 Current Sense Resistor
    Added the current sense resistor footprint
    [Bourns_-_CSS2H-3920R-L300F.step]
2023-06-23 19V 10A Standalone PCB
    Final design of the Boost converter should be finished, double check if possible please!
    [19V 10A Standalone.kicad_pcb, 19V 10A Standalone.kicad_sch]
2023-06-24 Current Sense Standalone PCB
    Added the KiCad Schematic/PCB to the RPS01 folder
    [Current Sense Standalone.kicad_pcb, Current Sense Standalone.kicad_sch]
2023-06-24 Current Sense
    Updated schematic
    [Current Sense Standalone.kicad_sch]
2023-06-24 Update 19V 10A Standalone.kicad_pcb
    Fixed Ground planes
    [19V 10A Standalone.kicad_pcb]
2023-06-24 fixzed super bad issue on ground plane
    [19V 10A Standalone.kicad_pcb]
2023-06-24 solid vs thermal ground planes
    [19V 10A Standalone.kicad_pcb]
2023-06-24 updated Current sense circuit
    [Current Sense Standalone.kicad_sch]
2023-06-24 Current Circuit setup.
    [Current Sense Standalone.kicad_sch]
2023-06-24 Organized Folder
    [19V 10A Standalone.kicad_pcb, 19V 10A Standalone.kicad_sch, Current Sense Standalone.kicad_pcb, Current Sense Standalone.kicad_sch, M_MUC.kicad_pcb, M_MUC.kicad_sch]
2023-06-24 Current Sense Update
    Added cap filter
    [Current Sense Standalone.kicad_sch]
2023-06-26 100kohm load resistor
    Added 100kohm load resistor symbol and footprint for the current sense.
    [RC1206FR-13100KL.step]
2023-06-26 Current Sense Update
    Updated footprints for the headers. Just waiting on which capacitors we will use.
    [Current Sense Standalone.kicad_sch]
2023-06-26 New Update
    [MCU2.kicad_pcb, MCU2.kicad_sch]
2023-06-27 Current Sense
    Updated PCB and Gerber Files
    [Current Sense Standalone-B_Cu.gbl, Current Sense Standalone-B_Mask.gbs, Current Sense Standalone-B_Paste.gbp, Current Sense Standalone-B_Silkscreen.gbo, Current Sense Standalone-Edge_Cuts.gm1, Current Sense Standalone-F_Cu.gtl, Current Sense Standalone-F_Mask.gts, Current Sense Standalone-F_Paste.gtp]
2023-06-27 Boost Converter
    Added Gerber Files
    [19V 10A Standalone-B_Cu.gbl, 19V 10A Standalone-B_Mask.gbs, 19V 10A Standalone-B_Paste.gbp, 19V 10A Standalone-B_Silkscreen.gbo, 19V 10A Standalone-Edge_Cuts.gm1, 19V 10A Standalone-F_Cu.gtl, 19V 10A Standalone-F_Mask.gts, 19V 10A Standalone-F_Paste.gtp]
2023-06-27 Zipped Gerber Files
2023-06-28 ADR symbol and footprint
2023-07-06 Current Sense Update
    [Current Sense Standalone.kicad_pcb, Current Sense Standalone.kicad_sch]
2023-08-02 Add Current Sense Simulation
    [ina139 test circuit.dsn, ina139 test circuit.opj]
2023-08-23 Updated Current Sense Standalone
    new footprint for R_SENSE and fixed header pins
    [Current Sense Standalone.kicad_pcb, Current Sense Standalone.kicad_sch]
2023-08-24 add fuse footprints
    [0PAL4100XP.blend]
2023-08-24 Mill Current Sense PCB
    [Current Sense Standalone-B_Cu.gbl, Current Sense Standalone-B_Mask.gbs, Current Sense Standalone-B_Paste.gbp, Current Sense Standalone-B_Silkscreen.gbo, Current Sense Standalone-Edge_Cuts.gm1, Current Sense Standalone-F_Cu.gtl, Current Sense Standalone-F_Mask.gts, Current Sense Standalone-F_Paste.gtp]
2023-08-26 Made traces a bit thicker for current sense
    [Current Sense Standalone-B_Cu.gbl, Current Sense Standalone-B_Mask.gbs, Current Sense Standalone-B_Paste.gbp, Current Sense Standalone-B_Silkscreen.gbo, Current Sense Standalone-Edge_Cuts.gm1, Current Sense Standalone-F_Cu.gtl, Current Sense Standalone-F_Mask.gts, Current Sense Standalone-F_Paste.gtp]
2023-08-29 tweaked traces
    [Current Sense Standalone-B_Cu.gbl, Current Sense Standalone-B_Mask.gbs, Current Sense Standalone-B_Paste.gbp, Current Sense Standalone-B_Silkscreen.gbo, Current Sense Standalone-Edge_Cuts.gm1, Current Sense Standalone-F_Cu.gtl, Current Sense Standalone-F_Mask.gts, Current Sense Standalone-F_Paste.gtp]
2023-08-29 [internal screaming]
    [Current Sense Standalone-B_Cu.gbl, Current Sense Standalone-B_Mask.gbs, Current Sense Standalone-B_Paste.gbp, Current Sense Standalone-B_Silkscreen.gbo, Current Sense Standalone-Edge_Cuts.gm1, Current Sense Standalone-F_Cu.gtl, Current Sense Standalone-F_Mask.gts, Current Sense Standalone-F_Paste.gtp]
2023-08-30 Fuse test circuit and updated current sense
    [Current Sense Standalone-B_Cu.gbl, Current Sense Standalone-B_Mask.gbs, Current Sense Standalone-B_Paste.gbp, Current Sense Standalone-B_Silkscreen.gbo, Current Sense Standalone-Edge_Cuts.gm1, Current Sense Standalone-F_Cu.gtl, Current Sense Standalone-F_Mask.gts, Current Sense Standalone-F_Paste.gtp]
2023-08-31 Current Sense (High Current)
    Made a copy of the current sense KiCad file to implement for high current.
    [Current Sense Standalone-B_Cu.gbl, Current Sense Standalone-B_Mask.gbs, Current Sense Standalone-B_Paste.gbp, Current Sense Standalone-B_Silkscreen.gbo, Current Sense Standalone-Edge_Cuts.gm1, Current Sense Standalone-F_Cu.gtl, Current Sense Standalone-F_Mask.gts, Current Sense Standalone-F_Paste.gtp]
2023-08-31 rearranged schematic for current sense
    [Current Sense Standalone.kicad_pcb, Current Sense Standalone.kicad_sch]
2023-08-31 Current Sense Dimensions
    Adjusted dimensions of the width and length of the board. Still in-progress with the components.
    [Current Sense Standalone.kicad_pcb]
2023-09-01 Update Current Sense Standalone.kicad_pcb
    [Current Sense Standalone.kicad_pcb]
2023-09-02 Resume Builder - Jaxon
    [Current Sense Standalone.kicad_pcb]
2023-09-02 MCU Single side board
    [mcu_singleside.kicad_pcb, mcu_singleside.kicad_sch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]
2023-09-04 Current Sense (High Current)
    Fixed plane connections
    [Current Sense Standalone.kicad_pcb]
2023-09-05 Add Current Sense to RPS01
    [Current_Sense.kicad_sch, Microcontroller.kicad_sch, rps01.kicad_sch]
2023-09-05 Add Fuses and other ADC pin
    [Current_Sense.kicad_sch, Microcontroller.kicad_sch, rps01.kicad_sch]
2023-09-06 adjustments to main board revision
    [12V_Buck_Boost.kicad_sch, 5V_Buck.kicad_sch, Current_Sense.kicad_sch, Load_Sharing.kicad_sch, Microcontroller.kicad_sch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]
2023-09-06 Current Sense Gerber and Drill Files (9-6-23)
    [Current Sense Standalone-B_Cu.gbl, Current Sense Standalone-B_Mask.gbs, Current Sense Standalone-B_Paste.gbp, Current Sense Standalone-B_Silkscreen.gbo, Current Sense Standalone-Edge_Cuts.gm1, Current Sense Standalone-F_Cu.gtl, Current Sense Standalone-F_Mask.gts, Current Sense Standalone-F_Paste.gtp]
2023-09-07 added rails and sensors
    [Rails.kicad_sch, Sensors.kicad_sch, rps01.kicad_sch]
2023-09-07 PCB Update
    [rps01.kicad_pcb]
2023-09-07 PCB Updates
    [rps01.kicad_pcb]
2023-09-07 THT to SMD
    [Microcontroller.kicad_sch]
2023-09-07 update pcb
    [rps01.kicad_pcb]
2023-09-07 PCB and added second ESC Output
    [Microcontroller.kicad_sch, rps01.kicad_pcb, rps01.kicad_sch]
2023-09-07 Buck Converter (LM2596)
    Got the symbols, footprints, and datasheet for the LM2596 IC. Created a schematic. Just need to do the PCB layout and add the footprints.
    [Buck Converter.kicad_pcb, Buck Converter.kicad_sch, LM2596SX-ADJ.step]
2023-09-07 Updated PCB
    [rps01.kicad_pcb]
2023-09-07 updated shunt resistor
    [Current_Sense.kicad_sch, rps01.kicad_pcb]
2023-09-07 Start Demo code for devices
2023-09-08 Temperature reading is sort of working
2023-09-08 fixed temperature code
2023-09-08 Buck Converter
    [Buck Converter.kicad_pcb, Buck Converter.kicad_sch]
2023-09-08 added 3d models
    [User Library-128x64I2COLEDDisplayAdafruit.STEP]
2023-09-08 Added Models
    [User Library-XT90PB-F.STEP, User Library-XT90PB-M.STEP]
2023-09-08 Update Buck Converter.kicad_pcb
    [Buck Converter.kicad_pcb]
2023-09-08 update buck dimensions
    [Buck Converter-B_Cu.gbr, Buck Converter-B_Mask.gbr, Buck Converter-B_Paste.gbr, Buck Converter-B_Silkscreen.gbr, Buck Converter-Edge_Cuts.gbr, Buck Converter-F_Cu.gbr, Buck Converter-F_Mask.gbr, Buck Converter-F_Paste.gbr]
2023-09-08 1206 to 0603
    [Microcontroller.kicad_sch]
2023-09-09 Huge PCB Update
    [Current_Sense.kicad_sch, LLC.kicad_sch, rps01.kicad_pcb, rps01.kicad_sch]
2023-09-09 Fixed Plane
    [rps01.kicad_pcb]
2023-09-09 Finished Load Sharing and Current Sense
    [Current_Sense.kicad_sch, LLC.kicad_sch, rps01.kicad_pcb]
2023-09-09 MCU Changes
    [LLC.kicad_sch, Microcontroller.kicad_sch, rps01.kicad_pcb]
2023-09-09 Added Screen to MCU
    [rps01.kicad_sch]
2023-09-10 LLC schematic
    [LLC.kicad_sch]
2023-09-10 4.7K R
    [LLC.kicad_sch, Microcontroller.kicad_sch, rps01.kicad_sch]
2023-09-10 fix LLC and add temperature sensor page
    [Current_Sense.kicad_sch, LLC.kicad_sch, Load_Sharing.kicad_sch, Microcontroller.kicad_sch, Rails.kicad_sch, TempSensors.kicad_sch, rps01.kicad_sch]
2023-09-10 small fuse symbol and footprint
2023-09-10 updated MCU
    [Current_Sense.kicad_sch, LLC.kicad_sch, Load_Sharing.kicad_sch, Microcontroller.kicad_sch, Rails.kicad_sch, TempSensors.kicad_sch, rps01.kicad_sch]
2023-09-10 Large Schematic Update
    [Current_Sense.kicad_sch, Display.kicad_sch, LLC.kicad_sch, Load_Sharing.kicad_sch, Microcontroller.kicad_sch, Rails.kicad_sch, TempSensors.kicad_sch, VoltSense.kicad_sch]
2023-09-10 Huge Schematic Update
    [CurrentSense2_sch.kicad_sch, Display.kicad_sch, VoltSense.kicad_sch, rps01.kicad_sch]
2023-09-10 Finished most of the Schematics. Needs polishing
    [CurrentSense2_sch.kicad_sch, Current_Sense.kicad_sch, Display.kicad_sch, Inputs.kicad_sch, LLC.kicad_sch, Load_Sharing.kicad_sch, Microcontroller.kicad_sch, Probe.kicad_sch]
2023-09-10 Finished Updating Footprints and Reorganized Reference Designators
    Finished Updating Footprints and Reorganized Reference Designators
    Starting to work on Final PCB, except for 19V Boost. Please check Schematic for errors
    [CurrentSense2_sch.kicad_sch, Current_Sense.kicad_sch, Display.kicad_sch, Inputs.kicad_sch, LLC.kicad_sch, Load_Sharing.kicad_sch, Microcontroller.kicad_sch, Probe.kicad_sch]
2023-09-10 minor update
    [Probe.kicad_sch, rps01.kicad_sch]
2023-09-10 add resistor and cap values for buck
    [Rails.kicad_sch]
2023-09-10 add 19v boost from other ver
    [Rails.kicad_sch]
2023-09-11 Board Ready For layout. Except for 19V Boost? CHECK vs SIM Please
    Board Ready For layout. Except for 19V Boost? CHECK vs SIM Please
    [CurrentSense2_sch.kicad_sch, Current_Sense.kicad_sch, Display.kicad_sch, Inputs.kicad_sch, LLC.kicad_sch, Load_Sharing.kicad_sch, Microcontroller.kicad_sch, Probe.kicad_sch]
2023-09-11 Layout Progress
    [CurrentSense2_sch.kicad_sch, Current_Sense.kicad_sch, Inputs.kicad_sch, LLC.kicad_sch, Load_Sharing.kicad_sch, Microcontroller.kicad_sch, Rails.kicad_sch, VoltSense.kicad_sch]
2023-09-11 Last Update before HW Break
    [rps01.kicad_pcb]
2023-09-11 move resistor labels and add models
    [0154Series_LTF.step, MSOP-10_MS_LIT.step, PRSS0004AL-A_REN.step, PW8_TEX.step, RES_5930R_L500x_BRN.step, rps01.kicad_pcb]
2023-09-11 Getting THERE. ALMOST THERE
    [CurrentSense2_sch.kicad_sch, TempSensors.kicad_sch]
2023-09-11 Completed Logic Stuff. Only Voltage Rail Stuff to Finish
    Completed Logic Stuff. Only Voltage Rail Stuff to Finish
2023-09-11 Dimensioned PCB
2023-09-11 Finished everything but test points and 19V Buck/Boost
2023-09-11 changed ltc3780 to the small one
    [Probe.kicad_sch, Rails.kicad_sch]
2023-09-11 Error Checker Complete
    [Current_Sense.kicad_sch, Probe.kicad_sch]
2023-09-11 Done. Polishing only Left
    [rps01.kicad_pcb]
2023-09-12 Added Proper Mounting Holes and Updated PCB Dimensions
    [Probe.kicad_sch, rps01.kicad_pcb]
2023-09-12 Fixed Thermal and Current Vias
    [rps01.kicad_pcb]
2023-09-12 Rounded the Corners to the PCB
    [rps01.kicad_pcb]
2023-09-12 TODO: Some minor DRC Fixes, SILKSCREEN LABELS, MASK GRAPHICS
    [rps01.kicad_pcb]
2023-09-12 Fix labels and add graphics
    [IND_CDRH127LDNP-470MC_SUM.step, PG-TDSON-8-U08_INF.step, rps01.kicad_pcb, rps01.kicad_sch, symbol_labels.kicad_sch]
2023-09-13 add jason signature and fix resistor footprint
    [Rails.kicad_sch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]
2023-09-13 fix 330uF labels
    [rps01.kicad_pcb]
2023-09-13 add V+ filter caps to current sense schematic
    [CurrentSense2_sch.kicad_sch, Current_Sense.kicad_sch]
2023-09-13 update step file and 3d pcb
    [74436410680.blend, CAP_A750KS_KEM.step, QFN-32_UH_LIT.step, XT30PW-F--3DModel-STEP-510211.STEP, XT30PW-F--3DModel-STEP-510211_1.STEP, rps01.kicad_pcb]
2023-09-13 update cap and resistor values
    [Current_Sense.kicad_sch, Rails.kicad_sch, VoltSense.kicad_sch]
2023-09-14 add secondary voltage current sensing
2023-09-15 RGB——board
    [RGB.kicad_pcb, RGB.kicad_sch]
2023-09-15 LED code
2023-09-15 Updated Caps
    [ADR02AUJZ-REEL7.step, Rails.kicad_sch, rps01.kicad_pcb]
2023-09-15 fixed errors
    [rps01.kicad_pcb]
2023-09-15 push check
    [rps01.kicad_pcb]
2023-09-15 update probe text and start fuse model
    [Probe.kicad_sch, fuse.blend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]
2023-09-15 code / rgb cnc / enable simulation
    [RGB-Edge_Cuts.gbr, RGB-F_Cu.gbr, RGB-NPTH-drl_map.gbr, RGB-NPTH.drl, RGB-PTH-drl_map.gbr, RGB-PTH.drl, RGB-job.gbrjob]
2023-09-17 Fixed Ignore List
    [CurrentSense2_sch.kicad_sch, Current_Sense.kicad_sch, Inputs.kicad_sch, LLC.kicad_sch, Load_Sharing.kicad_sch, Microcontroller.kicad_sch, Rails.kicad_sch, VoltSense.kicad_sch]
2023-09-17 Ready For JLC
    [Rails.kicad_sch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]
2023-09-17 Fixed and mention error on R1 Board
    [rps01.kicad_pcb]
2023-09-17 added xt30 steps
    [User Library-xt30-f.STEP, User Library-xt30upb-m.STEP]
2023-09-18 Added RPS01 Revision 1 Final BOM
    [rps01.csv]
2023-09-21 Current Sense Rails C_22 from 80p to 0.1u
    [CurrentSense2_sch.kicad_sch, Rails.kicad_sch]
2023-09-22 Mech Drawings
    [rps01.kicad_pcb]
2023-09-22 3d models
    [Aluminum Heatsink.3mf, Aluminum Heatsink.stl]
2023-09-22 Added the Plastic top
    [Acrylic Top.stl, Acyrlic Top One Piece.3mf]
2023-09-22 update renders and change xt30 models
    [rps01.kicad_pcb]
2023-09-26 update some rgb codes and led pinouts
2023-09-27 changed adc pinout, more error checks
    [controller.ino, peripheral.ino]
2023-09-27 Orange LED update
2023-09-27 ken update load sharing
    [Load_Sharing.kicad_sch]
2023-09-27 update load sharing enable
    [LLC.kicad_sch, Rails.kicad_sch]
2023-09-27 change back enable
    [Load_Sharing.kicad_sch]
2023-09-28 Made rev 3 folder
    [CurrentSense2_sch.kicad_sch, Current_Sense.kicad_sch, Display.kicad_sch, Inputs.kicad_sch, LLC.kicad_sch, Load_Sharing.kicad_sch, Microcontroller.kicad_sch, Probe.kicad_sch]
2023-09-29 current sensor update
2023-10-04 UPDATE BATTERY VOLT DIVIDER VALUES
2023-10-04 update logic level volt and fix batt1/2 adc
    [peripheral.ino]
2023-10-05 fixed adc syntax, added NOP command
    [controller.ino, peripheral.ino]
2023-10-07 fixed NOP commands and recognizing RESET
    [controller.ino, peripheral.ino]
2023-10-12 LED update
2023-10-20 addded 3780 Info
    [1155acf.xls, DC1155a.dsn, DC1155a.pcb]
2023-10-21 test code for ADC current 1
2023-10-31 add current and battery linear regression
2023-11-01 LTC3780 Circuit Ken Updates
    [KENESP32LTC370TEST.kicad_pcb, KENESP32LTC370TEST.kicad_sch]
2023-11-01 Finished Schematic
    [KENESP32LTC370TEST.kicad_sch]
2023-11-01 fixed errors. need footprints and PCB layout
    [KENESP32LTC370TEST.csv, KENESP32LTC370TEST.kicad_sch]
2023-11-01 PCB Layout Started
    [KENESP32LTC370TEST.kicad_pcb, KENESP32LTC370TEST.kicad_sch]
2023-11-01 PCB Layout Continued
    [KENESP32LTC370TEST.kicad_pcb, KENESP32LTC370TEST.kicad_sch]
2023-11-01 LTC3780 Completed. PCB Ordered
    [KENESP32LTC370TEST-B_Cu.gbl, KENESP32LTC370TEST-B_Mask.gbs, KENESP32LTC370TEST-B_Paste.gbp, KENESP32LTC370TEST-B_Silkscreen.gbo, KENESP32LTC370TEST-Edge_Cuts.gm1, KENESP32LTC370TEST-F_Cu.gtl, KENESP32LTC370TEST-F_Mask.gts, KENESP32LTC370TEST-F_Paste.gtp]
2023-11-02 make temperature collecting faster
2023-11-09 C9 update
    [Rails.kicad_sch]
2023-11-14 Footprint and symbol for new regulators
    [TS2940CW50_RPG.step]
2023-11-14 Add new LDO symbols (no footprint)
    [Rails.kicad_sch]
2023-11-14 add zener diodes
    [Rails.kicad_sch, rps01.kicad_sch]
2023-11-15 add buffer sims and edit controller.ino
    [OPAx340.OLB, OPAx340_Test_Circuit.DSN, OPAx340_Test_Circuit.OPJ, Rails.kicad_sch]
2023-11-16 Added LDO Diodes
2023-11-16 Updated Buffer, Precision LDO, new LDO
    [Microcontroller.kicad_sch, Rails.kicad_sch, VoltSense.kicad_sch]
2023-11-16 Update LTC4416_Custom_Ken.asc
    Added pull-down resistors and MCU resistors
2023-11-16 Load Sharing
    Changed wiring for the reversed MOSFETs
    [Load_Sharing.kicad_sch]
2023-11-17 peter s
    [LLC.kicad_sch]
2023-11-17 Add new inductor footprints
2023-11-17 update some references
    [Load_Sharing.kicad_sch, Rails.kicad_sch]
2023-11-17 RPS-01 Rev 2 TP Silkscreen
    Added silkscreens to testpoints
    [rps01.kicad_pcb]
2023-11-17 added 3780 Circuit
    [CurrentSense2_sch.kicad_sch, Current_Sense.kicad_sch, Inputs.kicad_sch, LLC.kicad_sch, Load_Sharing.kicad_sch, Microcontroller.kicad_sch, Rails.kicad_sch, VoltSense.kicad_sch]
2023-11-17 Deleted a bunch of crap.
    [Rails.kicad_sch, VoltSense.kicad_sch, rps01.kicad_pcb]
2023-11-17 Deleted SCreen
    [rps01.kicad_pcb]
2023-11-17 Locking and clean. Prepare for Rework
    [Display.kicad_sch, Rails.kicad_sch, rps01.kicad_pcb]
2023-11-17 last schematic update for the night ken
    [LLC.kicad_sch]
2023-11-17 add 3.3v logic footprint (shouldn't be needed but incase)
2023-11-17 Update Microcontroller.kicad_sch
    Added pull-down resistors and fixed AVCC and VCC connections with filter cap.
    [Microcontroller.kicad_sch]
2023-11-17 changes before sleep
    [rps01.kicad_pcb]
2023-11-17 Voltage rail update
    [Rails.kicad_sch]
2023-11-17 update volt sense diode refereneces
    [VoltSense.kicad_sch]
2023-11-17 Update Current sense references
    [CurrentSense2_sch.kicad_sch, Current_Sense.kicad_sch]
2023-11-18 update led resistor and voltsense references
    [Display.kicad_sch, VoltSense.kicad_sch]
2023-11-18 Button Footprints
    Changed button footprints
    [Display.kicad_sch, Inputs.kicad_sch, Rails.kicad_sch, VoltSense.kicad_sch]
2023-11-18 Update Rails.kicad_sch
    Added DNI to component values
    [Rails.kicad_sch]
2023-11-18 Updates to PCB
    [rps01.kicad_pcb]
2023-11-18 traces for load sharing done
    [rps01.kicad_pcb]
2023-11-18 revert Peter's changes
    [Microcontroller.kicad_sch]
2023-11-18 Update Current Sense 2 shunt footprint
    [CurrentSense2_sch.kicad_sch]
2023-11-18 Add Jumper for 3.3V Logic
    [Rails.kicad_sch]
2023-11-18 quick update
    [rps01.kicad_pcb]
2023-11-18 Deleted one of the caps
    [CurrentSense2_sch.kicad_sch, Rails.kicad_sch, rps01.kicad_pcb]
2023-11-18 lOGIC POWER ALMOST DONE
    [Rails.kicad_sch, rps01.kicad_pcb]
2023-11-18 Push before Jason changes 3.3V
    [Inputs.kicad_sch, Rails.kicad_sch, rps01.kicad_pcb]
2023-11-18 Cap update 3.3V
    [Rails.kicad_sch]
2023-11-18 0 ohm add to 3.3V
    [Rails.kicad_sch]
2023-11-18 Only Switches left
    [CurrentSense2_sch.kicad_sch, Microcontroller.kicad_sch, Rails.kicad_sch, TempSensors.kicad_sch, VoltSense.kicad_sch, rps01.kicad_pcb, rps01.kicad_sch]
2023-11-18 Completed everything except the 3780 and the Polishing
    [CurrentSense2_sch.kicad_sch, Rails.kicad_sch, rps01.kicad_pcb]
2023-11-18 Added 3780 and Fixed References
    [Rails.kicad_sch, rps01.kicad_pcb]
2023-11-18 Revert "Added 3780 and Fixed References"
    This reverts commit 85c2587d5771b26bef1ebaba5f57b8bbd8599db1.
    [Rails.kicad_sch, rps01.kicad_pcb]
2023-11-18 uploaded 3780? Might have to revert.
    [Rails.kicad_sch, rps01.kicad_pcb]
2023-11-19 Updated nets of Current 2 output and 3780 Globals.
    [CurrentSense2_sch.kicad_sch, Current_Sense.kicad_sch, Rails.kicad_sch, rps01.kicad_pcb, rps01.kicad_sch]
2023-11-20 Fixed many Errors on Schematic
    [CurrentSense2_sch.kicad_sch, Current_Sense.kicad_sch, Inputs.kicad_sch, LLC.kicad_sch, Load_Sharing.kicad_sch, Microcontroller.kicad_sch, Rails.kicad_sch, VoltSense.kicad_sch]
2023-11-20 Updated some MCU
    [Rails.kicad_sch]
2023-11-20 RPS01-Rev2 Silkscreen
    [rps01.kicad_pcb]
2023-11-20 Changed Schematic Refs (pg 2 to 4)
    [CurrentSense2_sch.kicad_sch, Current_Sense.kicad_sch, Display.kicad_sch, Inputs.kicad_sch, LLC.kicad_sch, Load_Sharing.kicad_sch, Microcontroller.kicad_sch, Probe.kicad_sch]
2023-11-20 Update Ref
    [TempSensors.kicad_sch, VoltSense.kicad_sch, rps01.kicad_sch]
2023-11-20 Reduced the References for Peter
    [CurrentSense2_sch.kicad_sch, Current_Sense.kicad_sch, Inputs.kicad_sch, LLC.kicad_sch, Load_Sharing.kicad_sch, Microcontroller.kicad_sch, Rails.kicad_sch, TempSensors.kicad_sch]
2023-11-20 Completed Schematic
    [CurrentSense2_sch.kicad_sch, Current_Sense.kicad_sch, Rails.kicad_sch, rps01.kicad_sch]
2023-11-20 Updated for Peter
    [rps01.kicad_pcb]
2023-11-20 Silkscreen update on PCB
    [rps01.kicad_pcb]
2023-11-20 Fixes some errors
    [rps01.kicad_pcb]
2023-11-20 Finished PCB
    [CurrentSense2_sch.kicad_sch, Current_Sense.kicad_sch, Probe.kicad_sch, Rails.kicad_sch, rps01.kicad_pcb]
2023-11-20 update silkscreen
    add notes for pinouts and sectioned regions
    [rps01.kicad_pcb]
2023-11-20 remove signatures from symbol
    [symbol_labels.kicad_sch]
2023-11-21 Added Thermal Vias and Isolated Shunt Sense
    [rps01.kicad_pcb]
2023-11-21 Updated Shunt Resistor 19V
    [KENESP32LTC370TEST.csv, Rails.kicad_sch, rps01.csv, rps01.kicad_pcb]
2023-11-21 bom and pos files
    [bom.csv, rps01.csv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]
2023-11-21 gerbers and brendan changes
    [Current_Sense.kicad_sch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]
2023-12-06 disable debug and change volt sense range
2023-12-10 fixes traces
    [Rails.kicad_sch]
2023-12-11 Update Renders
    [fuse.blend, rps01.kicad_pcb]
2023-12-12 add last render
    [CurrentSense2_sch.kicad_sch, Current_Sense.kicad_sch, Inputs.kicad_sch, LLC.kicad_sch, Load_Sharing.kicad_sch, Microcontroller.kicad_sch, Rails.kicad_sch, VoltSense.kicad_sch]
